ofauvarque/DocV4/KosmosV4System/mainDocumentation.md

<details open>
  <summary> Sommaire </summary>
  
  1. [Assemblage du caisson vidéo](doc/01_Video.md)
  2. [Assemblage du caisson batterie](doc/02_Batterie.md)
  3. [Assemblage du caisson moteur](doc/03_Moteur.md)
</details>

<!---
> [!NOTE]
> Ces ouvertures permettront de placer les connecteurs.

> [!TIP]
> Réaliser une ouverture supplémentaire pour que l'air puisse circuler et refroidir le système
>
> Si votre boitier est différent réfléchisser à la meilleur manière de l'organiser à l'intérieur
-->
