ofauvarque/DocV4/MagpiSystem/mainDocumentation.md

# **Contexte**

# **Assemblage du système**

Cette partie détaille le montage de la partie étanchétité puis l'installation de tous les composants au sein de cette dernière. L'objectif est d'obtenir le système suivant :

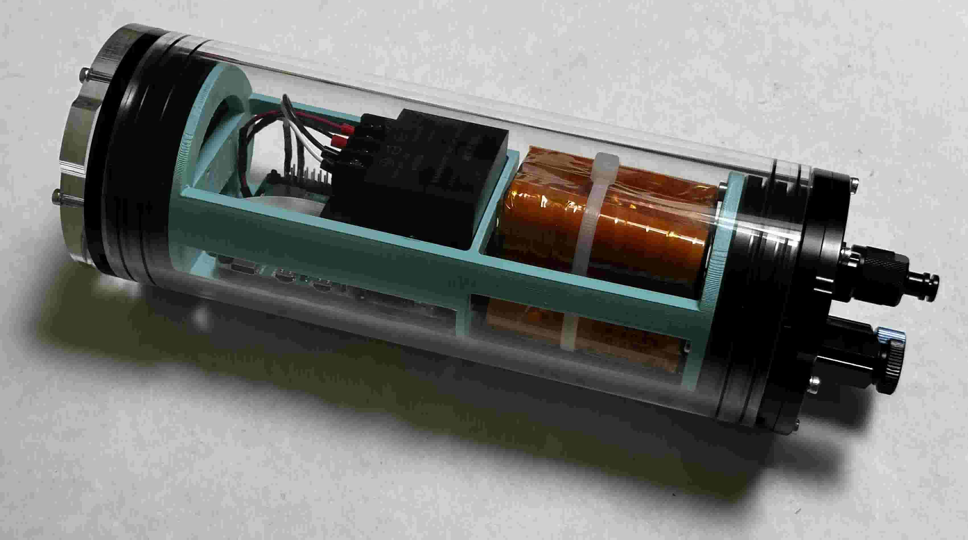
[picture p1: MagpiSystem/doc/pictures/05_Assemblage/finished.jpg]
Caisson
||
|:--:|
|*Caisson assemblé*|

## **Outils nécessaires**

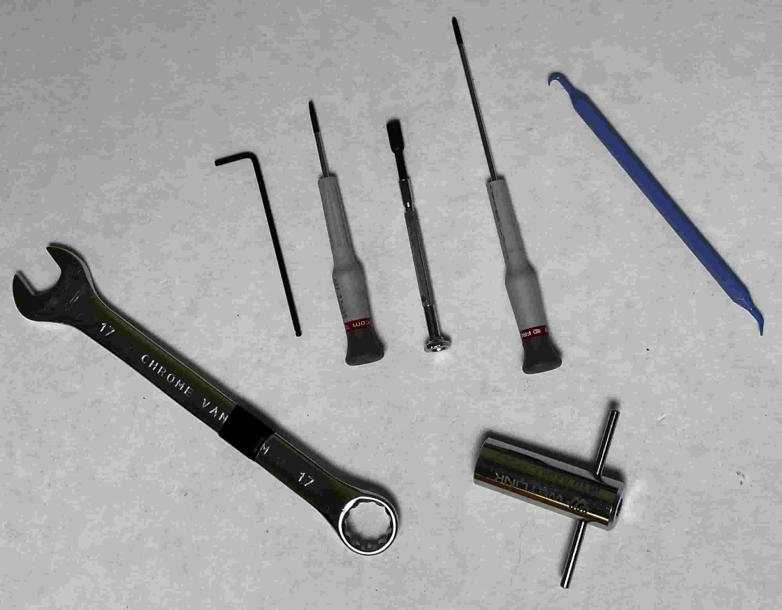
[picture p2: MagpiSystem/doc/pictures/05_Assemblage/tool_overview.jpg]
Outils


- **Clé de 17 et Clé WetLink M10**
- **Clé allen, tournevis plat/cruciforme**
- **O-ring pick**

## Assemblage du caisson étanche

Le constructeur des composants hermétique propose un tutoriel expliquant l'assemblage des bouchons du caisson avec graissage des joints : **[ici](https://youtu.be/G6PqEsKjxHM)**.

### Partie Hublot

Suivre le tutoriel précédent pour réaliser la partie "hublot"

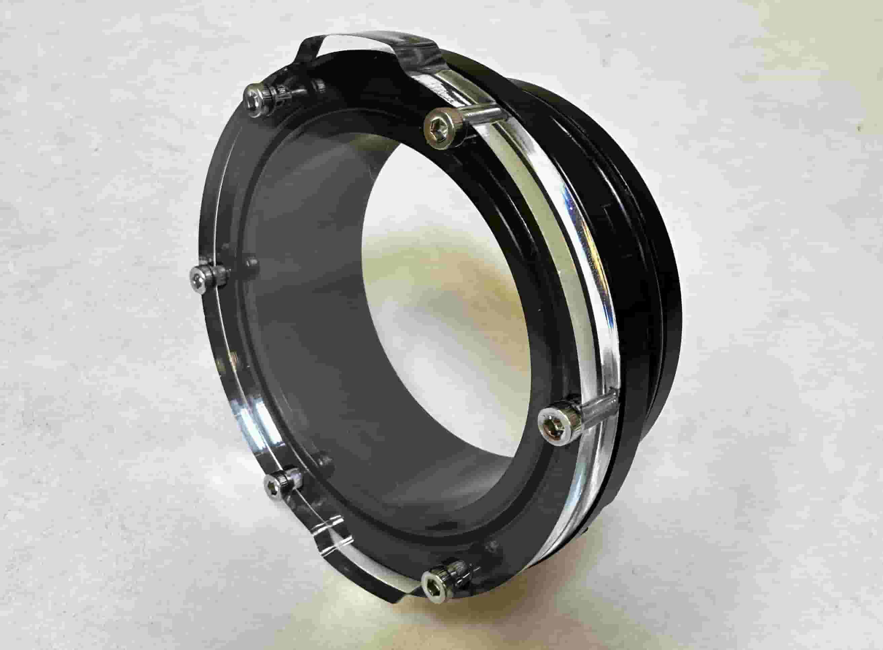
[picture p3: MagpiSystem/doc/pictures/05_Assemblage/hublot.jpg]
Hublot


### Partie connecteurs

On installe d'abord le switch, le port de charge 3 pin, la vis de purge et enfin le bouchon sur le côté en aluminium.

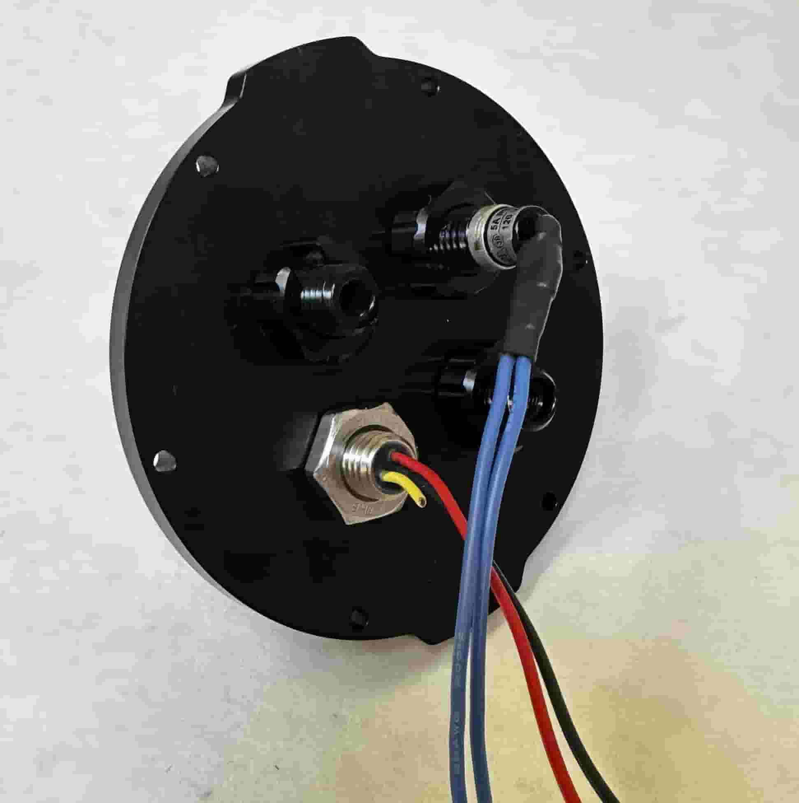
[picture p4: MagpiSystem/doc/pictures/05_Assemblage/end_cap_cables.jpg]
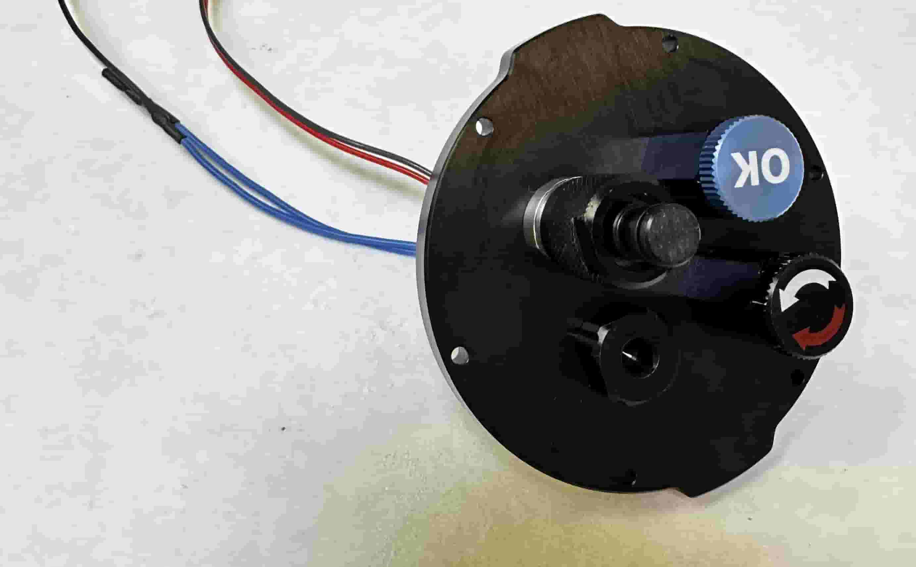
[picture p5: MagpiSystem/doc/pictures/05_Assemblage/end_cap.jpg]
 

Suivre le tutoriel pour assembler le bouchon 4 trous avec les connecteurs avec le flange. 

### Fabrication des brides de sécurité

Dévisser la vis de purge puis assembler les deux flanges et le tube en vérifiant que les détrompeurs sont bien à leur place. Insérer les deux brides de sécurité dans la gorge des deux flanges. Couper ces brides de sorte à ne laisser qu'1 cm dépasser. Mettre sur ce cm la bague et la serrer fermement.  

## Assemblage de l'électronique interne

### Composants nécessaires

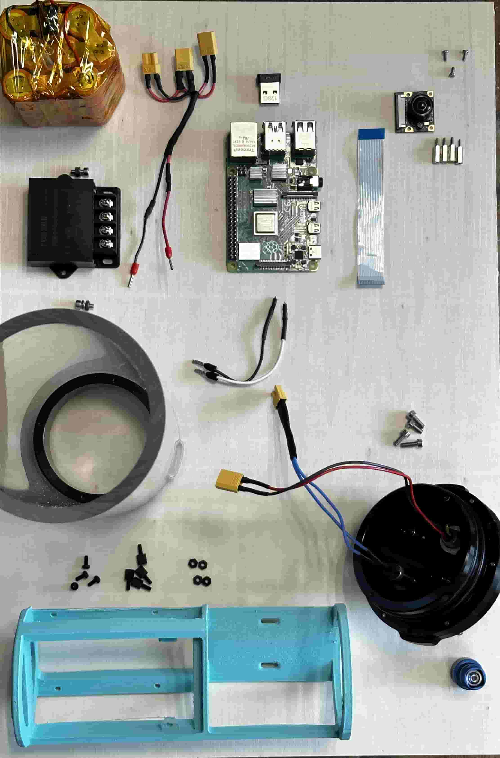
[picture p6: MagpiSystem/doc/pictures/05_Assemblage/avant_assemblage.jpg]
Composants système


- **Batterie**
- **Connecteur pieuvre**
- **Raspberry Pi**
- **Convertisseur 12V-5V**
- **Camera et sa nappe**
- **Câbles d'alimentation du Raspberry**
- **Support 3D**

### Assemblage

Fixer la flange connecteurs sur le support 3D.

Fixer ensuite le convertisseur :

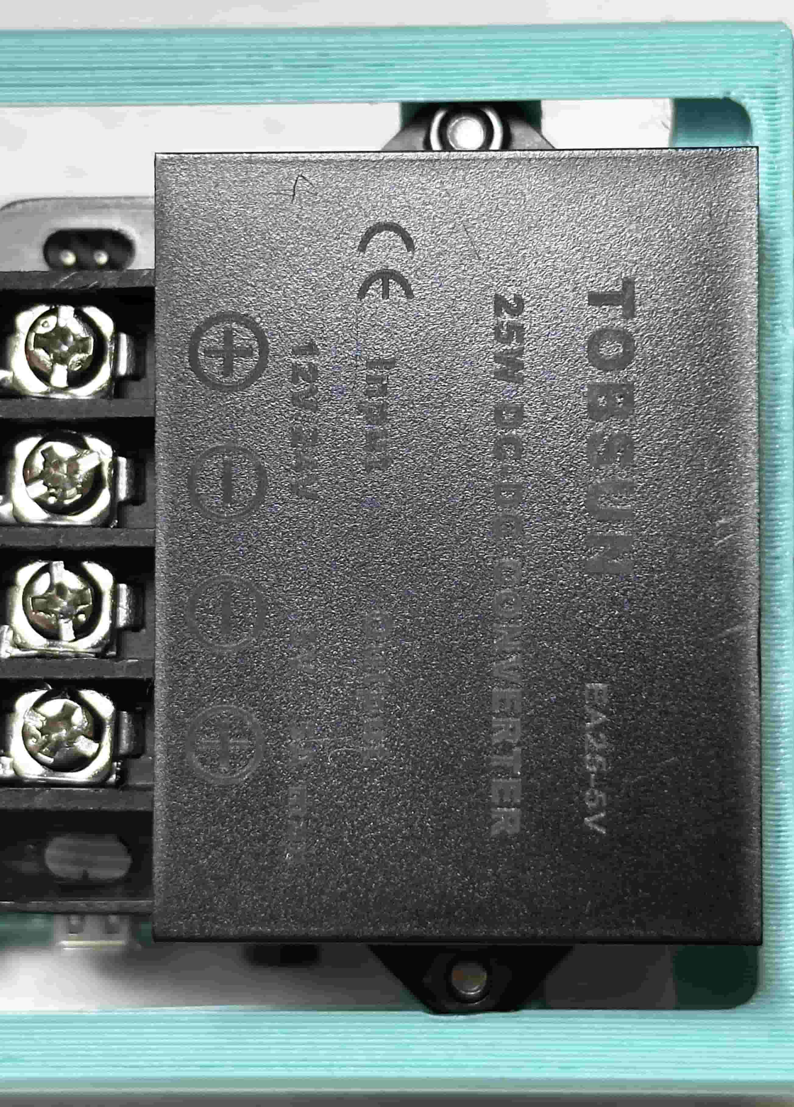
[picture p7: MagpiSystem/doc/pictures/05_Assemblage/convertisseur.jpg]
Convertisseur


Fixer la Raspberry Pi sur le support 3D. Y connecter la nappe caméra :

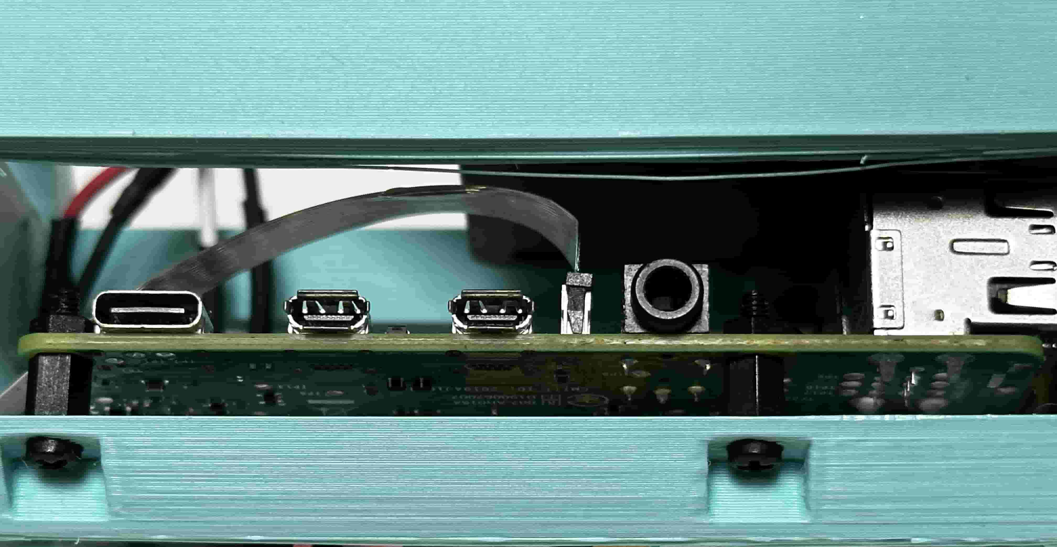
[picture p8: MagpiSystem/doc/pictures/05_Assemblage/raspberry.jpg]
Raspberry


La batterie est ensuite installé et fixée avec un serre flex, qui passe dans les encoches du support. Les câbles de la batterie passent sous la carte raspberry. Les câbles de charge et du switch sont aussi coincés par le serre flex et passent eux aussi sous la carte.

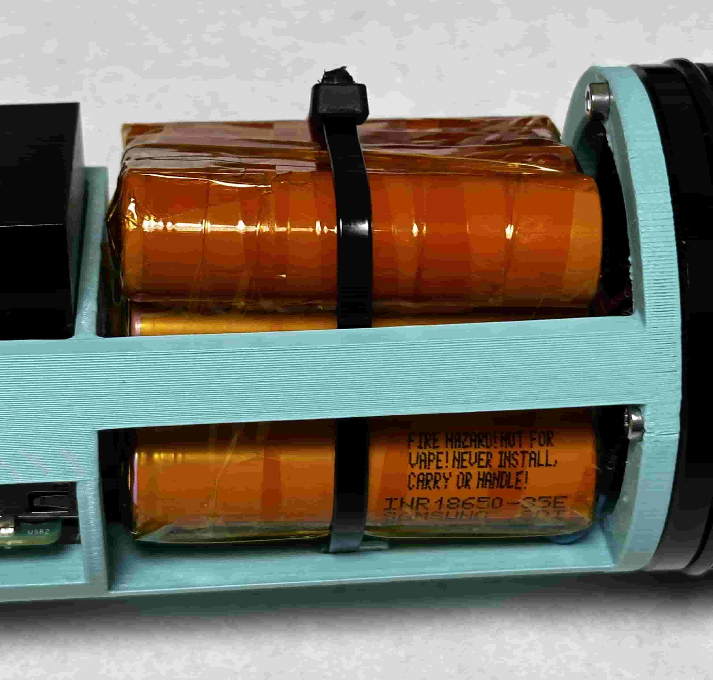
[picture p9: MagpiSystem/doc/pictures/05_Assemblage/batterie.jpg]
Batterie


### Cablage

La pieuvre est connectée aux différents éléments, en respectant bien le schéma de câblage.

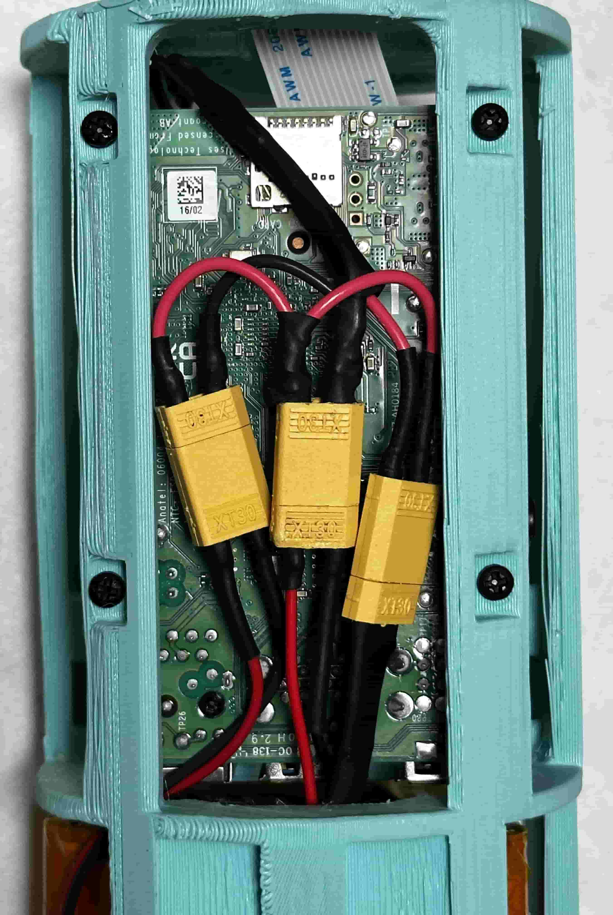
[picture p10: MagpiSystem/doc/pictures/05_Assemblage/câblage.jpg]
Câblage
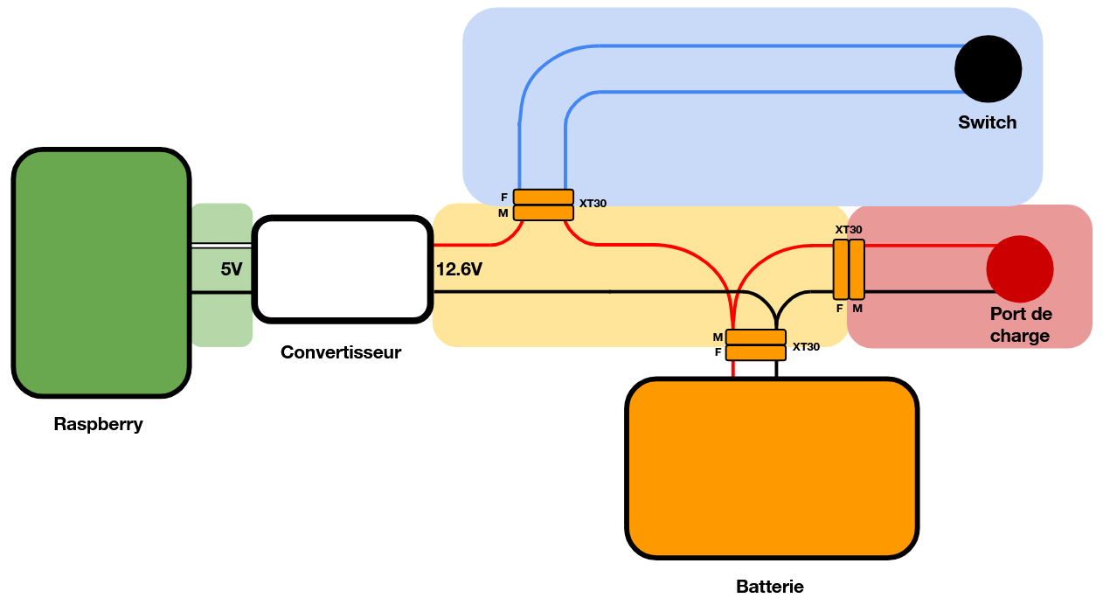
[picture p11: MagpiSystem/doc/pictures/04_Câblage/schema_cablage_couleurs.png]
Câblage
  

Les câbles sertis de la pieuvre sont connectés au convertisseur, les câbles d'alimentation de la rapsberry sont branchés sur les pin 1 et 3 de la carte.

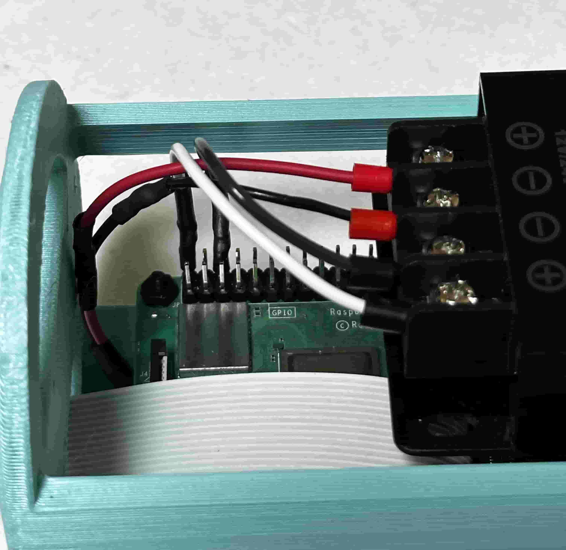
[picture p12: MagpiSystem/doc/pictures/05_Assemblage/alim_convertisseur.jpg]
Alim convertisseur


### Caméra
Fixer les entretoises sur le support 3D puis y visser la carte caméra. Brancher enfin la nappe.

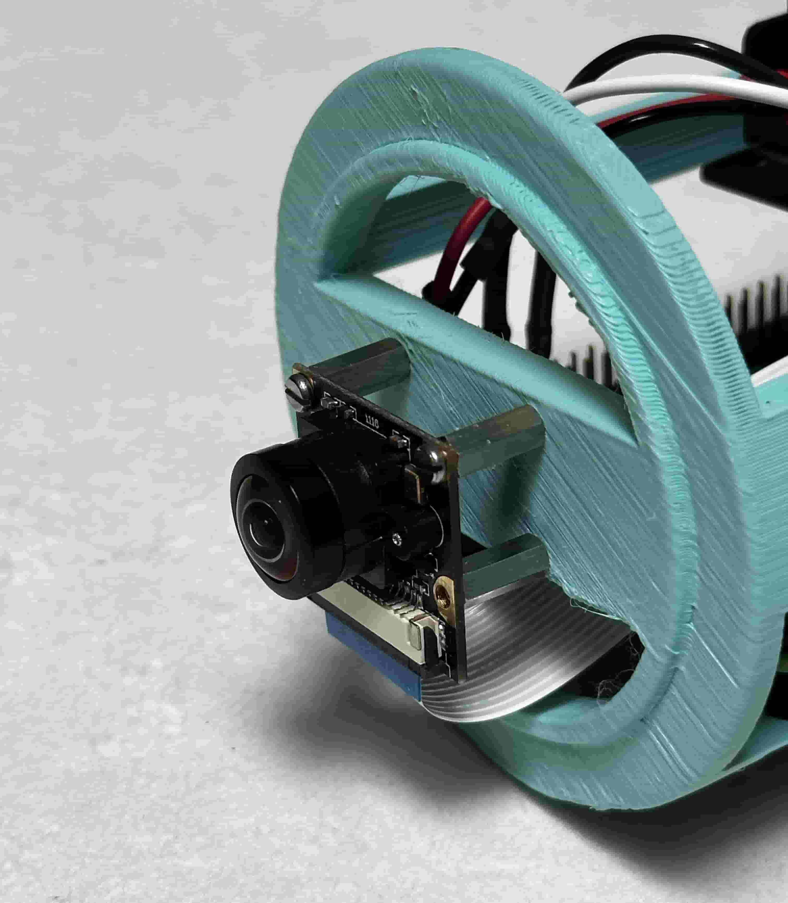
[picture p13: MagpiSystem/doc/pictures/05_Assemblage/camera.jpg]


## Installation du logiciel MagPi

Suivre les instructions de la [page web](https://github.com/KonkArLab/kosmos_software/blob/main/README.md)

Insérer enfin l'électronique dans le caisson étanche puis placer la flange hublot. Placer les brides et revisser la vis de purge.
Le système est prêt à être utilisé.

Alim convertisseur

# Mode d'emploi
