ofauvarque/DocV4/KosmosV4System/doc/01_Video.md

# Intégration mécanique & électronique interne

## Impression de la structure 3D

Imprimer la structure mécanique à l'aide d'une imprimante 3D filaire.

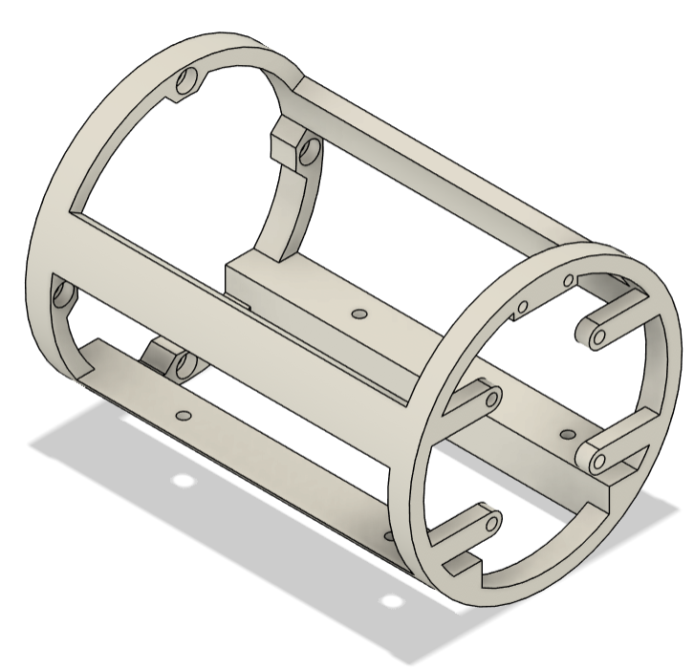
[picture p14: KosmosV4System/doc/pictures/V4_Video/Structure.PNG]


## Fixation du capteur d'ambiance lumineuse RGB

- Souder le connecteur JST 4 pin sur les bornes GND 3.3V SDA SCL de la carte électronique du capteur. (La borne INT est inutilisée.) ATTENTION, les soudures se font du côté du capteur lumineux.

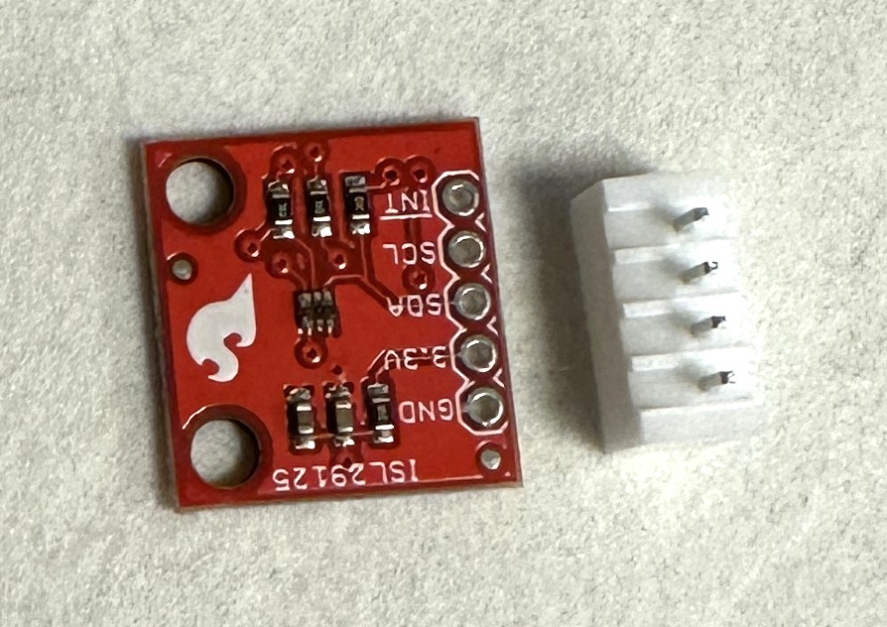
[picture p15: KosmosV4System/doc/pictures/V4_Video/IMG_1317.JPG]
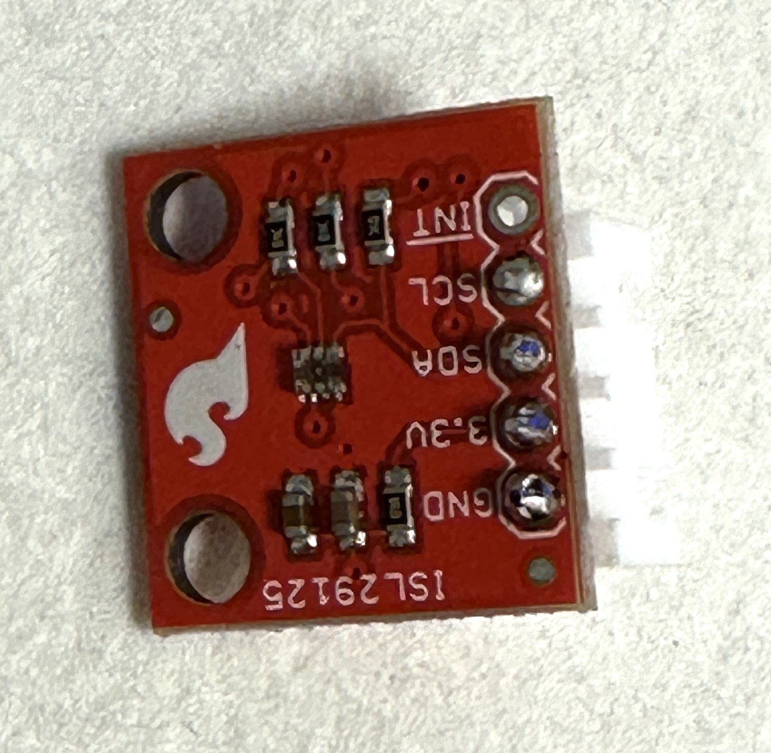
[picture p16: KosmosV4System/doc/pictures/V4_Video/IMG_1321.JPG]
 

- Sur la structure mécanique, préformer les deux trous destinés à accueillir le capteur à l'aide d'un boulon de diamètre 2.5 mm.
- Fixer le capteur sur la structure mécanique à l'aide de boulons de diamètres 2.5 mm et de longueur 6 mm. (Des boulons plus longs peuvent être utilisés mais ils ne doivent pas dépasser de la structure.)

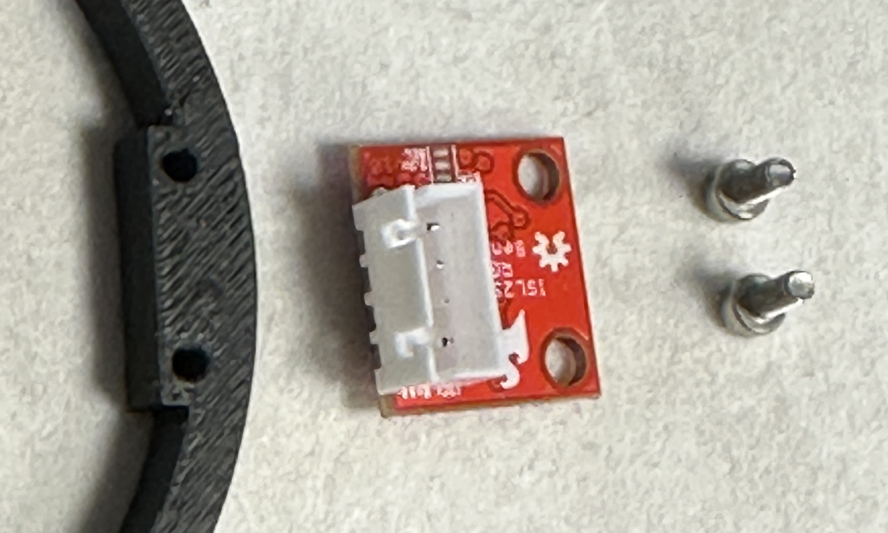
[picture p17: KosmosV4System/doc/pictures/V4_Video/IMG_1322.JPG]
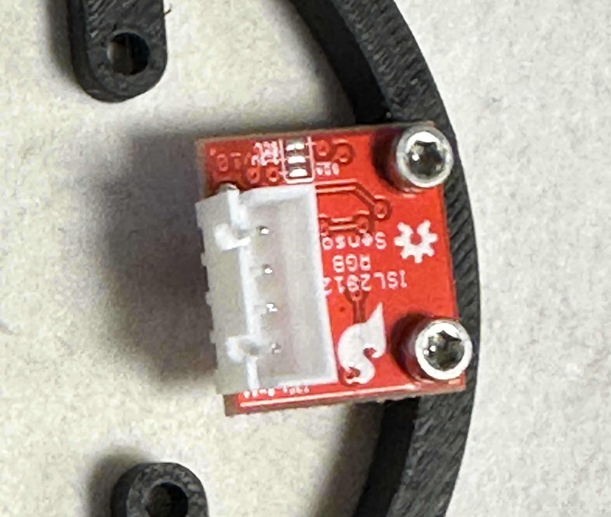
[picture p18: KosmosV4System/doc/pictures/V4_Video/IMG_1323.JPG]
 

## Fixation de la caméra
Pour un rendu de couleurs proche de celui de l'oeil humain, le capteur Picam HQ est équipé d'un filtre infra-rouge se matérialisant par une petite vitre bleue-verte devant le capteur. Ce filtre en plus de couper les infrarouges, atténue également une partie de la lumière rouge. Or celle-ci est déjà fortement atténuée par l'eau de mer. Afin d'éviter une telle perte inutile, le filtre IR du capteur Picam de KOSMOS doit être enlevé. Pour ce faire, un excellent tutoriel existe sur le site officiel de raspberry :  

https://www.raspberrypi.com/documentation/accessories/camera.html#ir-filter

A l'issue de cette opération, on obtient un capteur Picam HQ sans filtre IR (qui n'aura plus d'utilité par la suite).

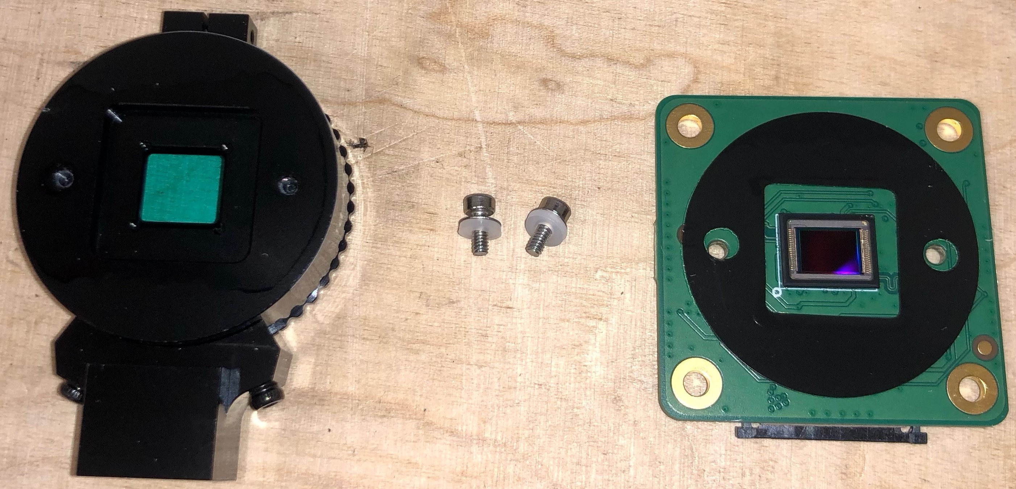
[picture p19: KosmosV4System/doc/pictures/V4_Video/11.jpeg]
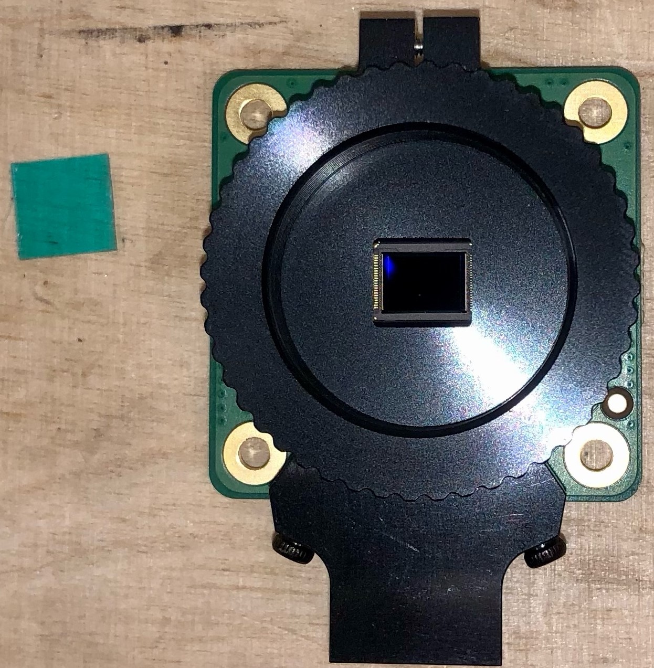
[picture p20: KosmosV4System/doc/pictures/V4_Video/9.jpeg]
 

- Oter également le support de la vis caméra.

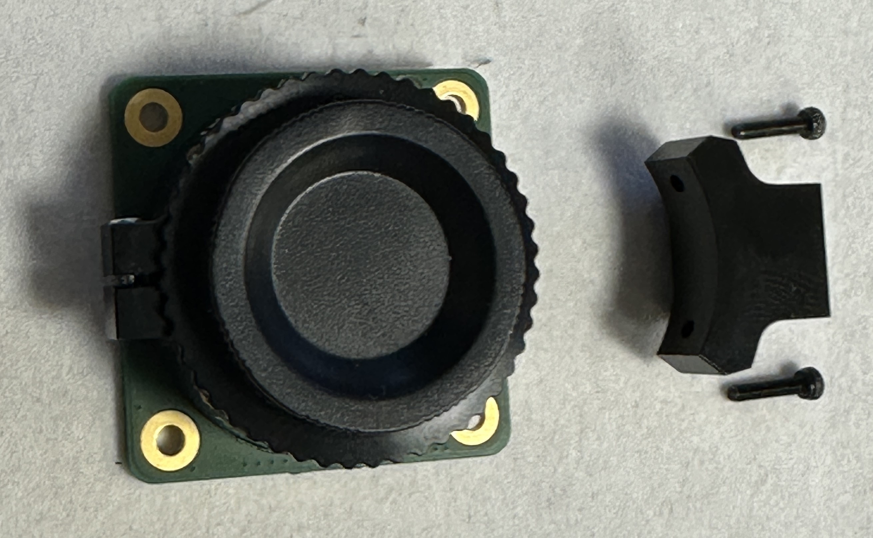
[picture p21: KosmosV4System/doc/pictures/V4_Video/IMG_1326.JPG]
 

- Fixer la capteur caméra sur la structure à l'aide de 4 boulons (diamètre 2.5 mm  et longueur 10 mm) et de 4 écrous. Attention à respecter l'orientation de la carte. 

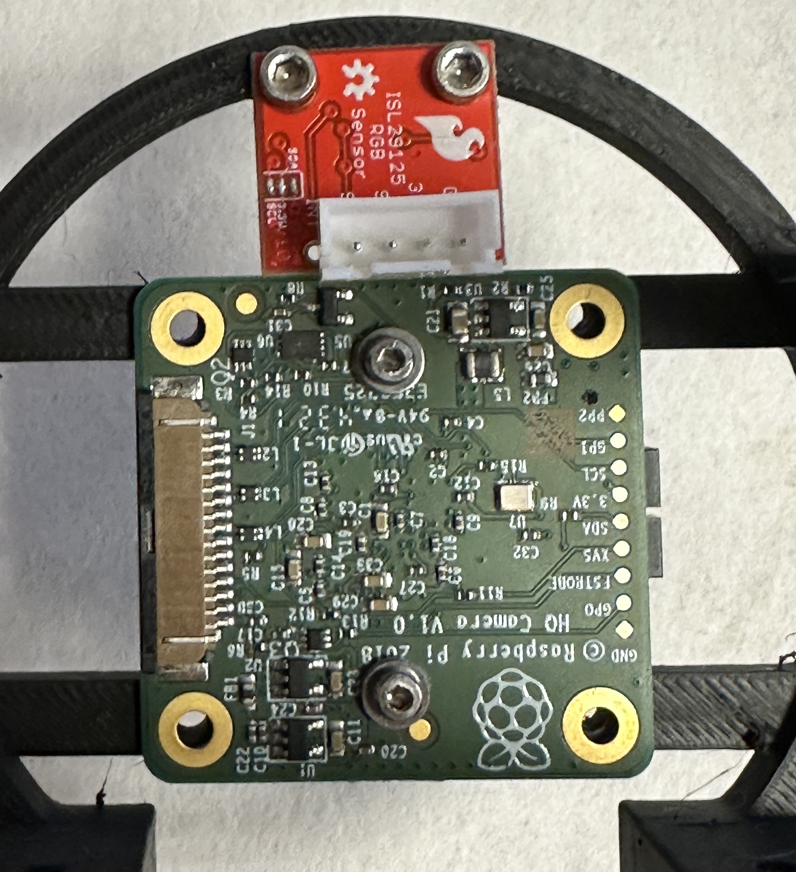
[picture p22: KosmosV4System/doc/pictures/V4_Video/IMG_1327.JPG]
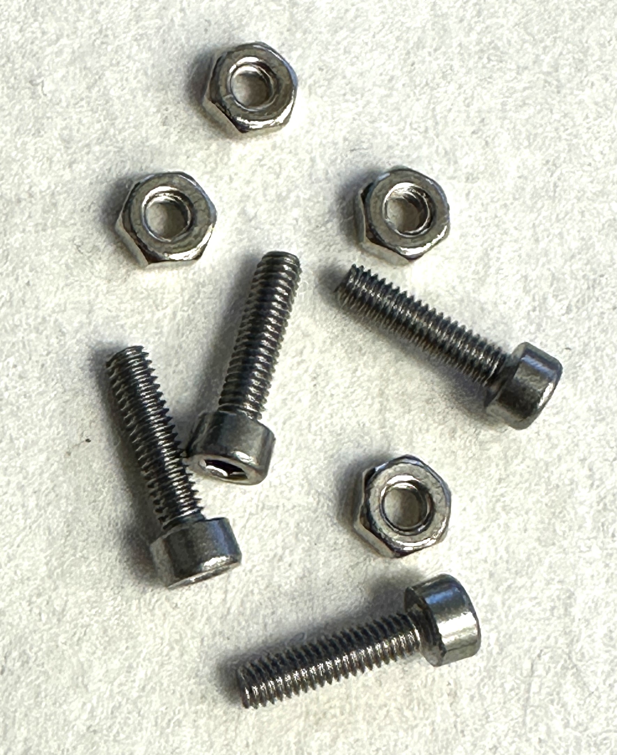
[picture p23: KosmosV4System/doc/pictures/V4_Video/IMG_1328.JPG]
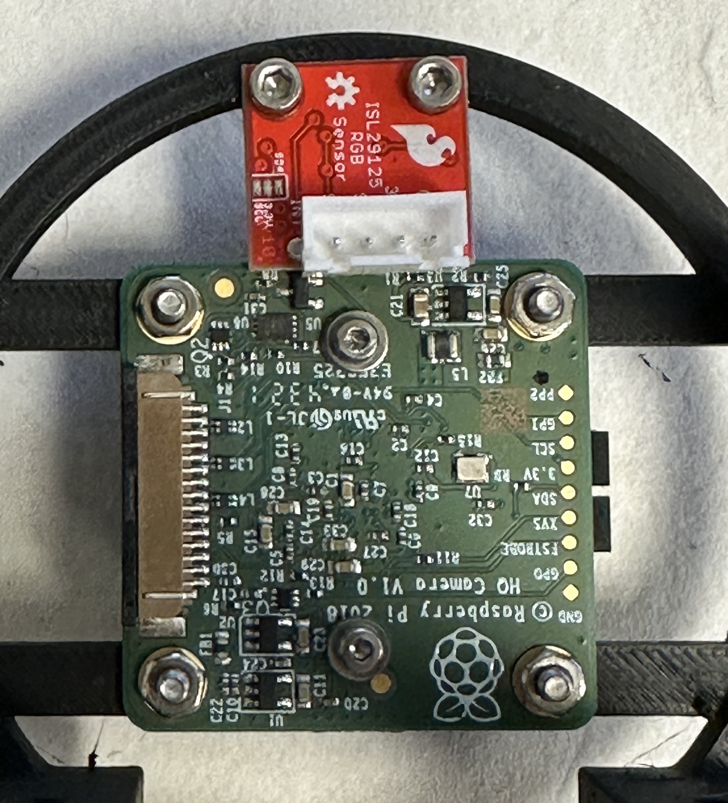
[picture p24: KosmosV4System/doc/pictures/V4_Video/IMG_1329.JPG]
   

## Fixation de la Raspberry Pi 

- Fixer les radiateurs sur la carte RPi.  Connecter ensuite le RTC à la RPi via le port BAT. Fixer la pile du RTC au dessus du port Ethernet avec le double face fourni avec le RTC. 

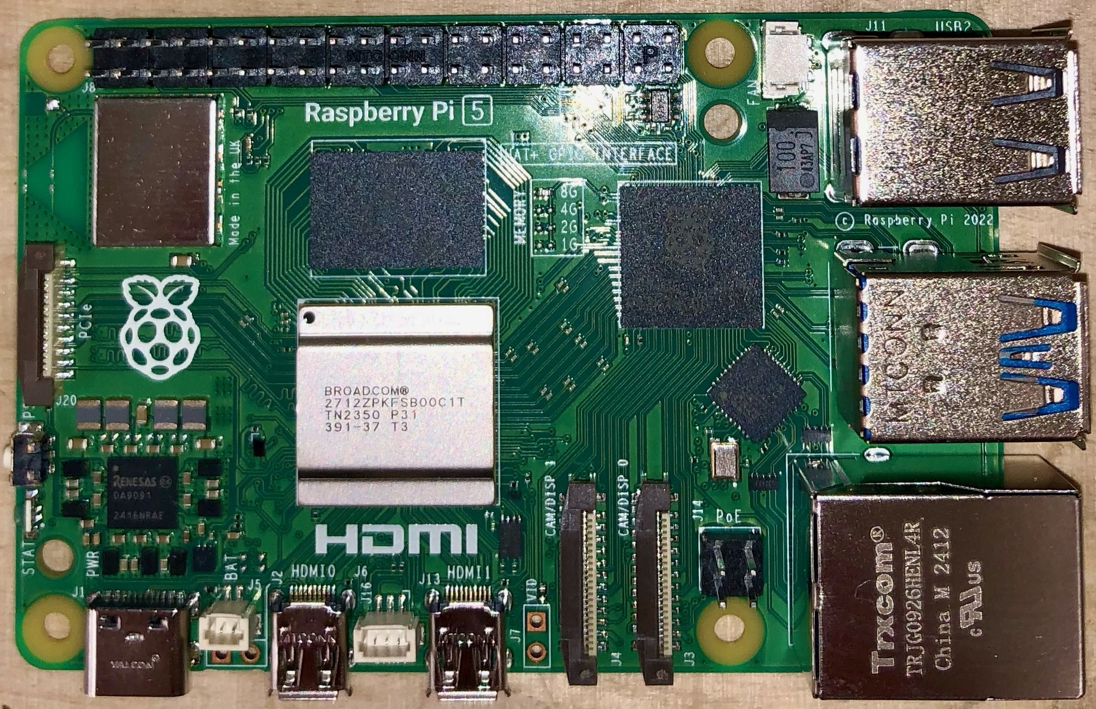
[picture p25: KosmosV4System/doc/pictures/V4_Video/19_2.jpeg]
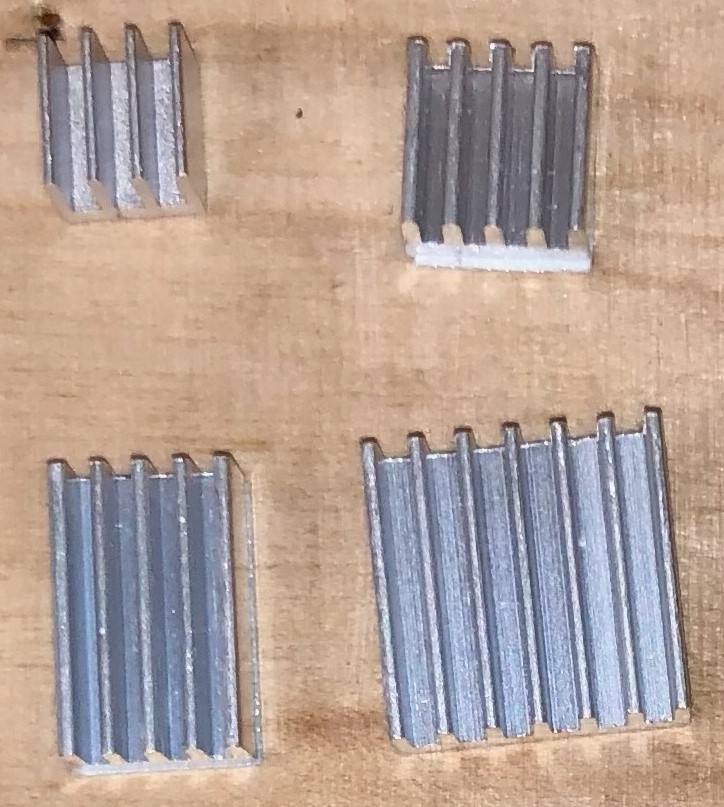
[picture p26: KosmosV4System/doc/pictures/V4_Video/19.jpeg]
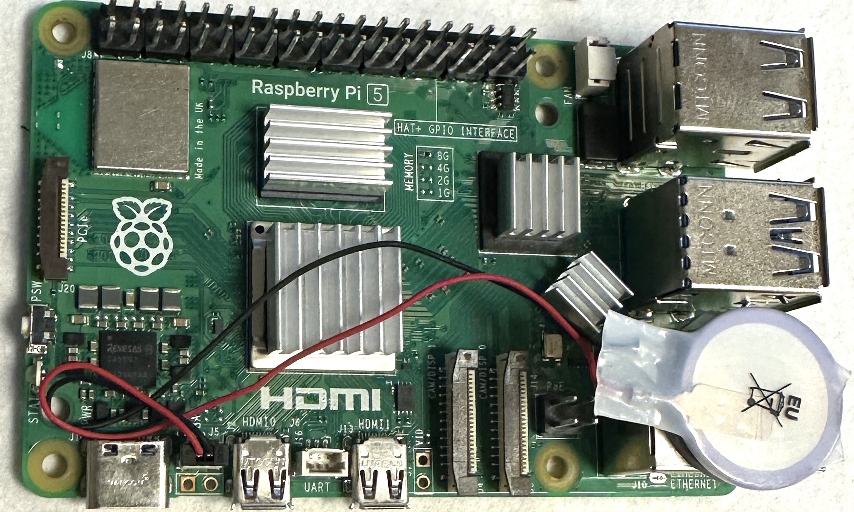
[picture p27: KosmosV4System/doc/pictures/V4_Video/IMG_13300.JPG]
  

- Assembler 4 boulons (diamètre 2.5 mm et longueur 10 mm) et 4 écrous sur chacun des trous de la RPi de la structure mécanique. Les écrous permettront de surélever légèrement la carte.

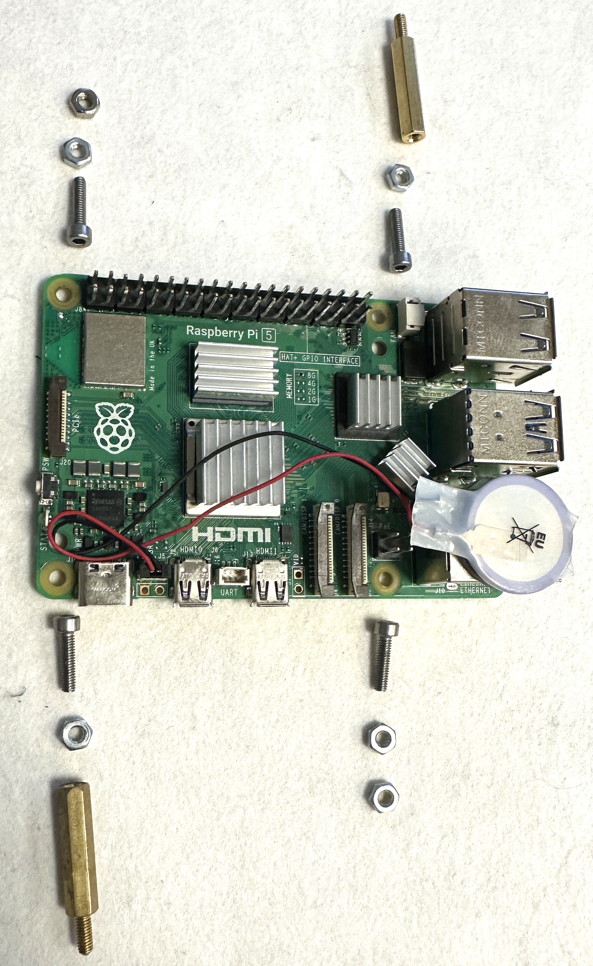
[picture p28: KosmosV4System/doc/pictures/V4_Video/IMG_1330.JPG]
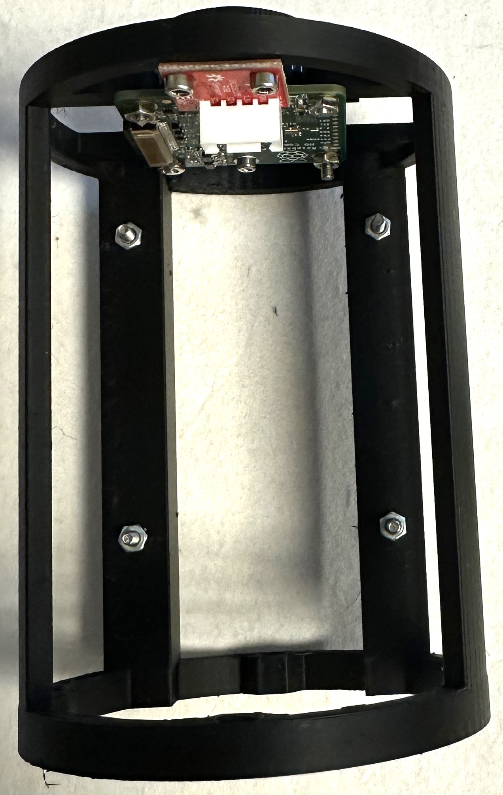
[picture p29: KosmosV4System/doc/pictures/V4_Video/IMG_1331.JPG]
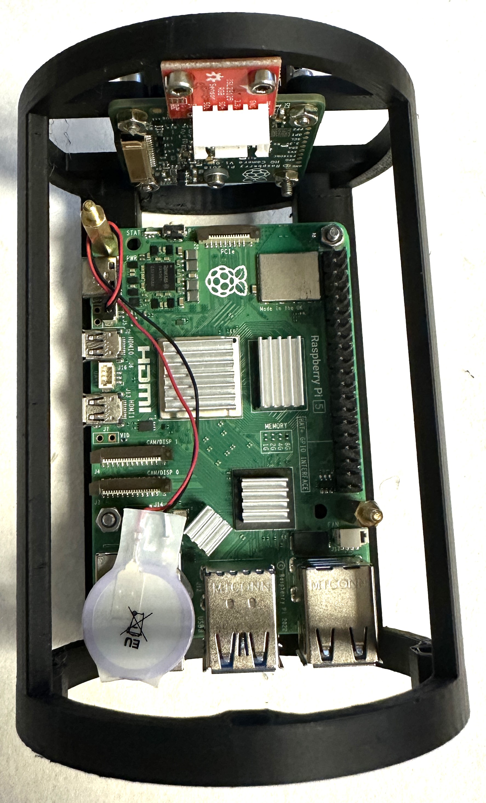
[picture p30: KosmosV4System/doc/pictures/V4_Video/IMG_1332.JPG]
  

- Positionner la carte RPi et la fixer avec deux écrous dans les coins avant droit et arrière gauche et avec deux entretoises  (diamètre 2.5 mm, hauteur 20 mm) dans les coins avant gauche et arrière droit. Connecter ensuite la nappe entre le capteur vidéo et la carte RPi.

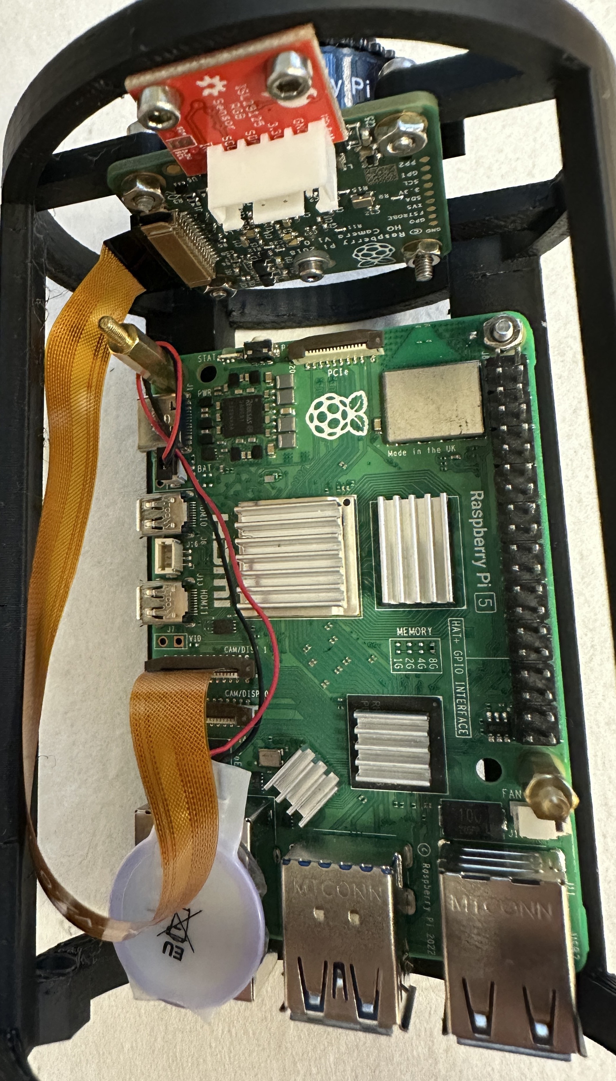
[picture p31: KosmosV4System/doc/pictures/V4_Video/IMG_1333.JPG]
 

- Insérer la clé USB dans un des deux ports USB 3.0

## Réalisation de la carte électronique

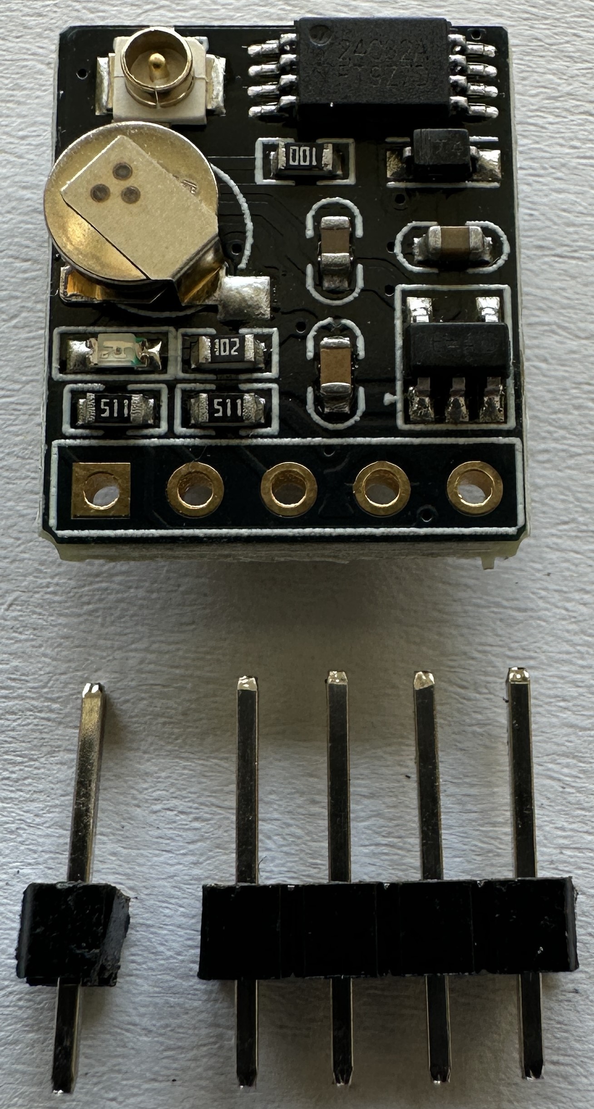
[picture p32: KosmosV4System/doc/pictures/V4_Video/IMG_0625.JPG]
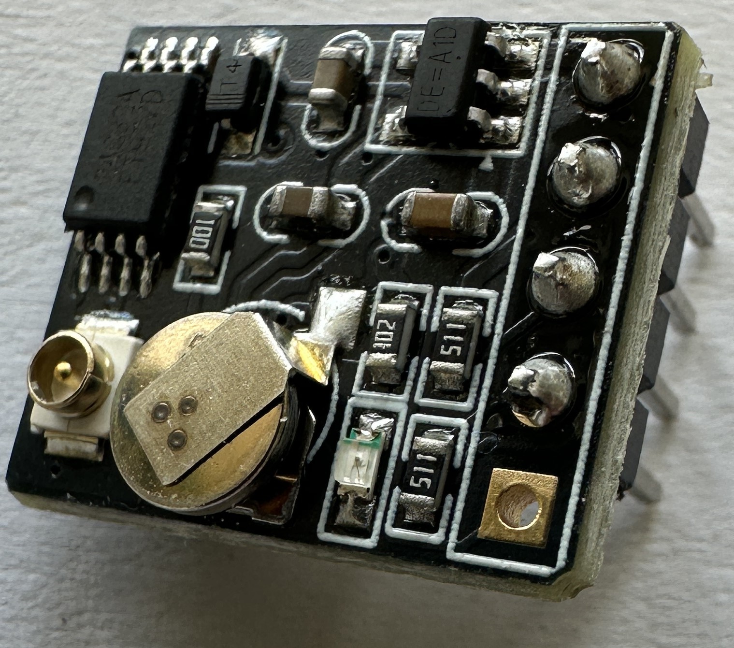
[picture p33: KosmosV4System/doc/pictures/V4_Video/IMG_0626.JPG]
 

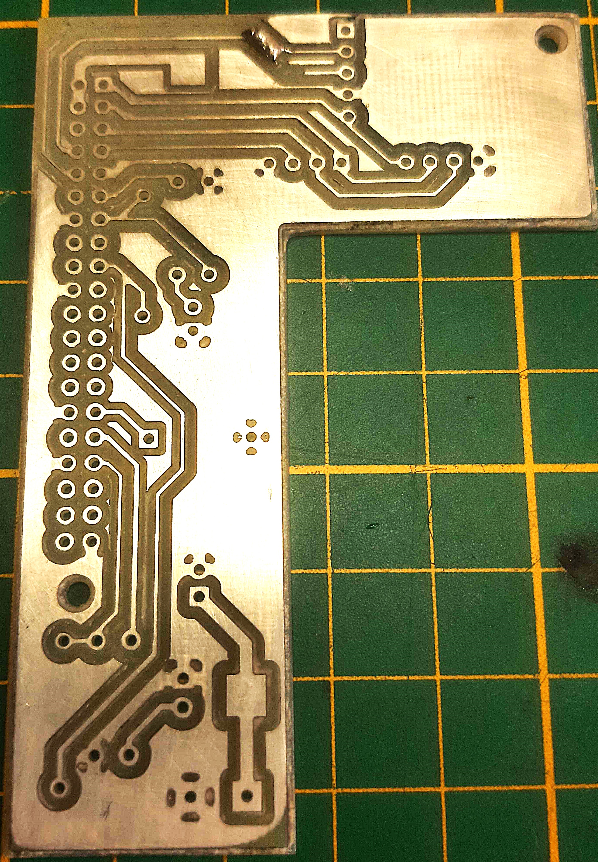
[picture p34: KosmosV4System/doc/pictures/V4_Video/20250225_141010.jpg]
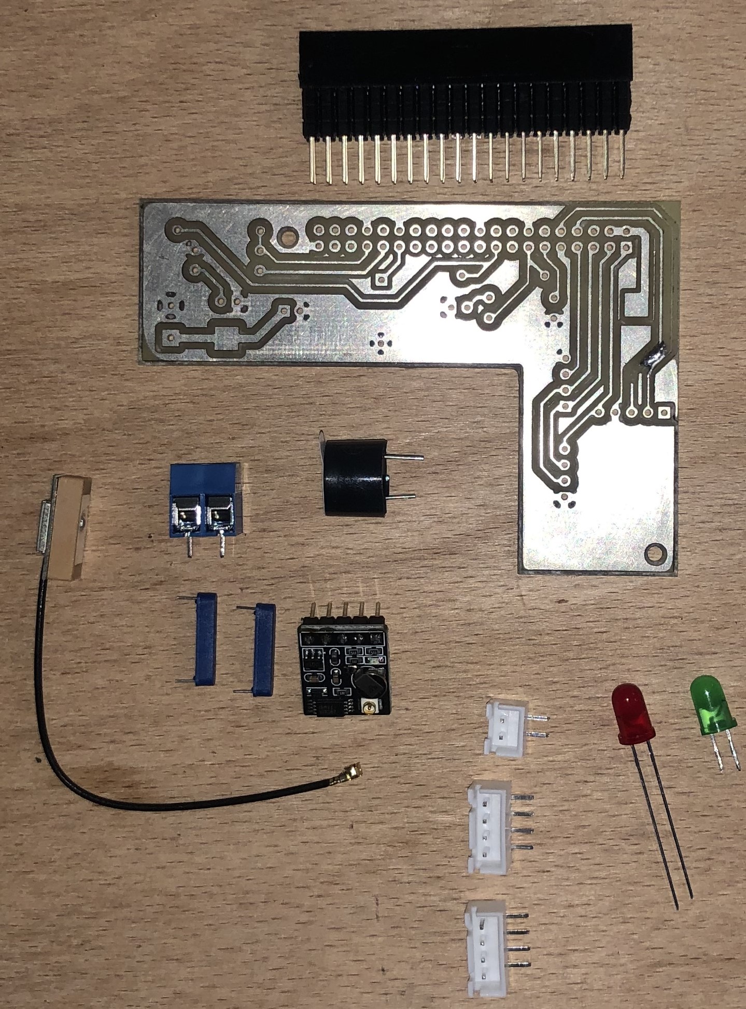
[picture p35: KosmosV4System/doc/pictures/V4_Video/IMG_1571.jpg]
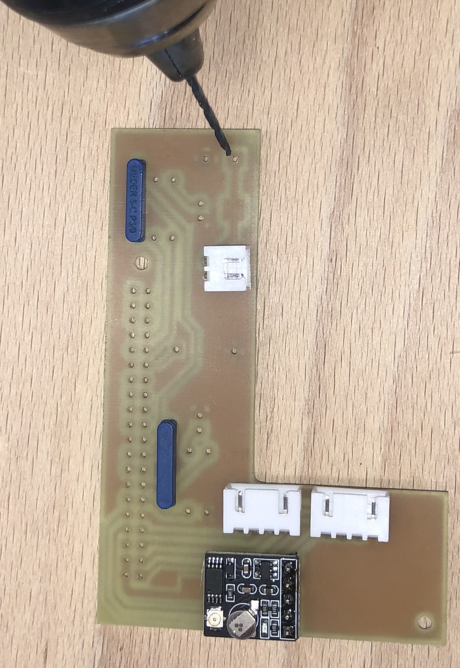
[picture p36: KosmosV4System/doc/pictures/V4_Video/IMG_1572.jpg]
  

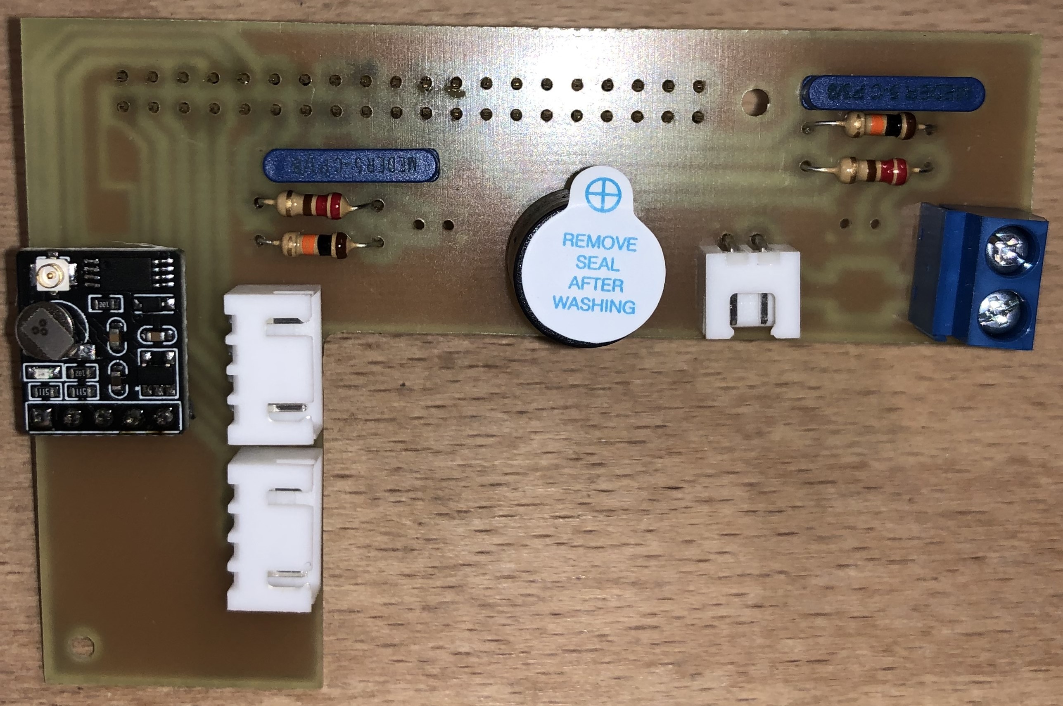
[picture p37: KosmosV4System/doc/pictures/V4_Video/IMG_1610.JPG]
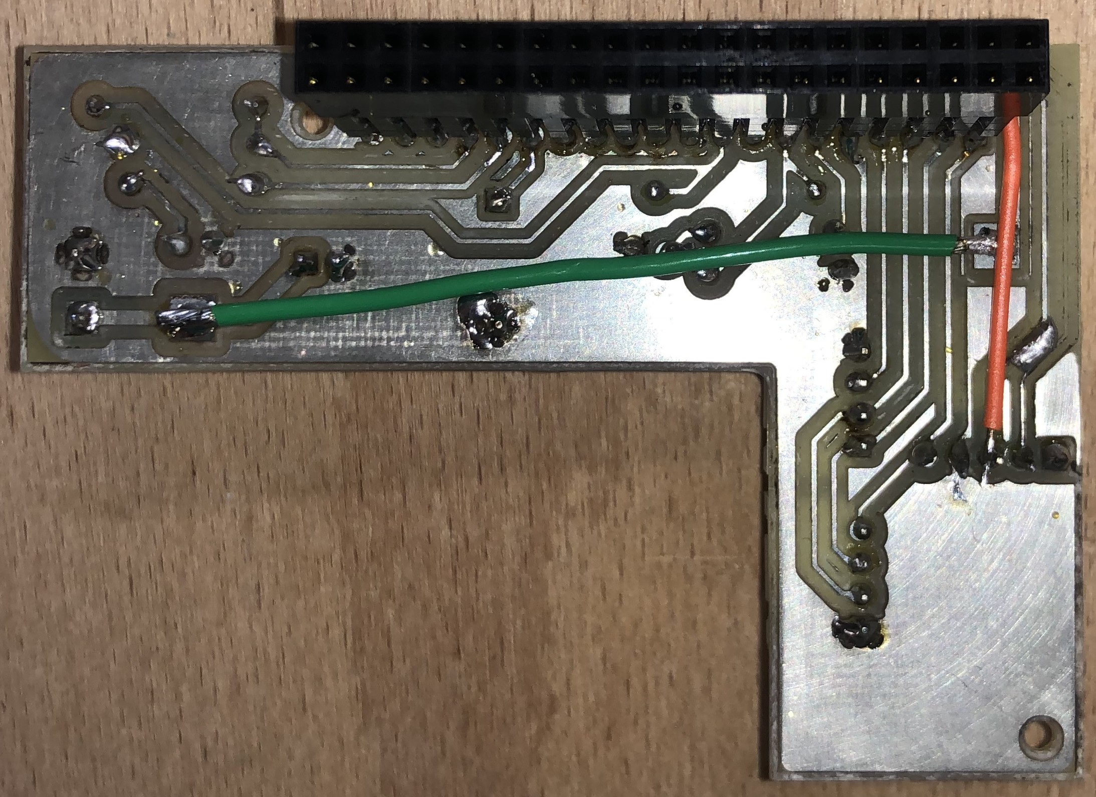
[picture p38: KosmosV4System/doc/pictures/V4_Video/IMG_1611.JPG]
 

# Réalisation du caisson étanche

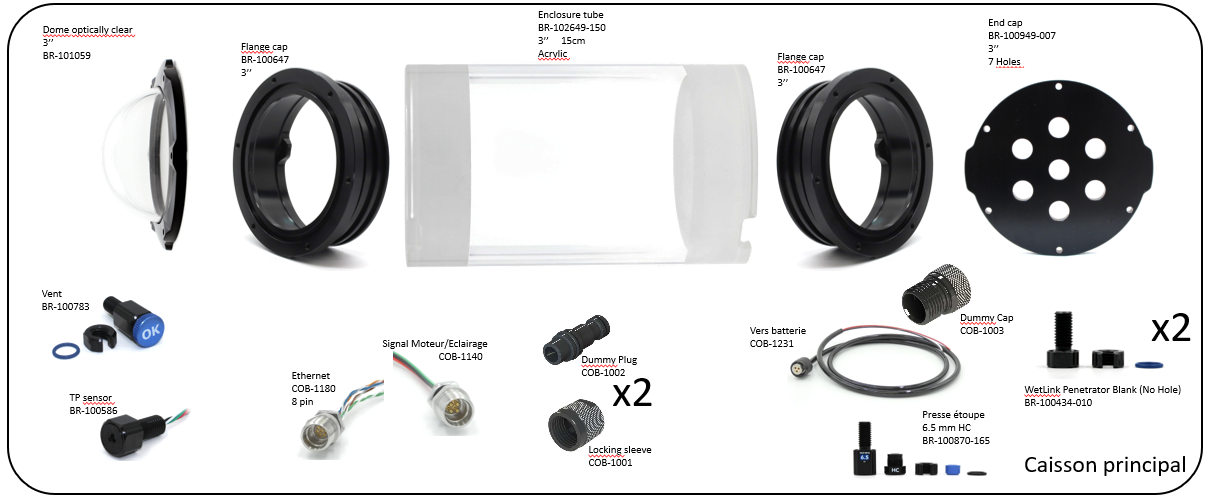
[picture p39: KosmosV4System/doc/pictures/V4_Video/VueGenerale.PNG]


## Assemblage du hublot sphérique

## Assemble du bouchon arrière

### Cable d'alimentation

- Avec une pince coupante, raccourcir le cable COB-1231 pour qu'il mesure 40 cm. Garder les fils noir, jaune et rouge. 
- Avec un cutter, enlever 10 cm de gaine noire. Attention à ne pas abimer les fils à l'intérieur. (Si c'était le cas glisser de la gaine thermoretractable au niveau de la coupure.)
- Couper le fil rouge à ras de la gaine pour ne conserver que le noir et le jaune. (On rappelle la convention : 5V jaune, masse noir, 12V rouge.)
- Dénuder les fils jaune et noir sur 7 mm.
- Y sertir des cosses dont on a vérifié qu'elles avaient le diamètre optimal.

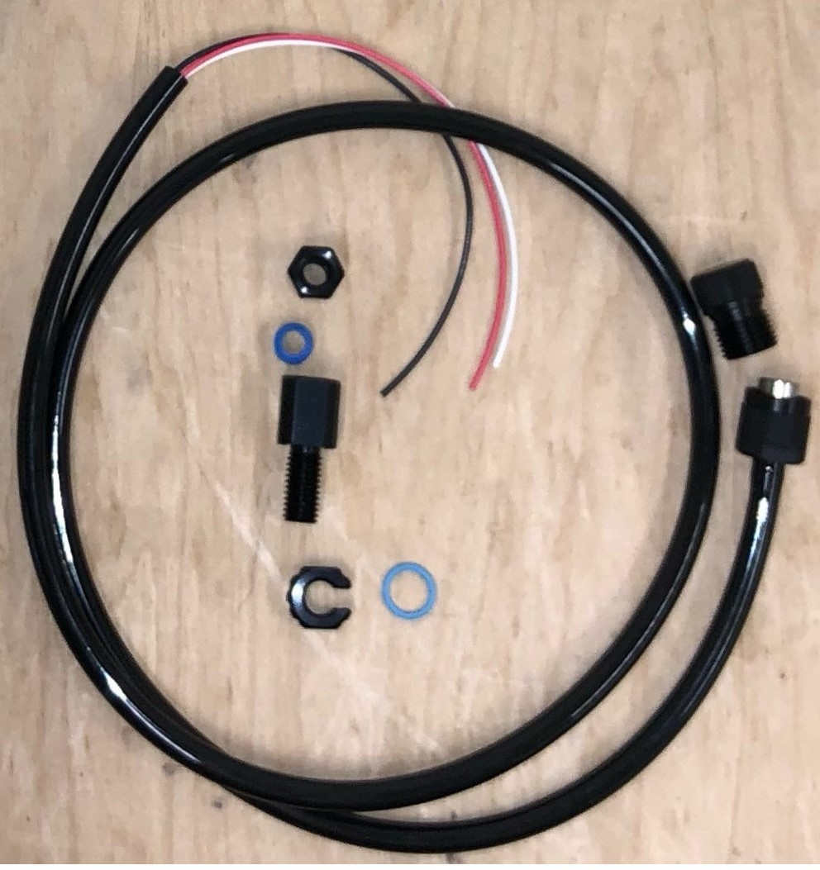
[picture p40: KosmosV4System/doc/pictures/V4_Video/FlexibleAlimentation.jpeg]
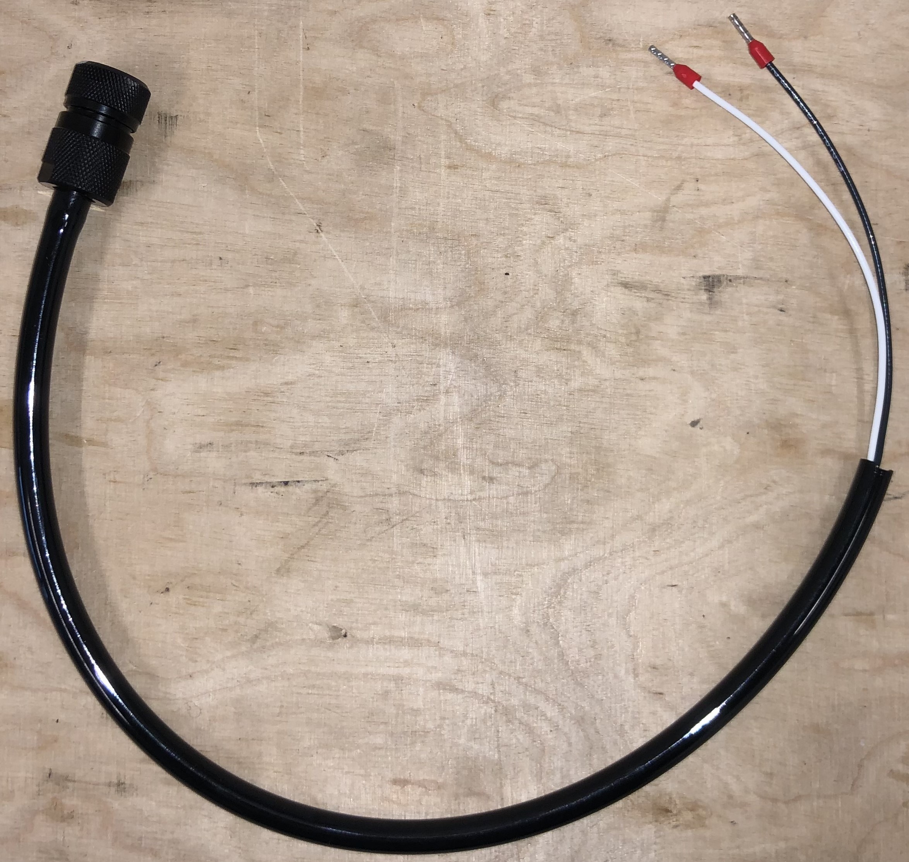
[picture p41: KosmosV4System/doc/pictures/V4_Video/IMG_1495.jpg]
 

- Suivre ensuite le tutoriel dont le lien est ci-dessous pour installer le presse étoupe

https://bluerobotics.com/learn/wetlink-penetrator-installation-guide/

https://www.youtube.com/watch?v=vigY82tsfOI&t=2s&ab_channel=BlueRobotics

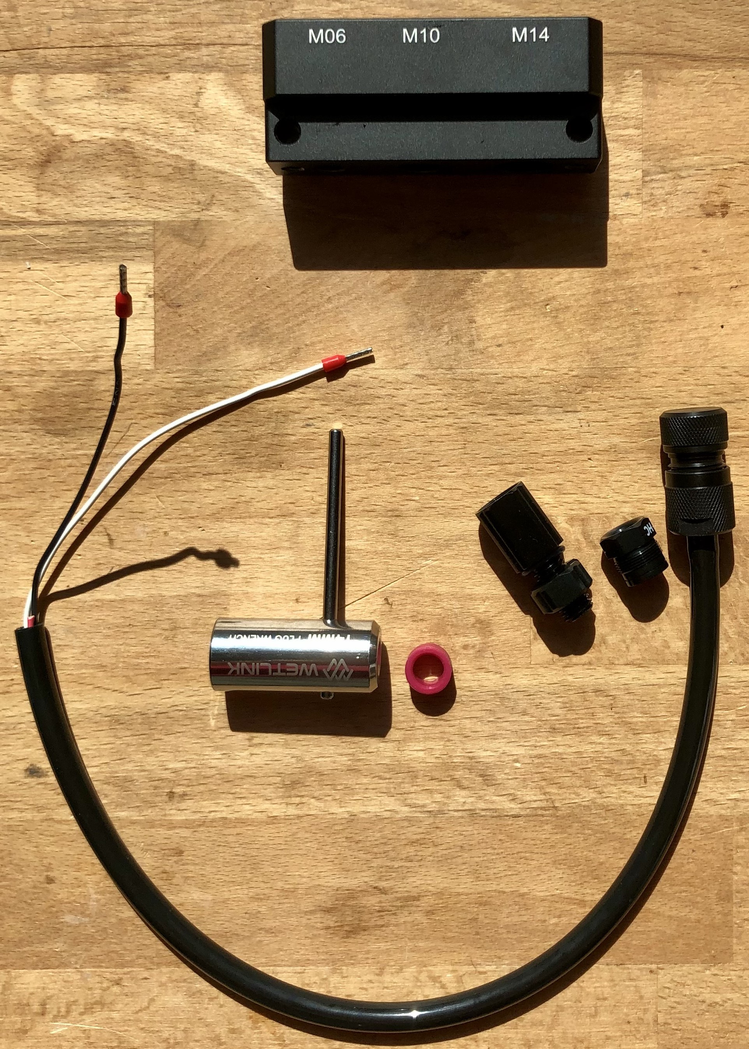
[picture p42: KosmosV4System/doc/pictures/V4_Video/IMG_1769.jpg]
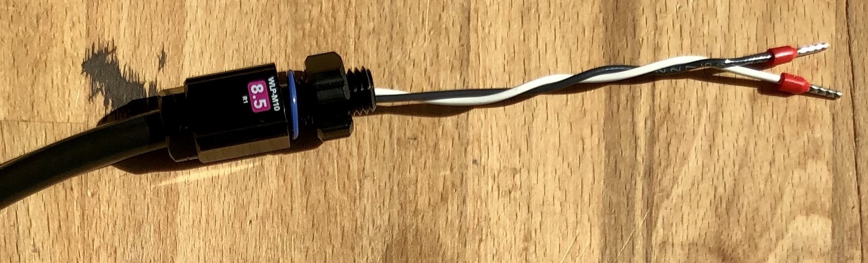
[picture p43: KosmosV4System/doc/pictures/V4_Video/IMG_1770.jpg]
 

### Assemblage de la tape connectique

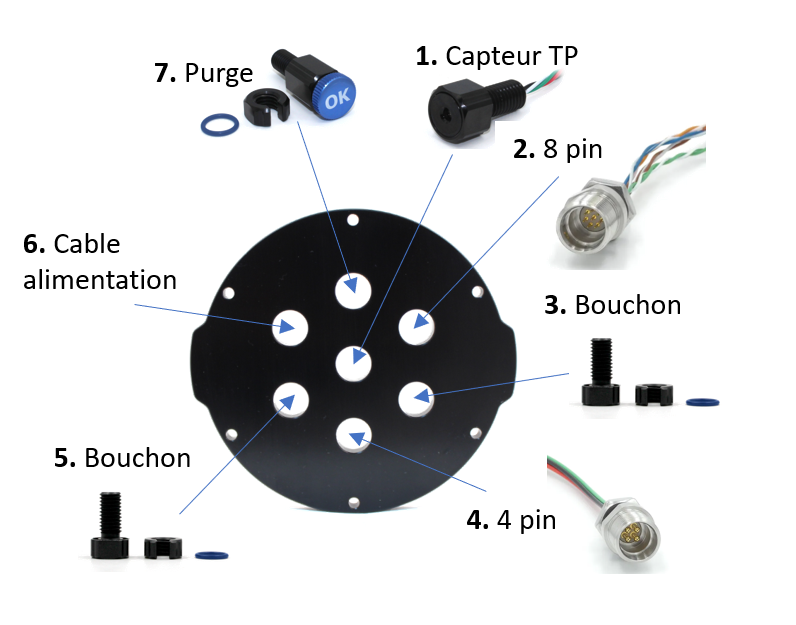
[picture p44: KosmosV4System/doc/pictures/V4_Video/TapeArriere.PNG]


- Graisser les joints de chaque éléments sur la bouchon 7 trous
- Serrer les éléments M10 sur le bouchon en suivant l'ordre indiqué sur la figure.
    
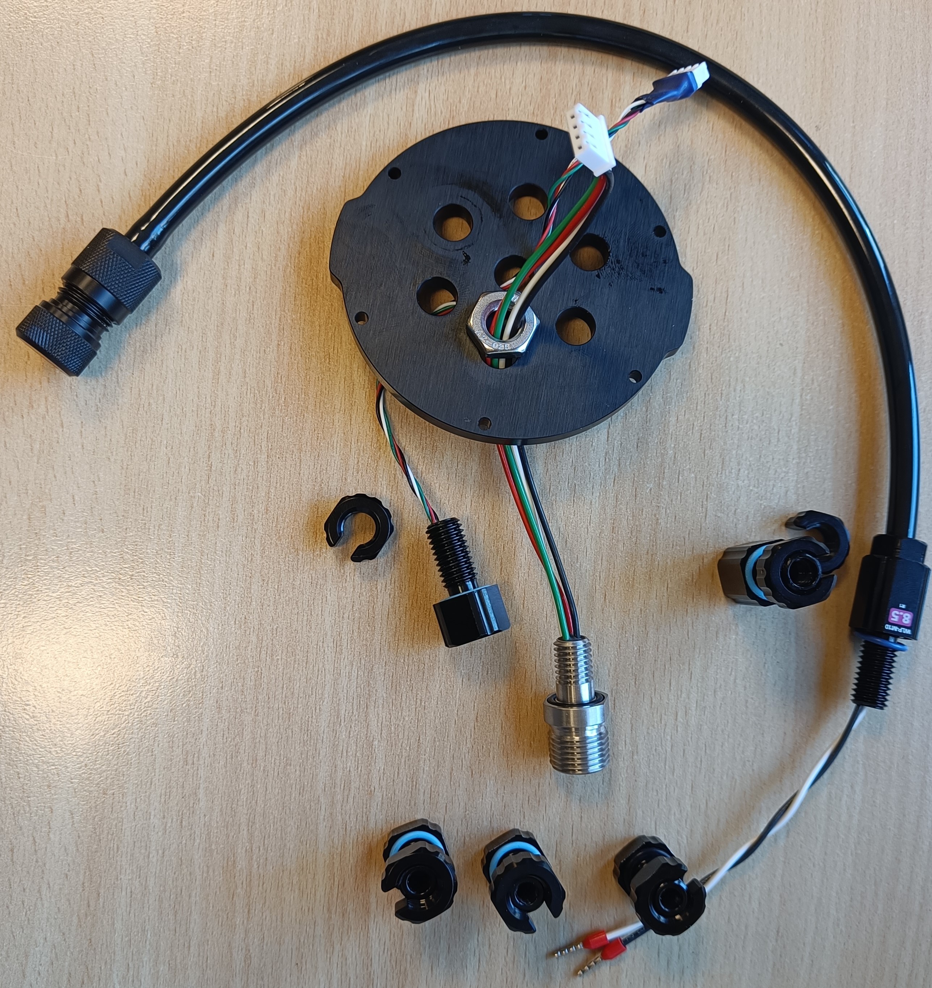
[picture p45: KosmosV4System/doc/pictures/V4_Video/IMG44.jpg]
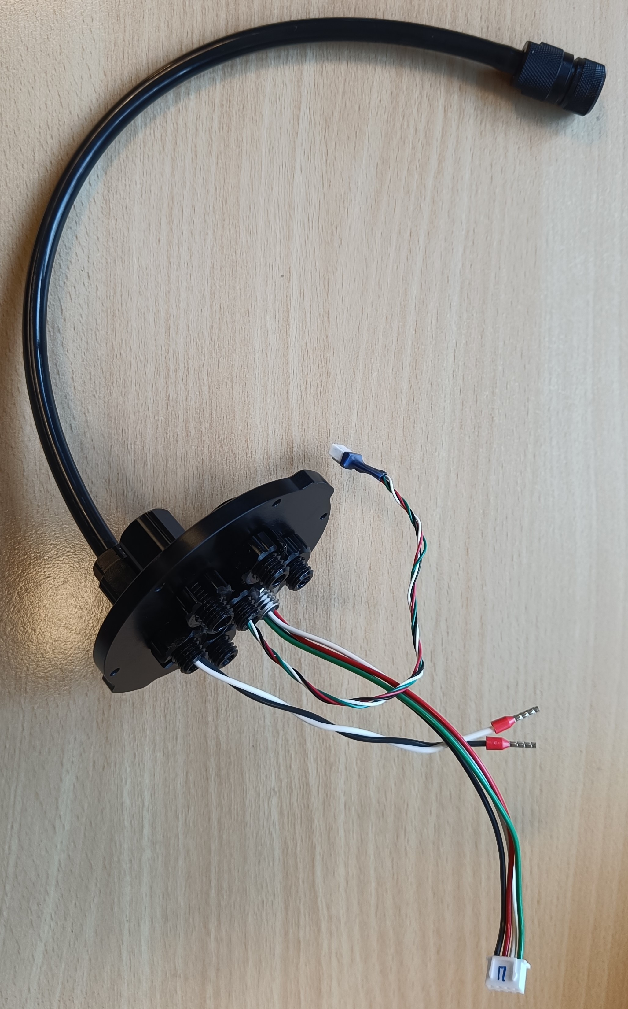
[picture p46: KosmosV4System/doc/pictures/V4_Video/IMG19.jpg]
 

### Connectiques 

- Sur le connecteur 4 pin Power Bulkhead COB-1140, raccourcir les cables pour qu'ils mesurent 10 cm.
- Dénuder les fils sur 5 mm puis y sertir des cosses JST. Vérifier qu'elles tiennent fermement.

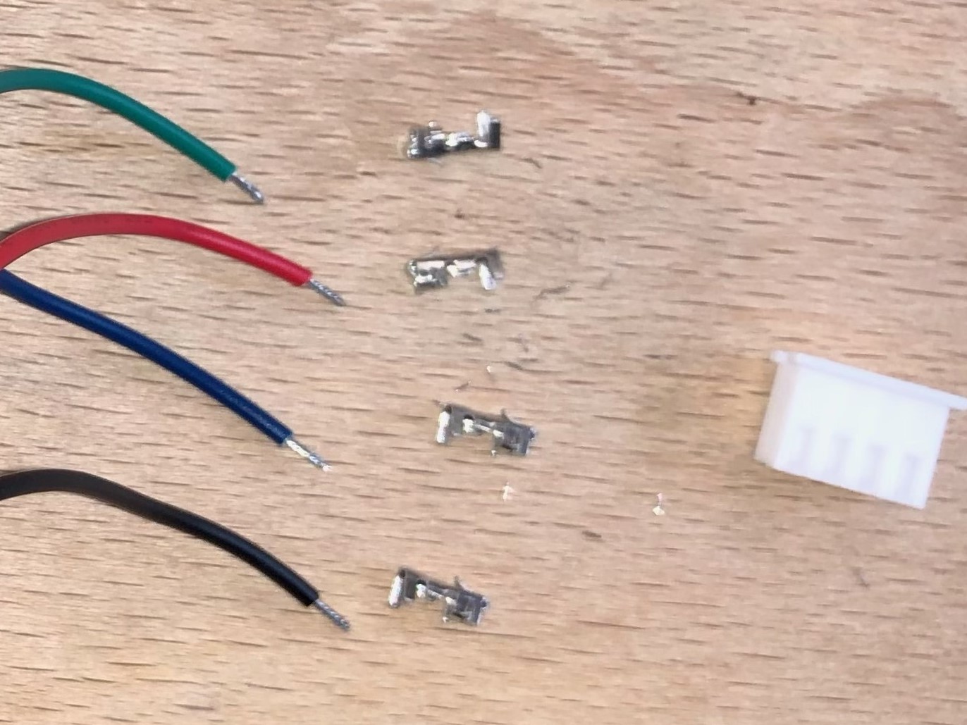
[picture p47: KosmosV4System/doc/pictures/V4_Video/1.jpeg]
 
 
- De la même façon, couper les cables du capteur Température Pression pour qu'ils mesurent 10 cm.
- Dénuder les fils sur 3 mm puis y sertir les cosses.
- Re-écraser les mords à la pince plate pour que les cosses tiennent fermement. (Les fils du capteur TP sont un peu fins pour les cosses.) 
- Insérer les cosses dans les connecteurs JST en suivant le plan de cablage.

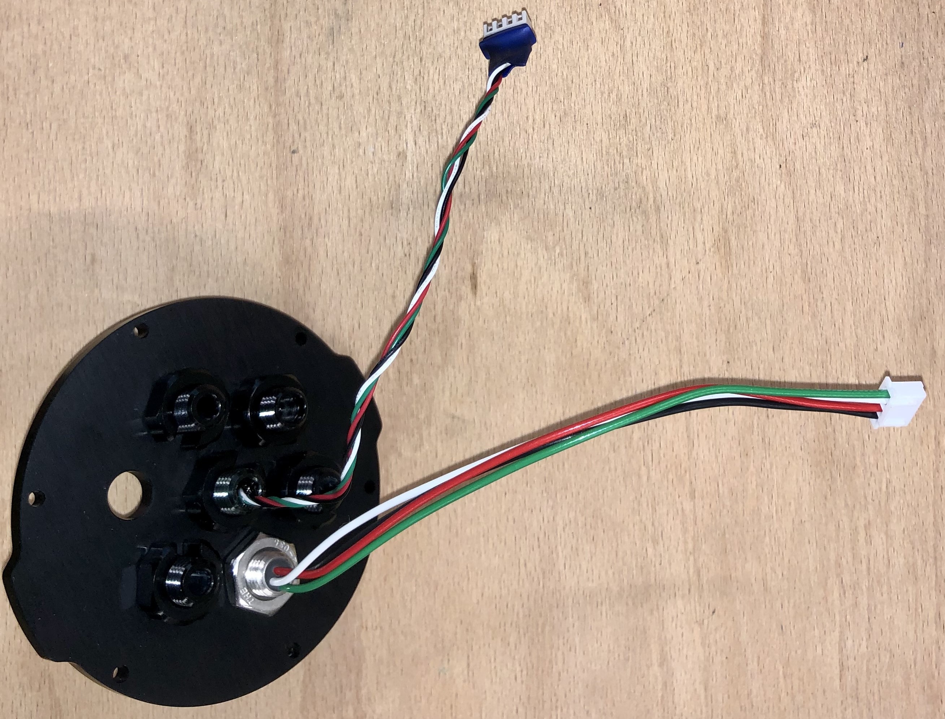
[picture p48: KosmosV4System/doc/pictures/V4_Video/IMG_E1626.JPG]
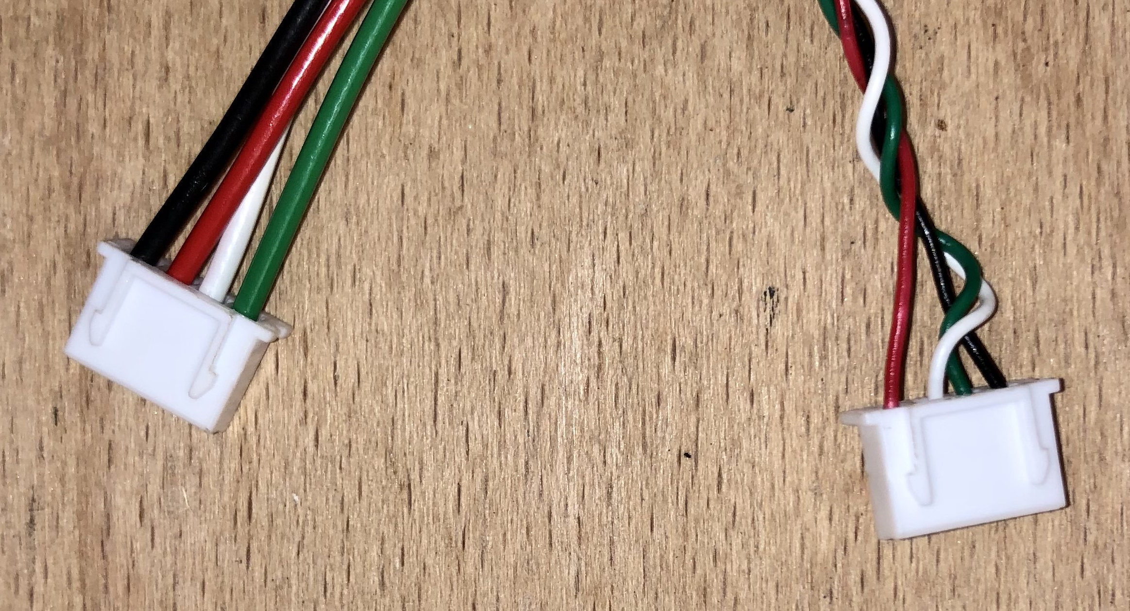
[picture p49: KosmosV4System/doc/pictures/V4_Video/IMG_E1624.JPG]
 

- Sur le connecteur 8 pin Power Bulkhead COB-1180, raccourcir les cables pour qu'ils mesurent 7cm et sertir un connecteur ethernet en respectant le code couleur suivant.

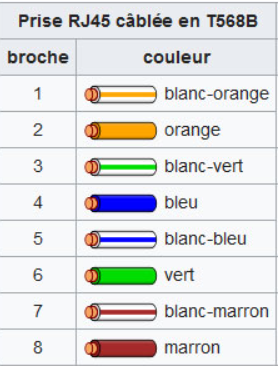
[picture p50: KosmosV4System/doc/pictures/V4_Video/Ethernet.PNG]
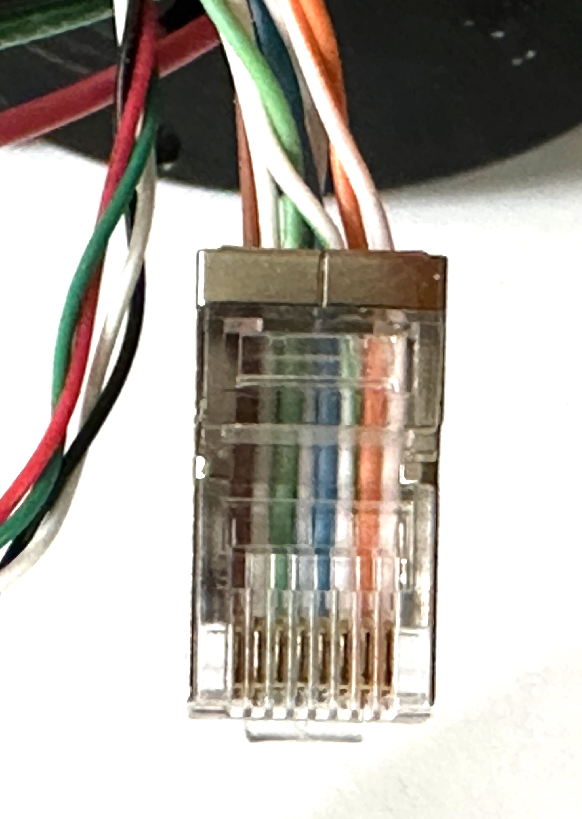
[picture p51: KosmosV4System/doc/pictures/V4_Video/IMG_1356.JPG]
  

## Réalisation du cable de récupération des données

- Sur le connecteur COB-1281, ôter le joint grâce à l'outil O-ring Pick. (Ce cable ne servant qu'à terre, le joint est inutile. L'enlever permettra d'insérer plus facilement le connecteur sur le caisson)
- Sertir ensuite un connecteur ethernet en respectant l'ordre de la figure qui suit.

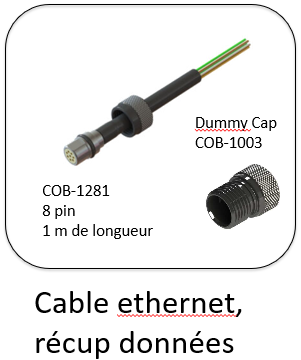
[picture p52: KosmosV4System/doc/pictures/V4_Video/RecupDonneesCable.PNG]
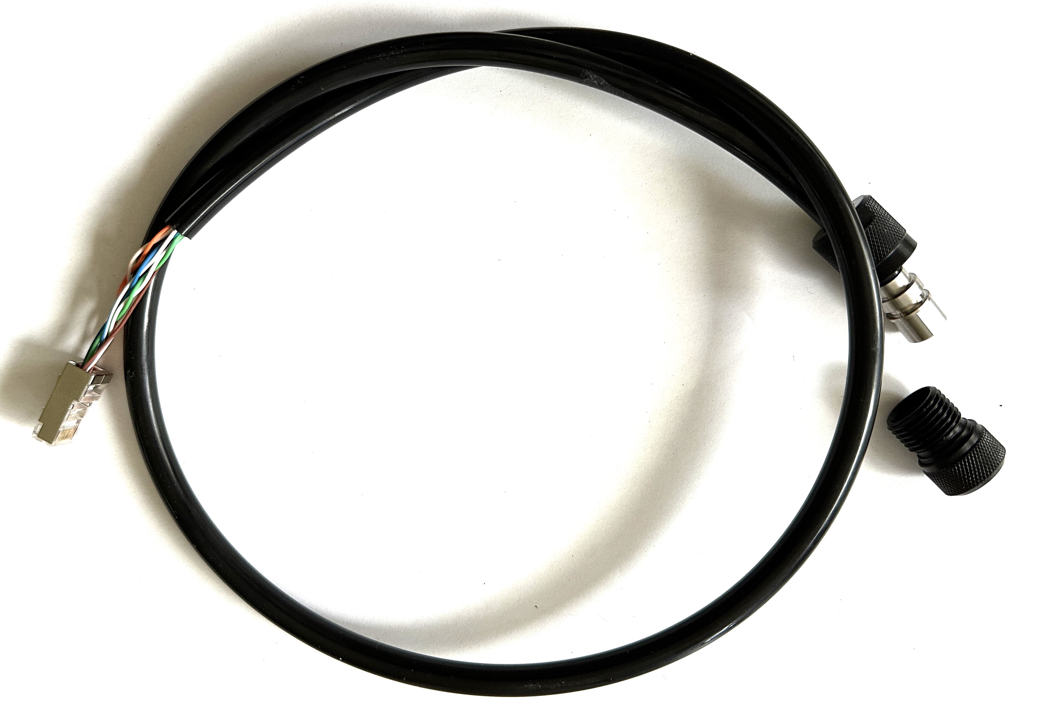
[picture p53: KosmosV4System/doc/pictures/V4_Video/IMG_1357.JPG]
  

# Assemblage final

### Fixation de l'antenne GPS

- A l'aide d'un pistolet à colle fixer l'antenne comme indiqué sur la photo suivante.
- La brancher ensuite sur le capteur GPS présent sur la carte électronique.

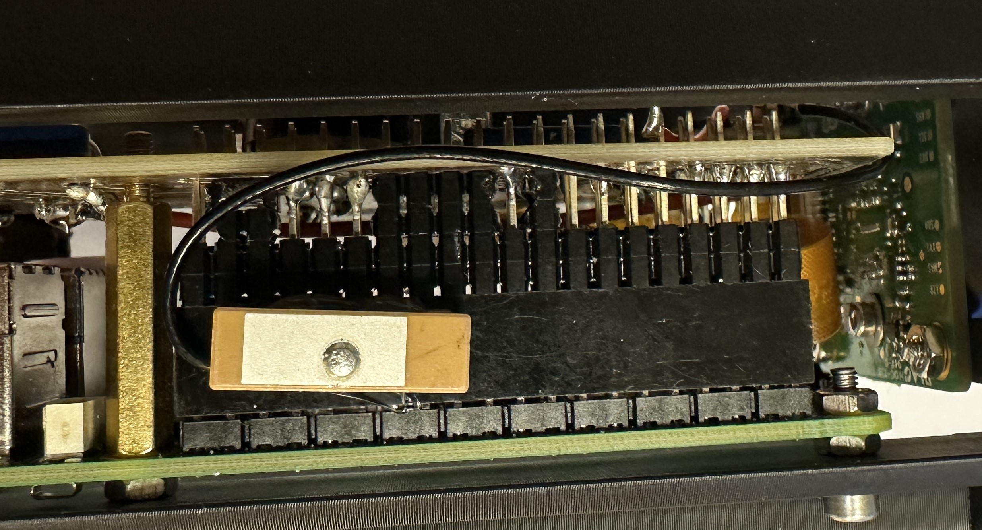
[picture p54: KosmosV4System/doc/pictures/V4_Video/IMG_1339.JPG]


### Connexion du capteur de luminosité

- Couper 6 cm de fils rouge, noir, blanc et vert et sertir des connecteurs JST de chaque côté.
  
- Les insérer dans des connecteurs 4 pin en respectant l'ordre de couleurs de la photo suivante.

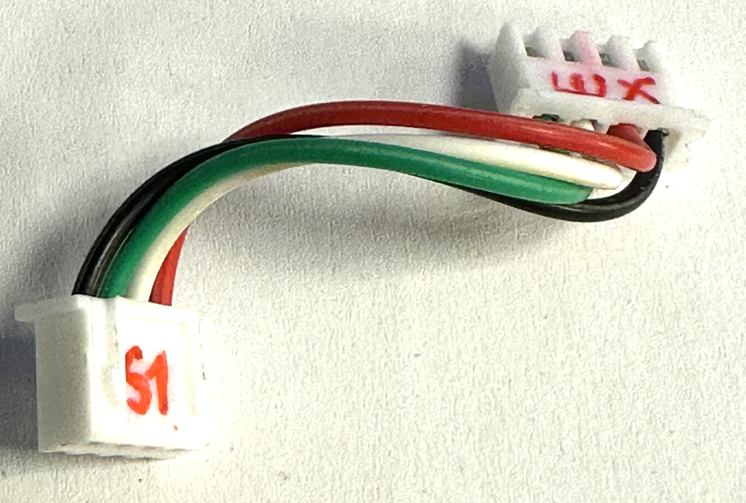
[picture p55: KosmosV4System/doc/pictures/V4_Video/IMG_1341.JPG]


- Brancher ce connecteur entre la carte électronique et le capteur de luminosité.

### Fixation de la tape arrière

- Fixer la tape arrière sur la structure mécanique à l'aide de 4 boulons (diamètre 3 mm, longueur 10 mm). On placera le détrompeur de la tape du côté des ports USB 2.0 

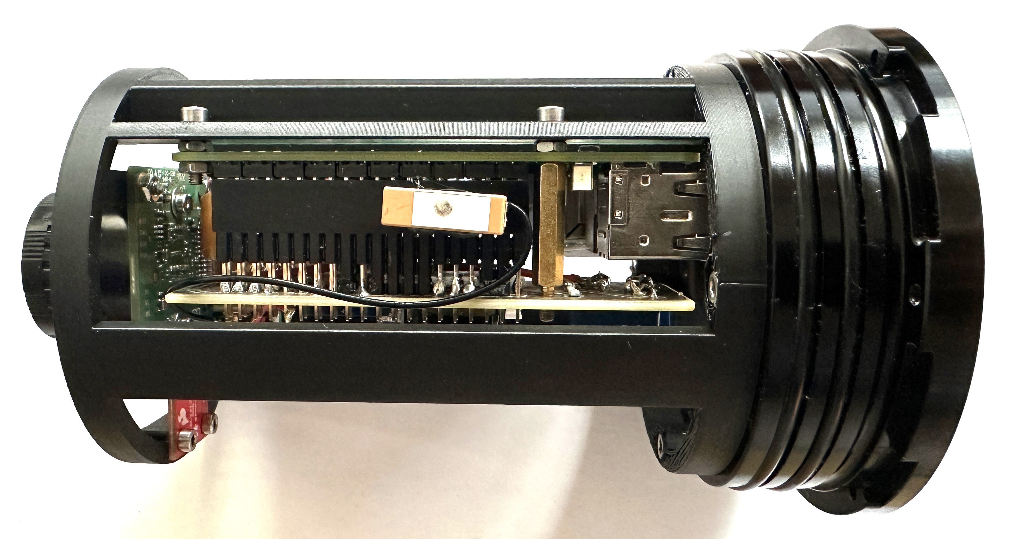
[picture p56: KosmosV4System/doc/pictures/V4_Video/IMG_1353.JPG]


### Alimentation de la carte en 5V

### Connexion du capteur TP, de la commande moteur et du port ethernet

### Fixation du bouchon sur la tape arrière
