ofauvarque/DocV4/CommonElements/doc/02_flanges.md

# **Outils**

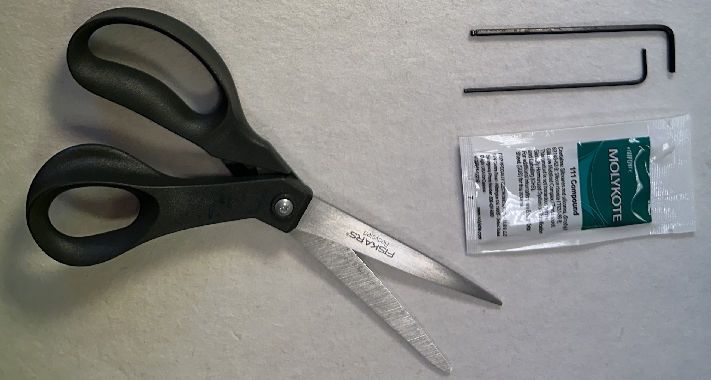
[picture p67: CommonElements/doc/pictures/00_Outils/Outils.JPG]


- **Paire de ciseaux**
- **Clés Allen** 1.25 et 2.5 mm
- **Graisse Molykotte** fournie avec les flanges BlueRobotics

# **Réalisation de la flange**

On détaille l'assemblage d'une flange 

## **Elements nécessaires**

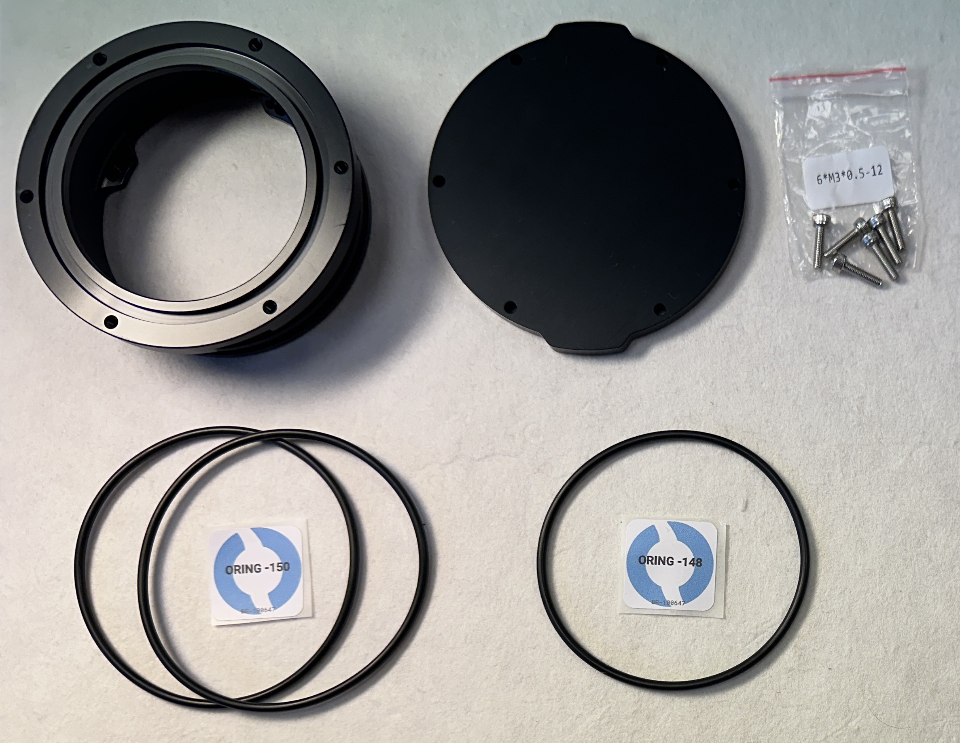
[picture p68: CommonElements/doc/pictures/02_Flanges/Flange.JPG]


- **Flange**
- **2 Joints toriques** ORING 150
- **1 Joint torique** ORING 148
- **Tape**
- **6 vis** fournie avec la tape chez BlueRobotics
  
## **Assemblage de la flange**

- Se laver les mains et travailler sur une surface lisse et bien nettoyée. 
- Ouvrir le paquet de graisse Mokykotte avec les ciseaux et déposer une goutte de graisse sur le joint ORING 148.
- Etaler cette goutte tout le long du joint.

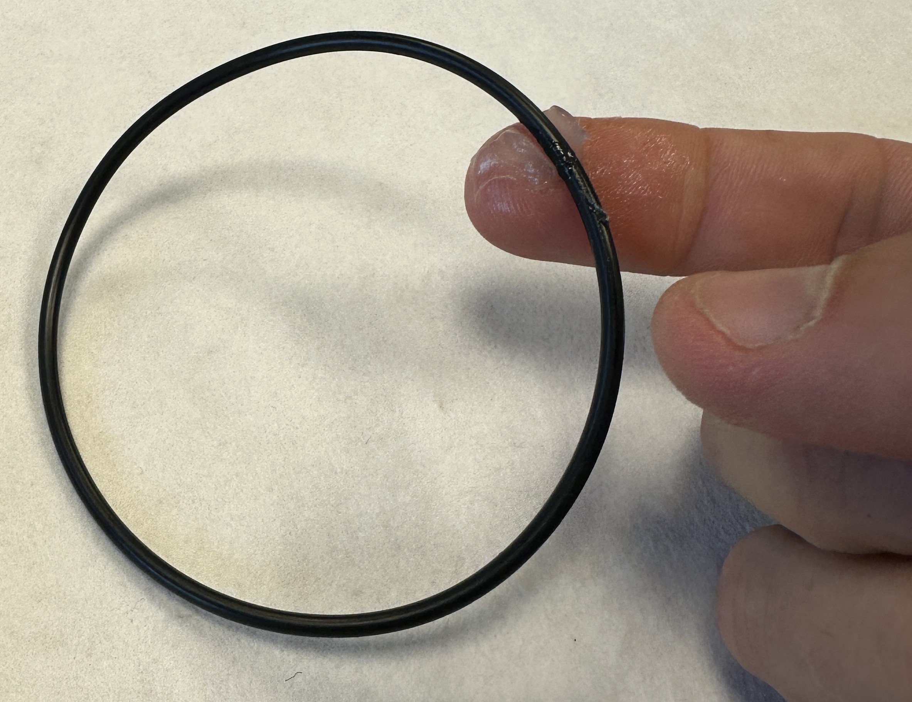
[picture p69: CommonElements/doc/pictures/02_Flanges/IMG_0798.JPG]


- Poser le joint graissé dans la gorge supérieure du flange puis y déposer le bouchon.
- Insérer les 6 vis puis les serrer progressivement et en étoile avec la clé Allen 2.5 mm.

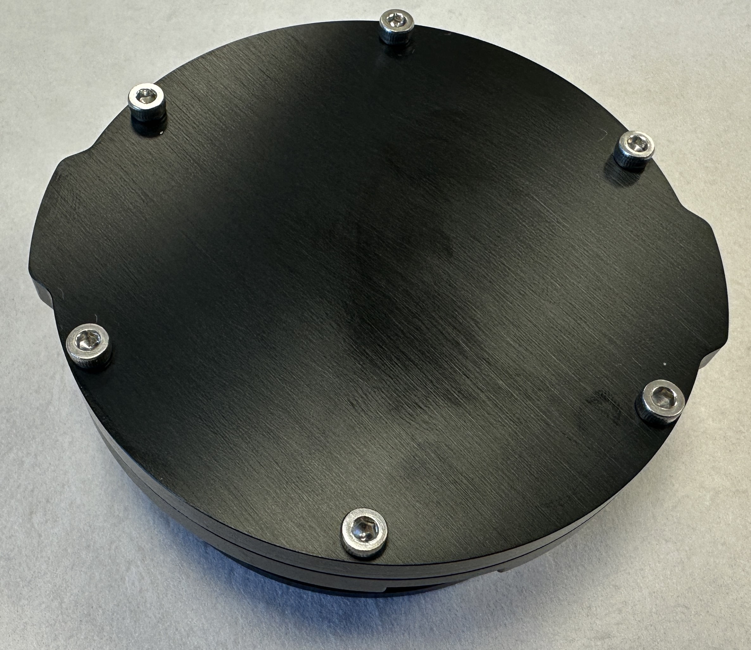
[picture p70: CommonElements/doc/pictures/02_Flanges/IMG_0797.JPG]


- Graisser les deux joints ORING 150 et les insérer dans les deux gorges restantes de la tape.
- L'assemblage de la flange est terminée. On peut maintenant l'insérer dans le tube en s'assurant de faire rentrer le détrompeur dans l'encoche.
- Insérer enfin la bride dans la gorge.

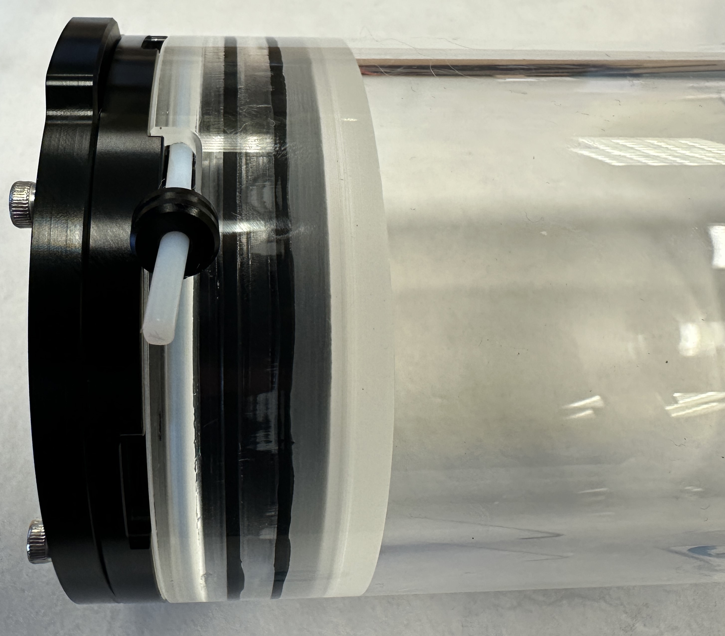
[picture p71: CommonElements/doc/pictures/02_Flanges/IMG_0802.JPG]


## **Réalisation de la bride**

- Insérer la rondelle sur la bride et y serrer fermement la vis avec la clé Allen 1.5mm. Cette rondelle doit tenir très fermement sur la bride.

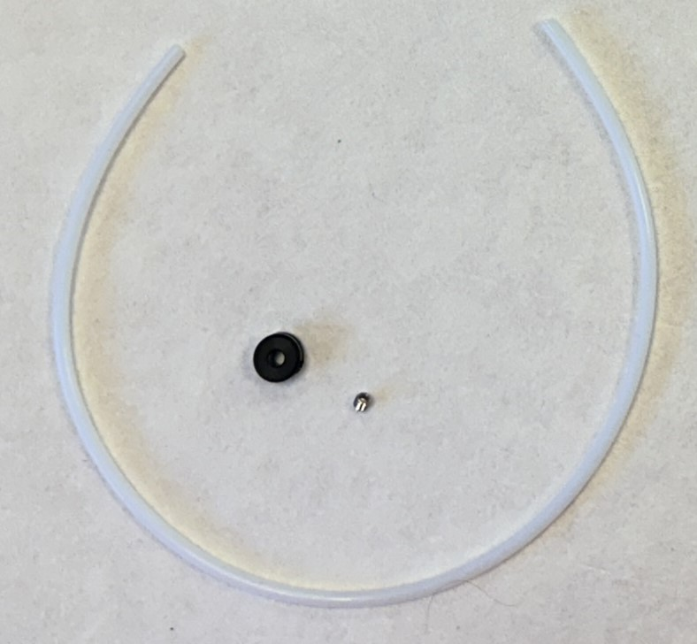
[picture p72: CommonElements/doc/pictures/02_Flanges/IMG_0796.JPG]
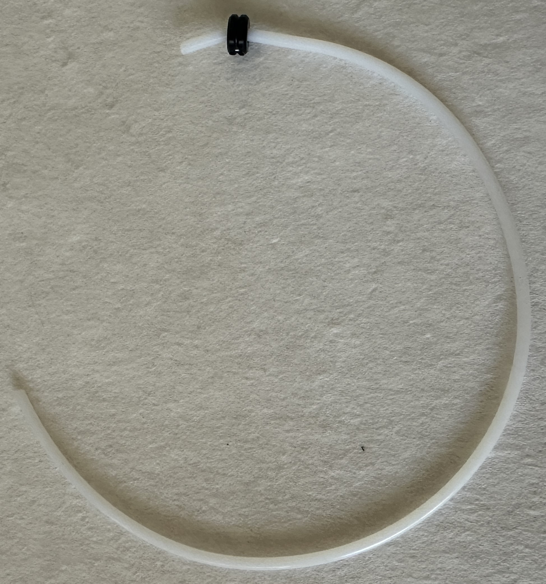
[picture p73: CommonElements/doc/pictures/02_Flanges/IMG_0809.JPG]
 

- On peut insérer la bride dans la gorge prévue de la flange pour vérifier qu'elle en fait bien le tour et qu'elle ne dépasse pas trop. Raccourcir éventuellement la bride à l'aide de viseaux.

## **Autres configurations**

On présente ici d'autres exemples de flanges. Avec un hublot plan :

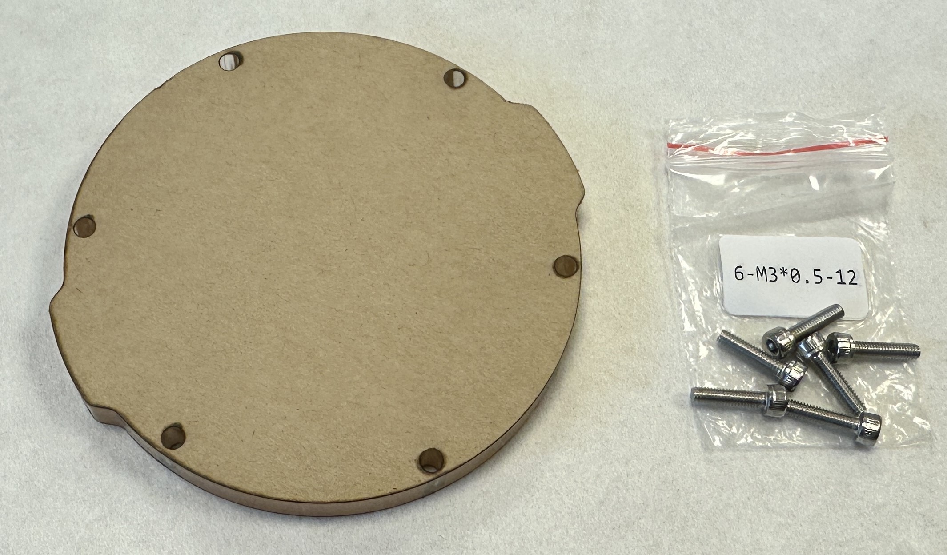
[picture p74: CommonElements/doc/pictures/02_Flanges/IMG_0803.JPG]
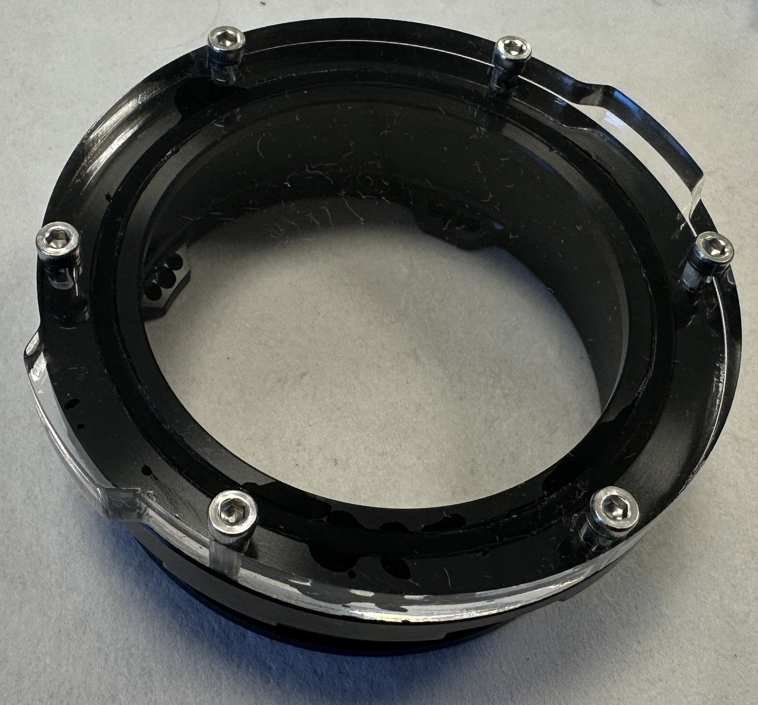
[picture p75: CommonElements/doc/pictures/02_Flanges/IMG_0805.JPG]
 

Un hublot sphérique :

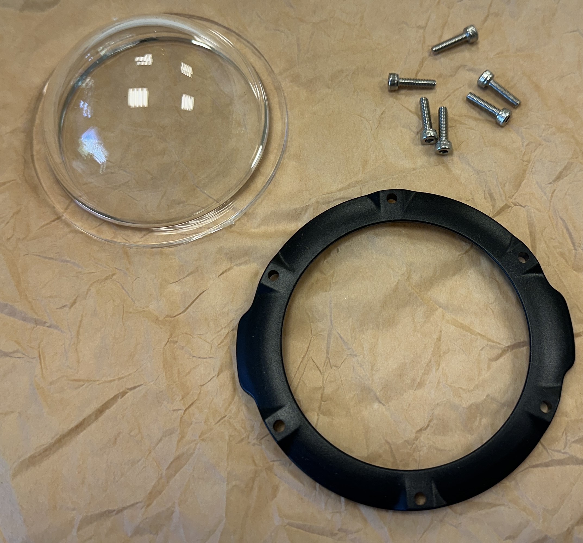
[picture p76: CommonElements/doc/pictures/02_Flanges/IMG_0806.JPG]
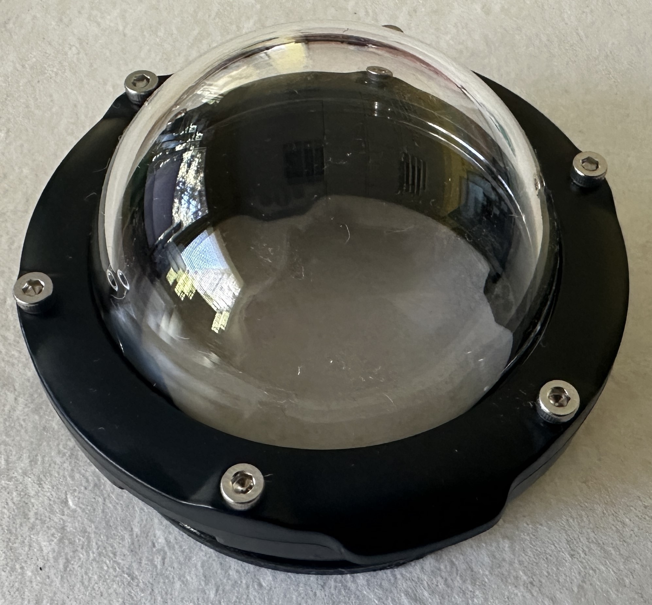
[picture p77: CommonElements/doc/pictures/02_Flanges/IMG_0808.JPG]
 

Un bouchon avec connecteurs :

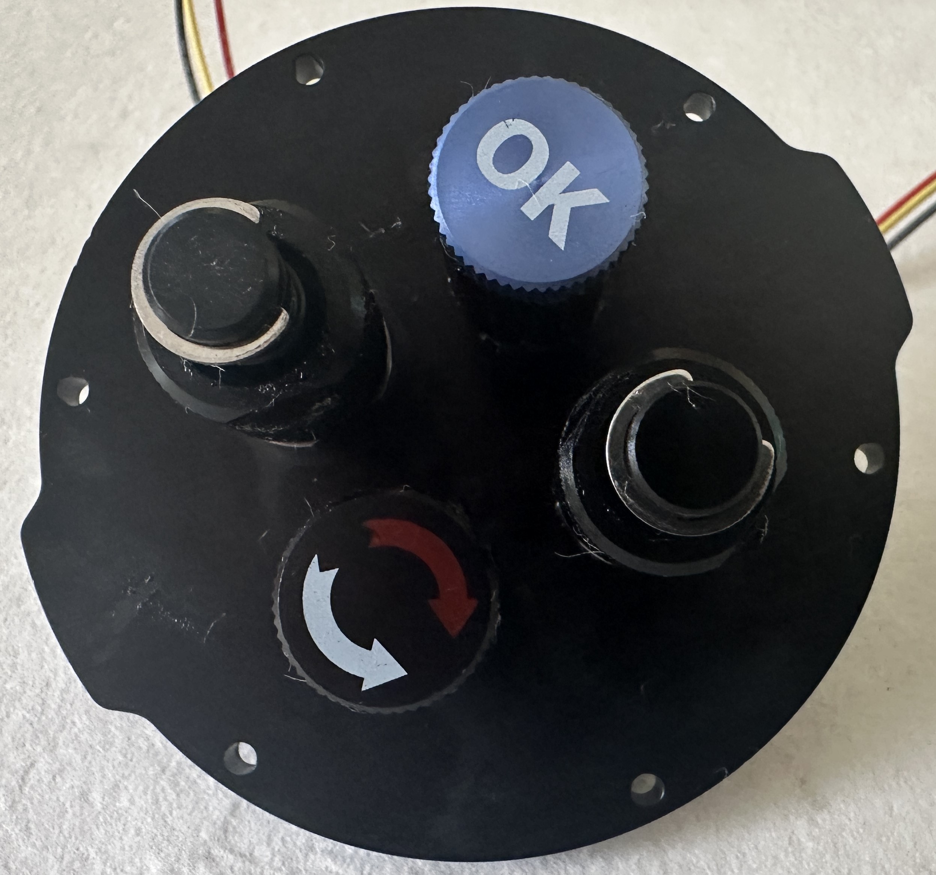
[picture p78: CommonElements/doc/pictures/02_Flanges/IMG_0818.JPG]
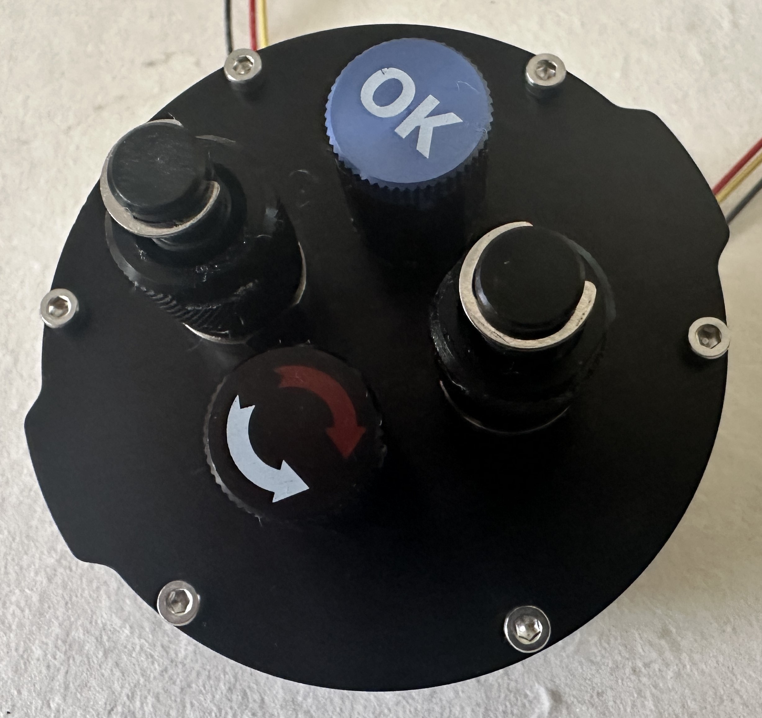
[picture p79: CommonElements/doc/pictures/02_Flanges/IMG_0823.JPG]
