ofauvarque/DocV4/KosmosV4System/doc/pictures/V4_Batterie/CablageCaissonBatterie.pptx

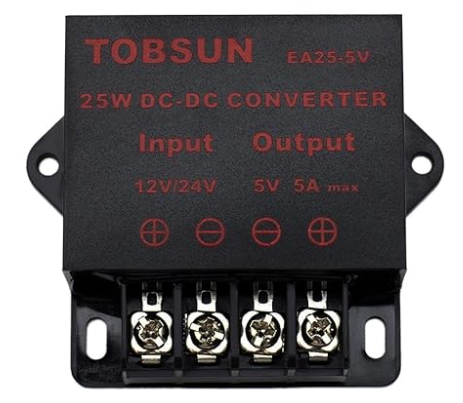
[picture p98: figure]
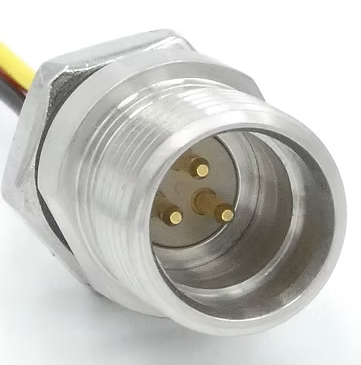
[picture p99: figure]

5V
Masse
12V

Batterie

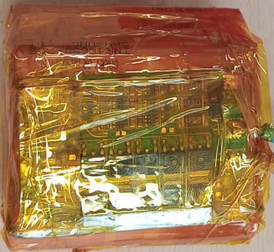
[picture p100: figure]

5V
Masse
12V

Masse

12V

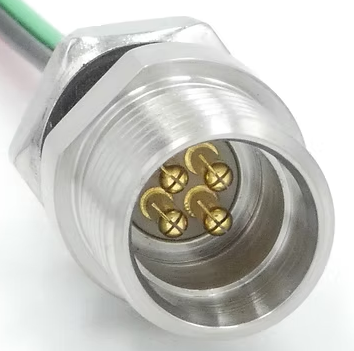
[picture p101: figure]

5V
5V
12V
12V

Wago ou domino

KOSMOS mono

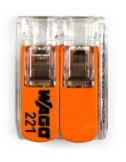
[picture p102: figure]

Shunt de fonctionnement

Shunt de charge

## Slide 2

5V
Masse
Nappe vidéo

Batterie

5V
Masse
12V

Masse

12V

5V
5V
12V
12V

Wago ou domino

Shunt de fonctionnement

KOSMOS stereo

Shunt de charge
