ofauvarque/DocV4/CommonElements/doc/pictures/04_Software/EtatsKOSMOS.pptx

Mode
STAVIRO

Switch ON

STARTING

STANDBY

WORKING

atteint

STOPPING

SHUTDOWN

Switch OFF

Switch ON

Mode
MICADO

STARTING

STANDBY

atteint

Switch OFF

WORKING

atteint

VEILLE

STOPPING

SHUTDOWN

Switch OFF

Processus qui nécessite l’intervention d’un opérateur

Unique issue à la sortie de l’état

Deux possibilités
à la sortie de l’état

Processus
automatique
