ofauvarque/DocV4/CommonElements/doc/pictures/00_Outils/Kimtech.JPG

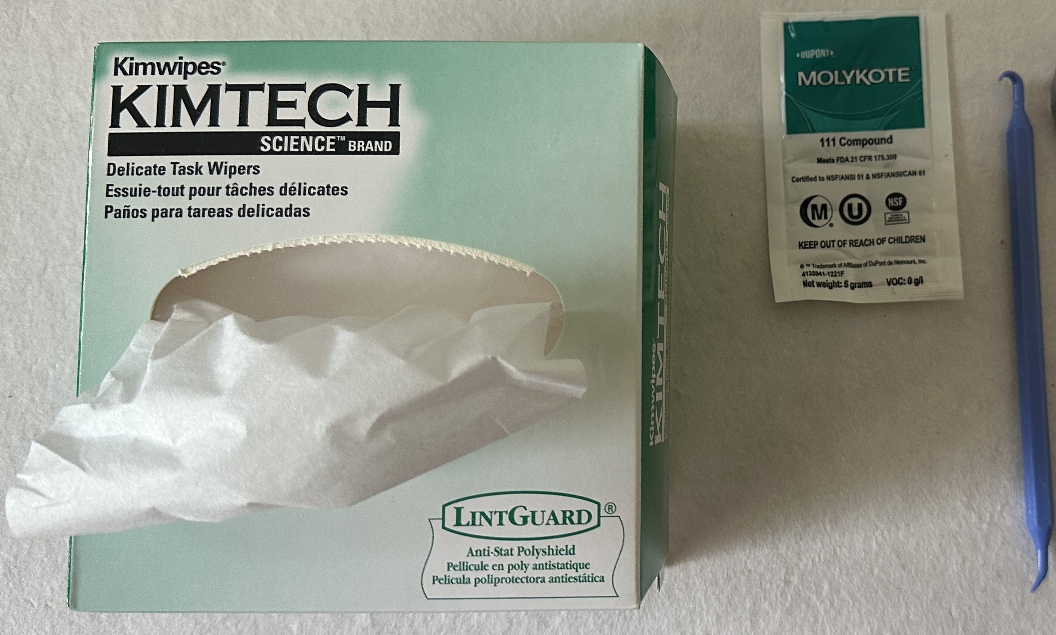
CommonElements/doc/pictures/00_Outils/Kimtech.JPG
