ofauvarque/DocV4/CommonElements/doc/pictures/01_Batterie/battery_covered.jpg

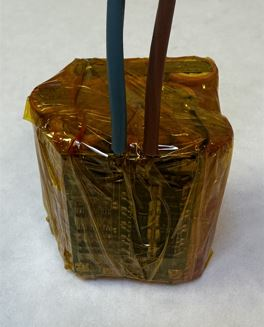
CommonElements/doc/pictures/01_Batterie/battery_covered.jpg
