ofauvarque/DocV4/CommonElements/doc/pictures/01_Batterie/bms_on_battery.jpg

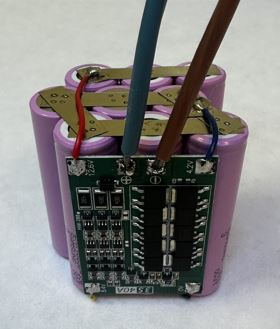
CommonElements/doc/pictures/01_Batterie/bms_on_battery.jpg
