ofauvarque/DocV4/CommonElements/doc/pictures/01_Batterie/bms_power_cables.jpg

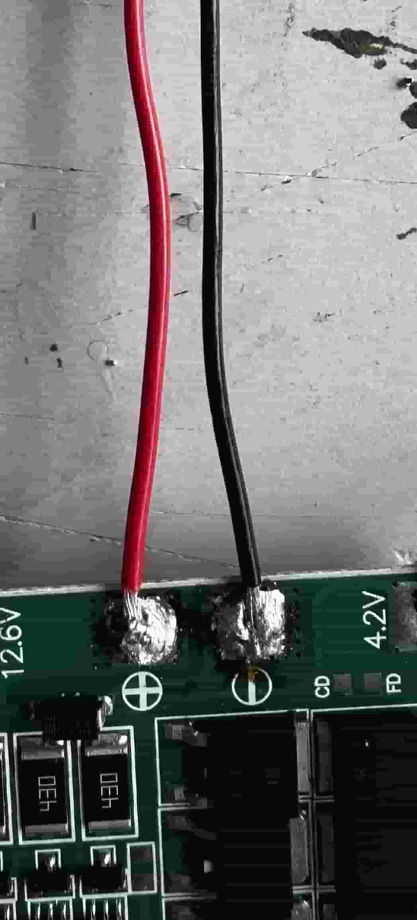
CommonElements/doc/pictures/01_Batterie/bms_power_cables.jpg
