ofauvarque/DocV4/CommonElements/doc/pictures/01_Batterie/ConnecteurCharge.PNG

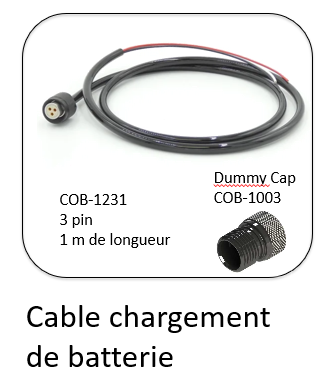
CommonElements/doc/pictures/01_Batterie/ConnecteurCharge.PNG
