ofauvarque/DocV4/CommonElements/doc/pictures/01_Batterie/four_cables_and_four_squares_of_nickel.jpg

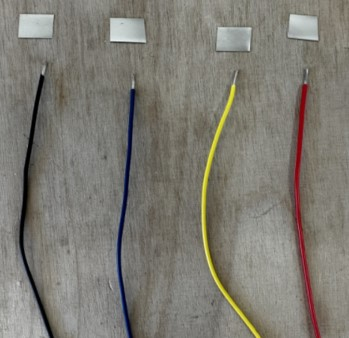
CommonElements/doc/pictures/01_Batterie/four_cables_and_four_squares_of_nickel.jpg
