ofauvarque/DocV4/CommonElements/doc/pictures/01_Batterie/IMG_0689.JPG

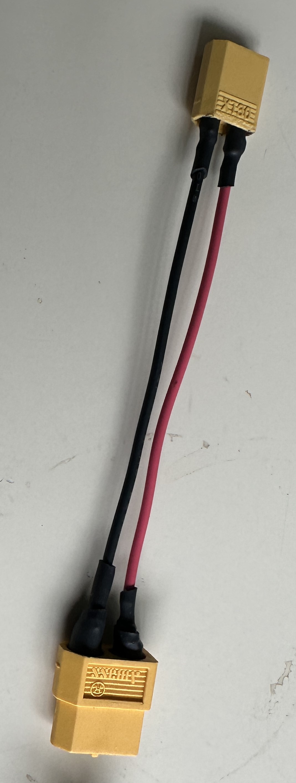
CommonElements/doc/pictures/01_Batterie/IMG_0689.JPG
