ofauvarque/DocV4/CommonElements/doc/pictures/01_Batterie/PhotoAlexandre/image002.jpg

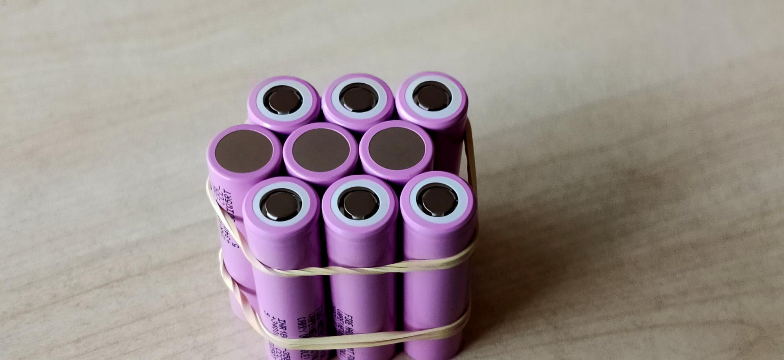
CommonElements/doc/pictures/01_Batterie/PhotoAlexandre/image002.jpg
