ofauvarque/DocV4/CommonElements/doc/pictures/01_Batterie/PhotoAlexandre/image003.png

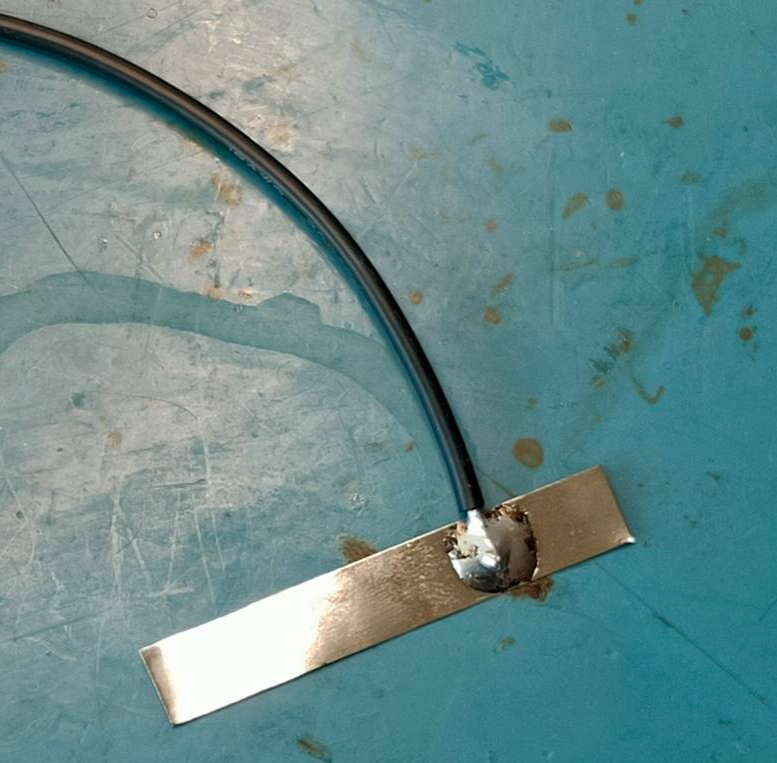
CommonElements/doc/pictures/01_Batterie/PhotoAlexandre/image003.png
