ofauvarque/DocV4/CommonElements/doc/pictures/01_Batterie/PhotoAlexandre/image005.png

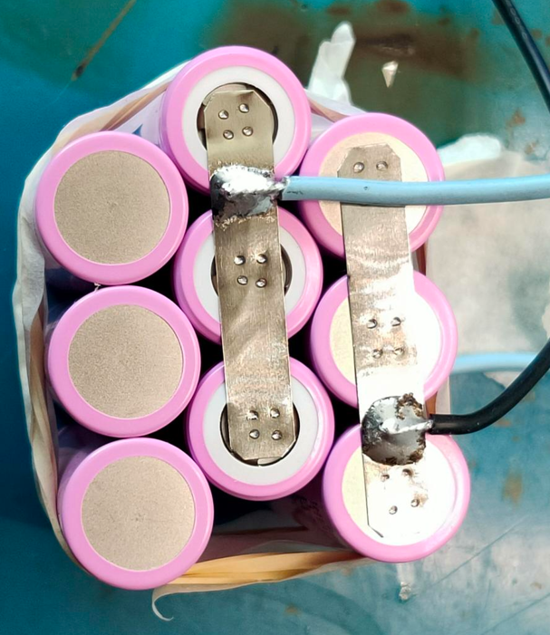
CommonElements/doc/pictures/01_Batterie/PhotoAlexandre/image005.png
