ofauvarque/DocV4/CommonElements/doc/pictures/01_Batterie/PhotoAlexandre/image006.png

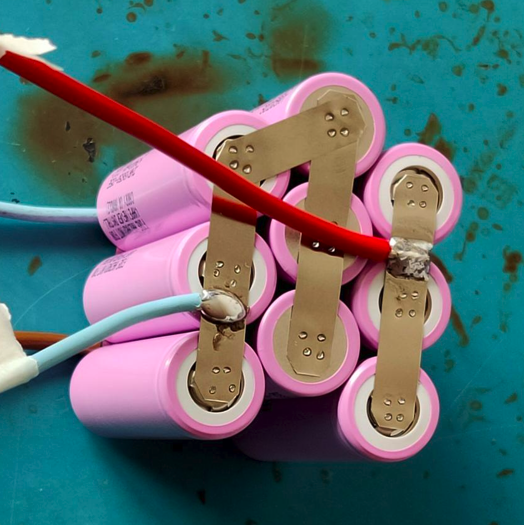
CommonElements/doc/pictures/01_Batterie/PhotoAlexandre/image006.png
