ofauvarque/DocV4/CommonElements/doc/pictures/01_Batterie/PhotoAlexandre/image009.png

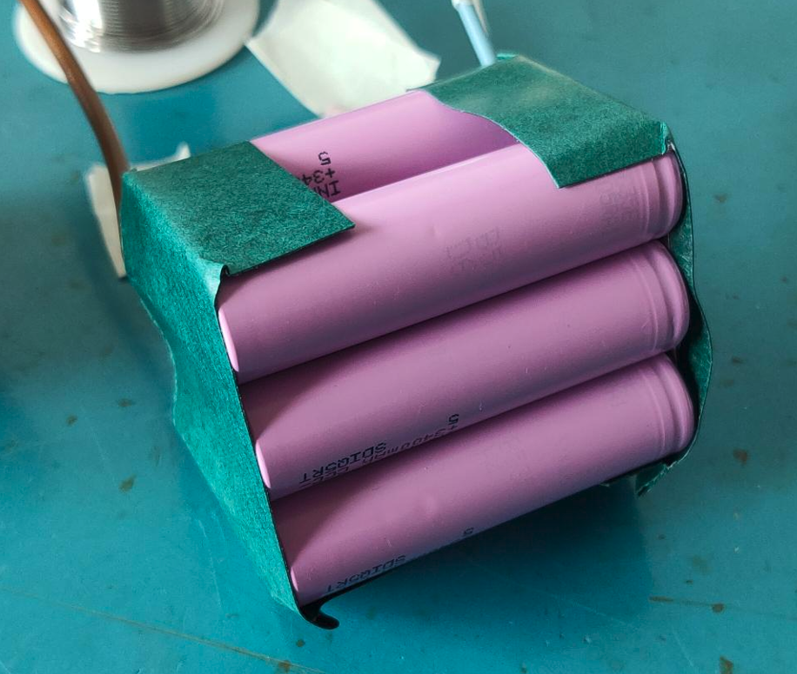
CommonElements/doc/pictures/01_Batterie/PhotoAlexandre/image009.png
