ofauvarque/DocV4/CommonElements/doc/pictures/01_Batterie/PhotoAlexandre/image011.png

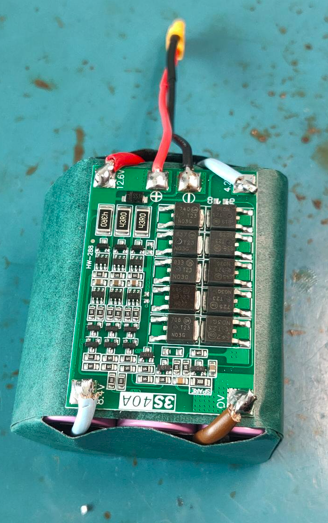
CommonElements/doc/pictures/01_Batterie/PhotoAlexandre/image011.png
