ofauvarque/DocV4/CommonElements/doc/pictures/01_Batterie/PhotoAlexandre/image013.png

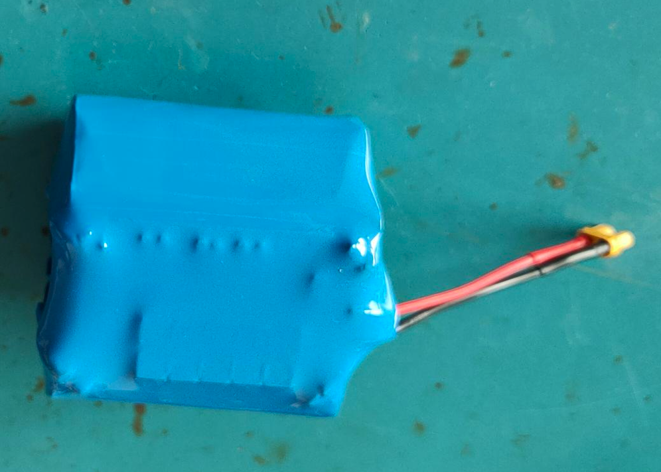
CommonElements/doc/pictures/01_Batterie/PhotoAlexandre/image013.png
