ofauvarque/DocV4/CommonElements/doc/pictures/01_Batterie/power_cable_and_bms.jpg

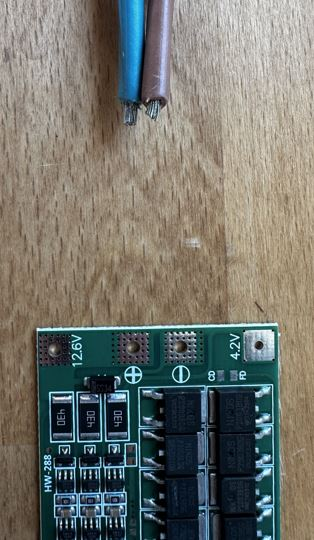
CommonElements/doc/pictures/01_Batterie/power_cable_and_bms.jpg
