ofauvarque/DocV4/CommonElements/doc/pictures/01_Batterie/schema_bms.png

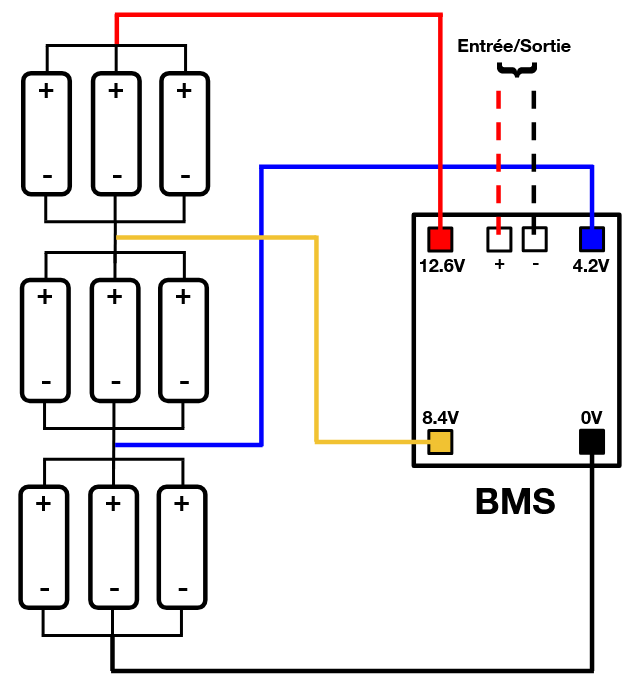
CommonElements/doc/pictures/01_Batterie/schema_bms.png
