ofauvarque/DocV4/CommonElements/doc/pictures/02_Flanges/IMG_0799.JPG

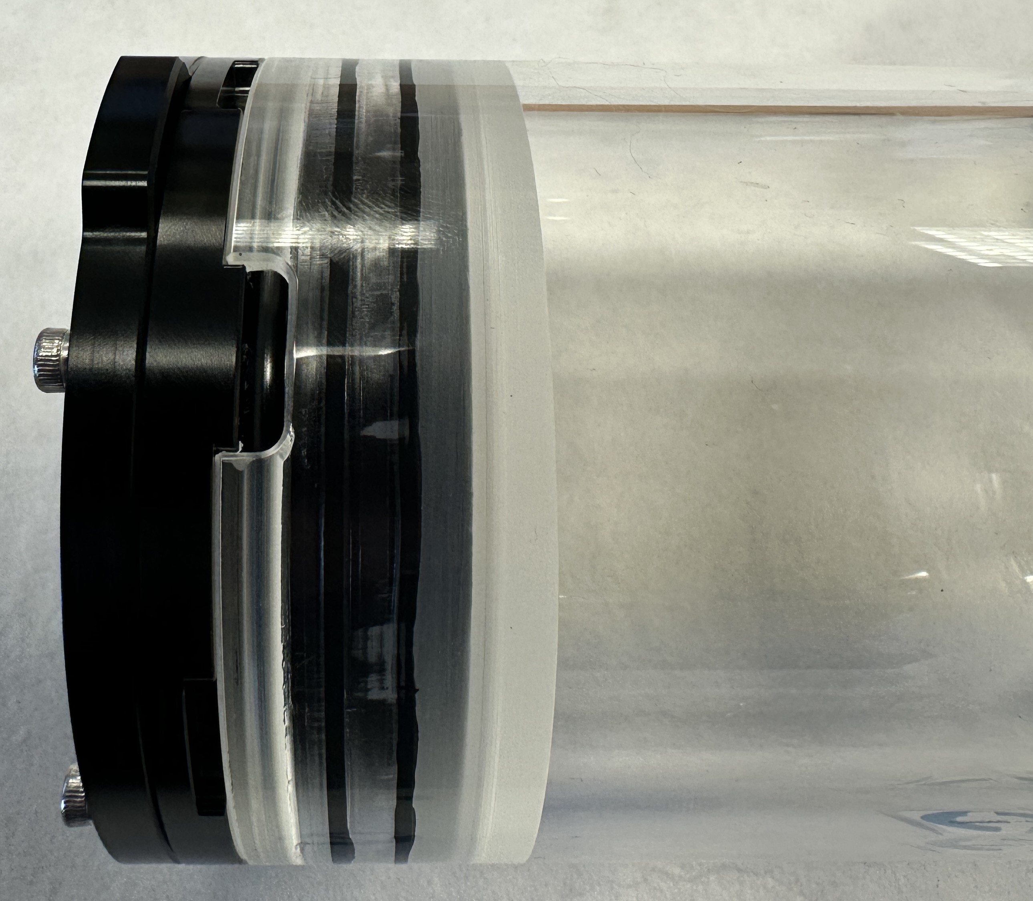
CommonElements/doc/pictures/02_Flanges/IMG_0799.JPG
