ofauvarque/DocV4/CommonElements/doc/pictures/02_Flanges/IMG_0807.JPG

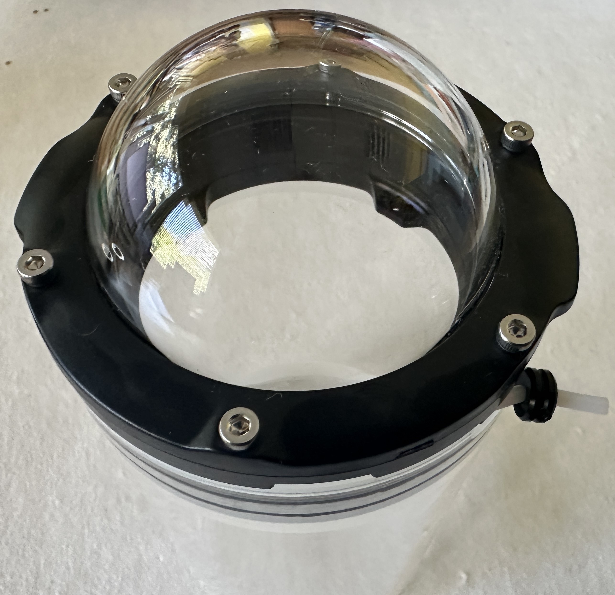
CommonElements/doc/pictures/02_Flanges/IMG_0807.JPG
