ofauvarque/DocV4/CommonElements/doc/pictures/03_EtancheiteDivers/Bouchon.jpg

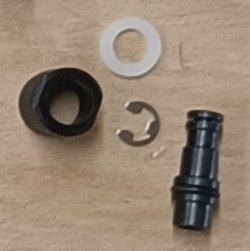
CommonElements/doc/pictures/03_EtancheiteDivers/Bouchon.jpg
