ofauvarque/DocV4/CommonElements/doc/pictures/03_EtancheiteDivers/IMG_0813.JPG

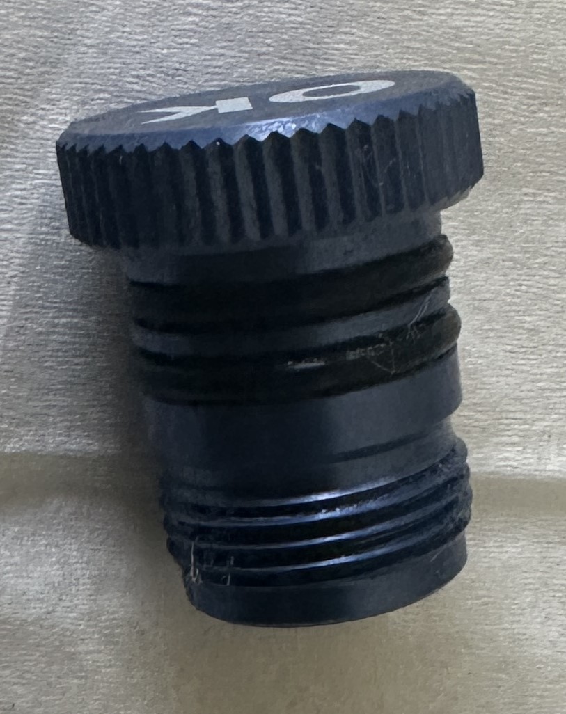
CommonElements/doc/pictures/03_EtancheiteDivers/IMG_0813.JPG
