ofauvarque/DocV4/CommonElements/doc/pictures/03_EtancheiteDivers/IMG_0815.JPG

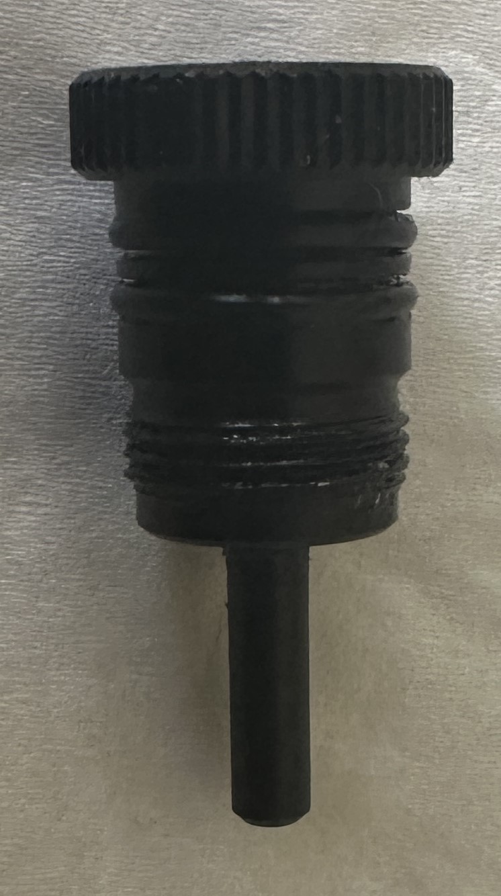
CommonElements/doc/pictures/03_EtancheiteDivers/IMG_0815.JPG
