ofauvarque/DocV4/CommonElements/doc/pictures/03_EtancheiteDivers/Qwitch.JPG

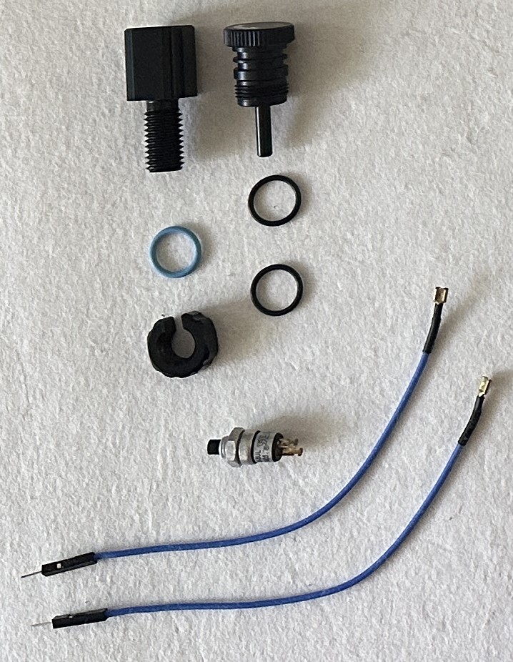
CommonElements/doc/pictures/03_EtancheiteDivers/Qwitch.JPG
