ofauvarque/DocV4/CommonElements/doc/pictures/03_EtancheiteDivers/Vent.JPG

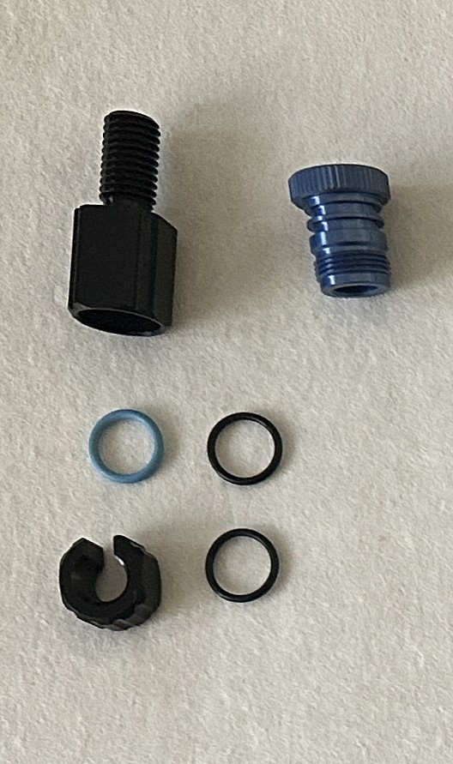
CommonElements/doc/pictures/03_EtancheiteDivers/Vent.JPG
