ofauvarque/DocV4/KosmosV4System/doc/pictures/IMG_1627.JPG

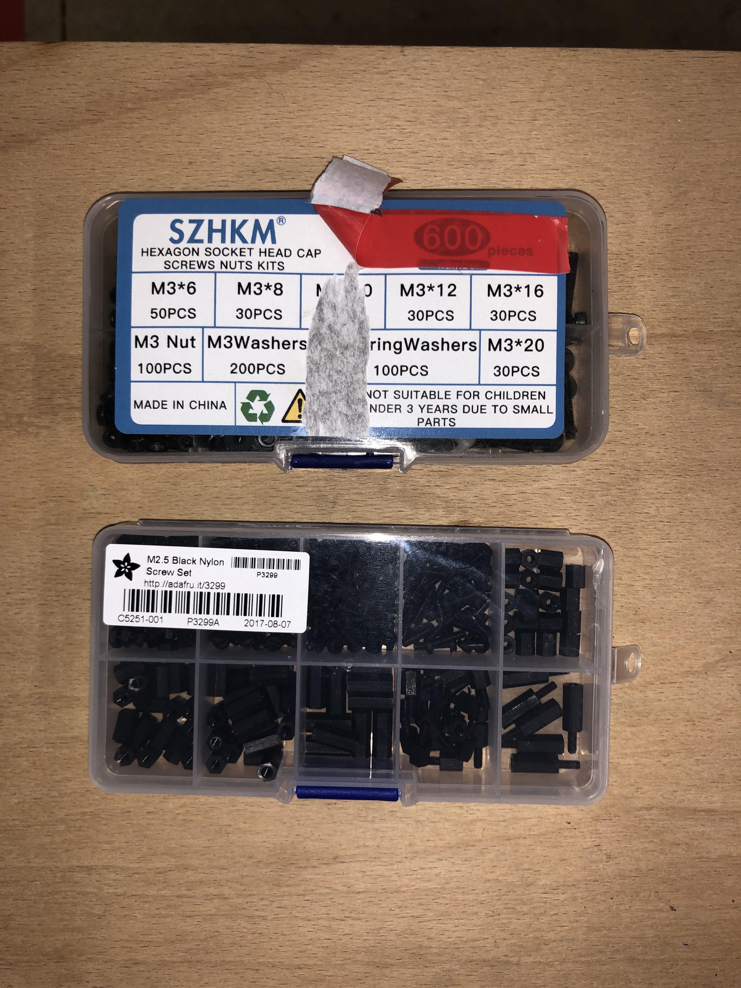
KosmosV4System/doc/pictures/IMG_1627.JPG
