ofauvarque/DocV4/KosmosV4System/doc/pictures/Outils/IMG_0821.JPG

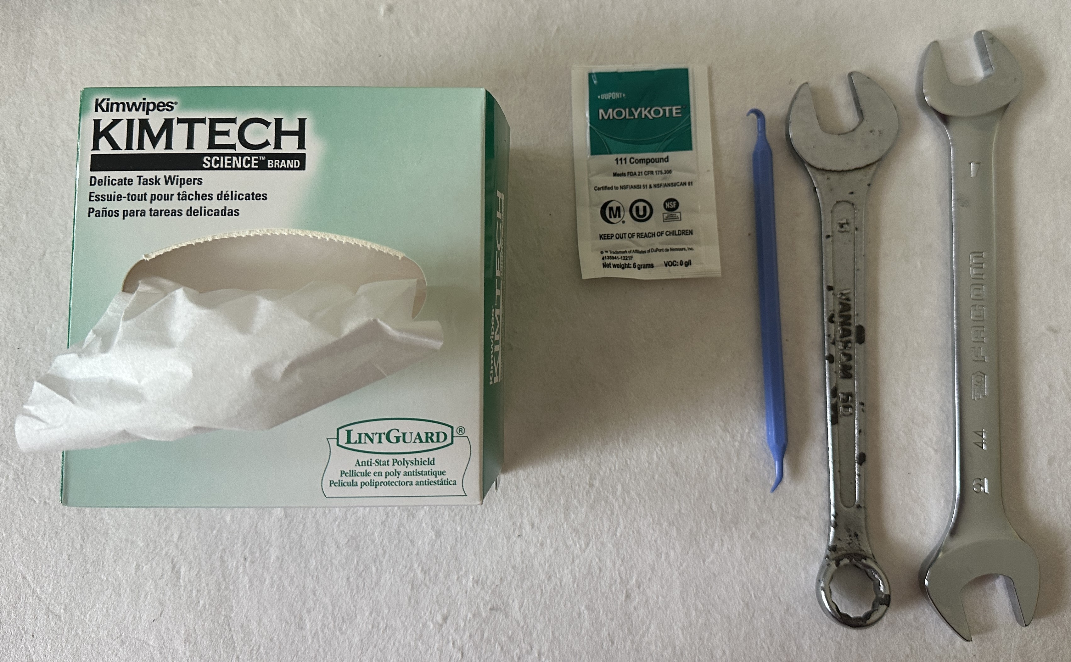
KosmosV4System/doc/pictures/Outils/IMG_0821.JPG
