ofauvarque/DocV4/KosmosV4System/doc/pictures/V3_PriseEau/20250408_181856.jpg

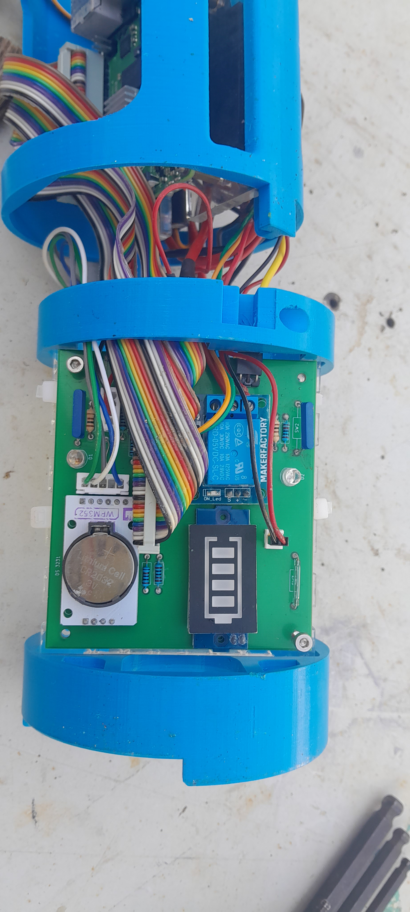
KosmosV4System/doc/pictures/V3_PriseEau/20250408_181856.jpg
