ofauvarque/DocV4/KosmosV4System/doc/pictures/V3_PriseEau/20250408_192024.jpg

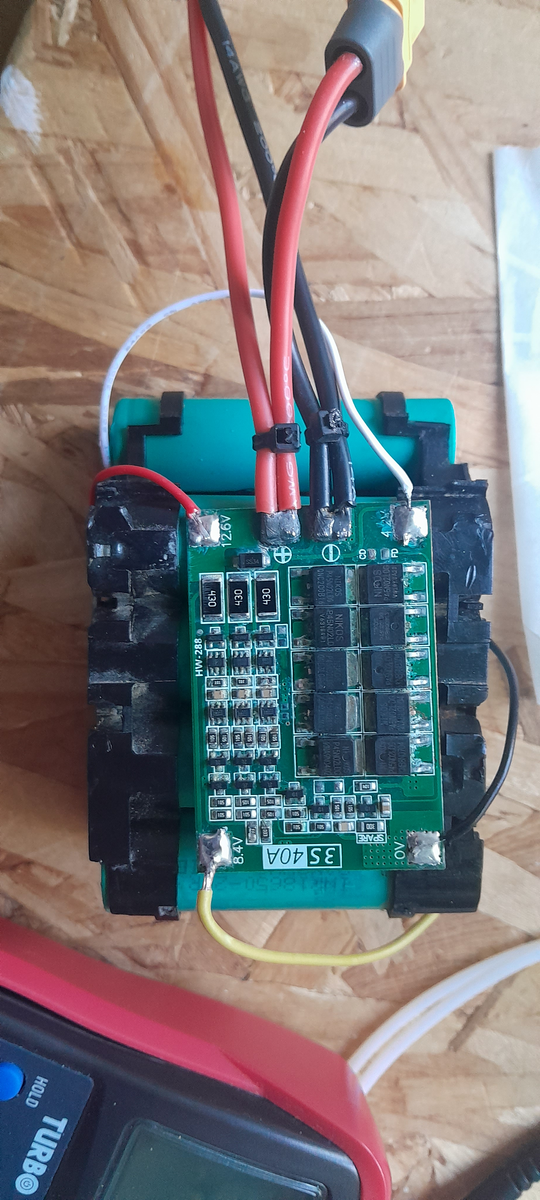
KosmosV4System/doc/pictures/V3_PriseEau/20250408_192024.jpg
