ofauvarque/DocV4/KosmosV4System/doc/pictures/V3_PriseEau/20250408_192032.jpg

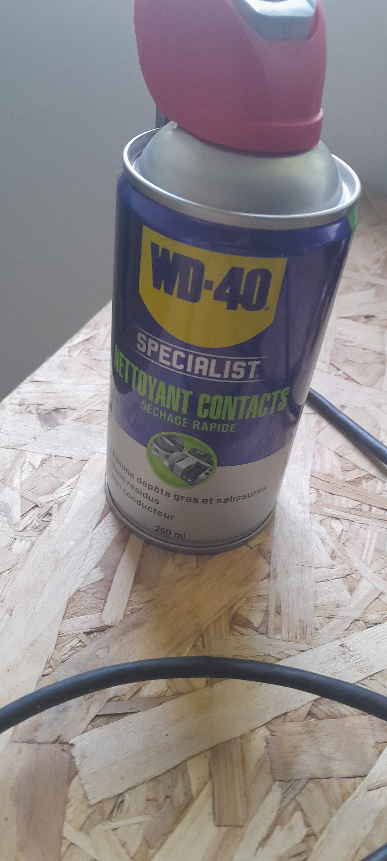
KosmosV4System/doc/pictures/V3_PriseEau/20250408_192032.jpg
