ofauvarque/DocV4/KosmosV4System/doc/pictures/V4_Batterie/3Pin.JPG

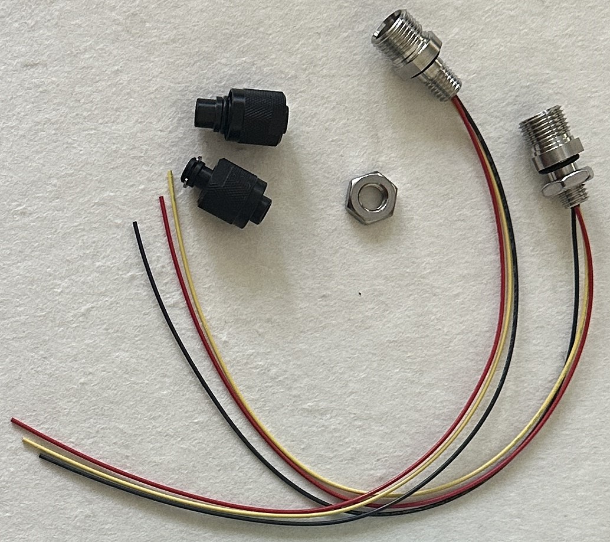
KosmosV4System/doc/pictures/V4_Batterie/3Pin.JPG
