ofauvarque/DocV4/KosmosV4System/doc/pictures/V4_Batterie/7.jpg

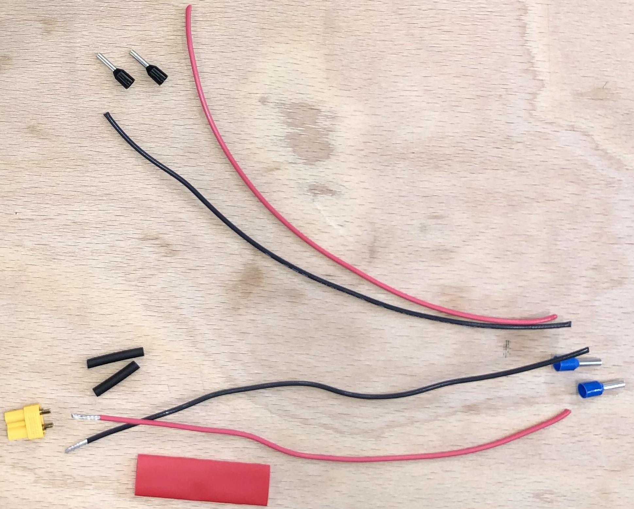
KosmosV4System/doc/pictures/V4_Batterie/7.jpg
