ofauvarque/DocV4/KosmosV4System/doc/pictures/V4_Batterie/8.jpeg

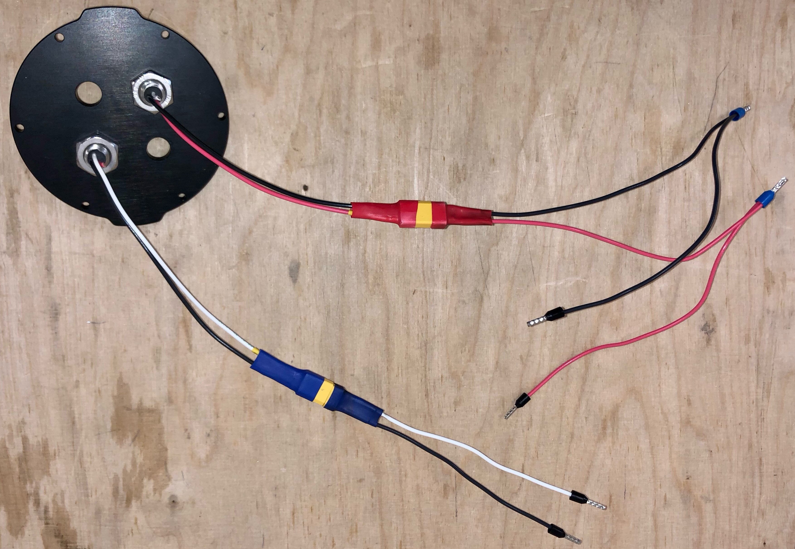
KosmosV4System/doc/pictures/V4_Batterie/8.jpeg
