ofauvarque/DocV4/KosmosV4System/doc/pictures/V4_Batterie/20.jpeg

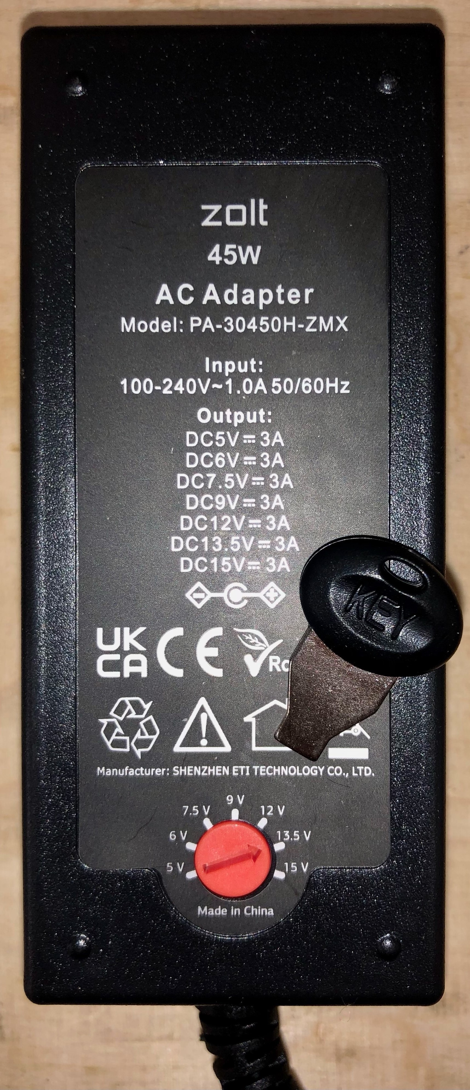
KosmosV4System/doc/pictures/V4_Batterie/20.jpeg
