ofauvarque/DocV4/KosmosV4System/doc/pictures/V4_Batterie/BMS.jpg

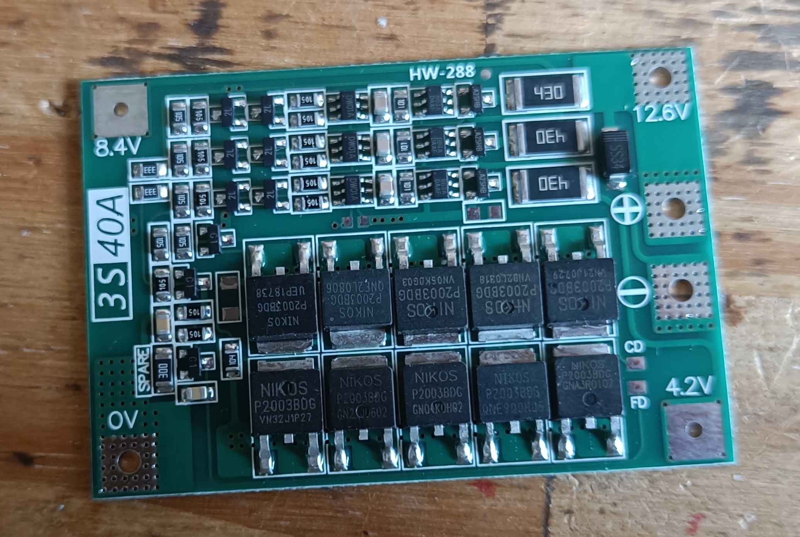
KosmosV4System/doc/pictures/V4_Batterie/BMS.jpg
