ofauvarque/DocV4/KosmosV4System/doc/pictures/V4_Batterie/CarteBatterie.jpeg

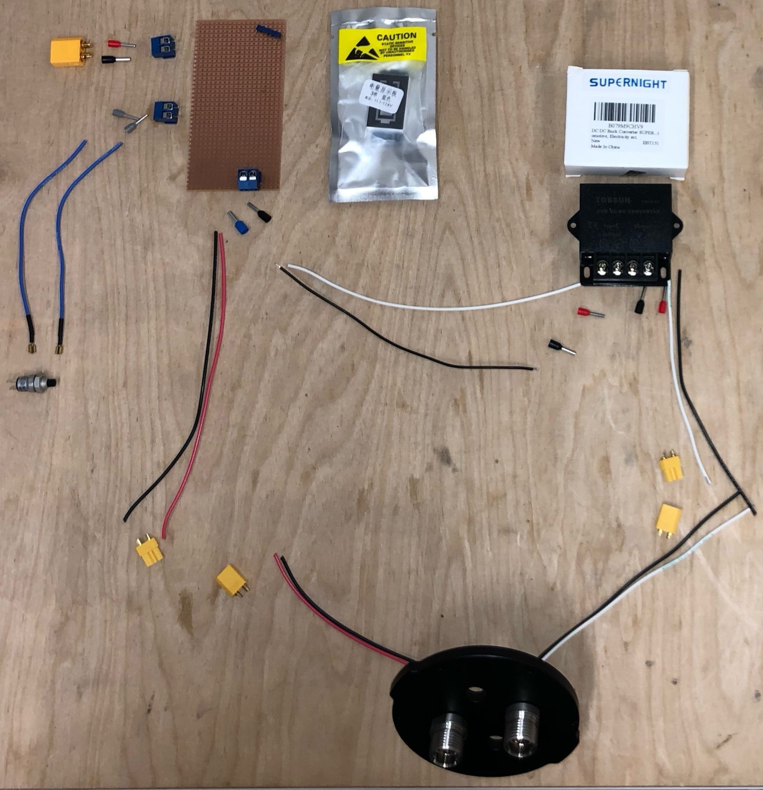
KosmosV4System/doc/pictures/V4_Batterie/CarteBatterie.jpeg
