ofauvarque/DocV4/KosmosV4System/doc/pictures/V4_Batterie/Chargeur.jpeg

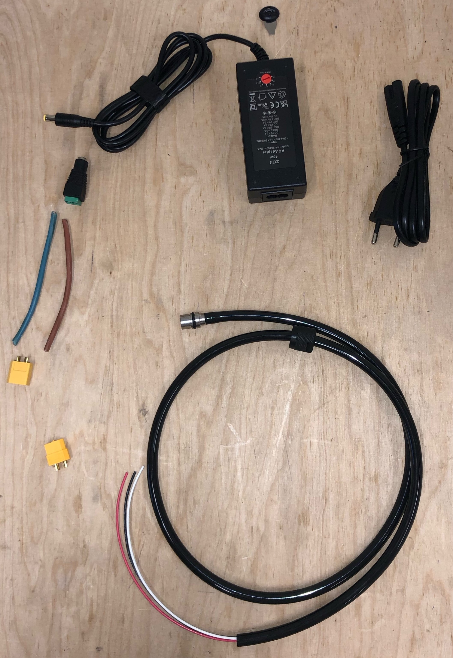
KosmosV4System/doc/pictures/V4_Batterie/Chargeur.jpeg
