ofauvarque/DocV4/KosmosV4System/doc/pictures/V4_Batterie/ElectroniqueBatterie.jpeg

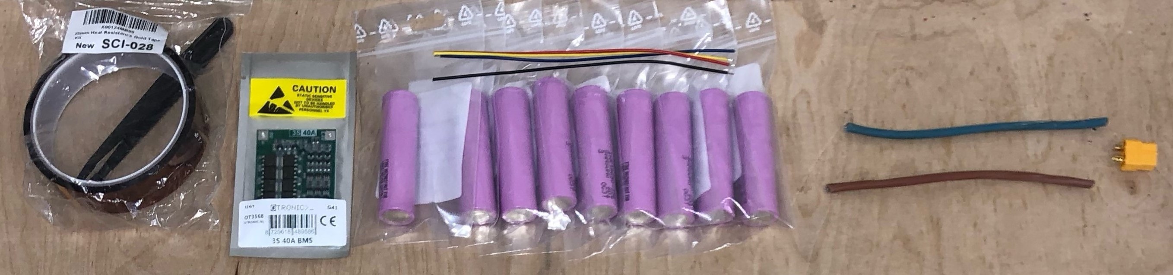
KosmosV4System/doc/pictures/V4_Batterie/ElectroniqueBatterie.jpeg
