ofauvarque/DocV4/KosmosV4System/doc/pictures/V4_Batterie/FilsBatterieCoupe.jpeg

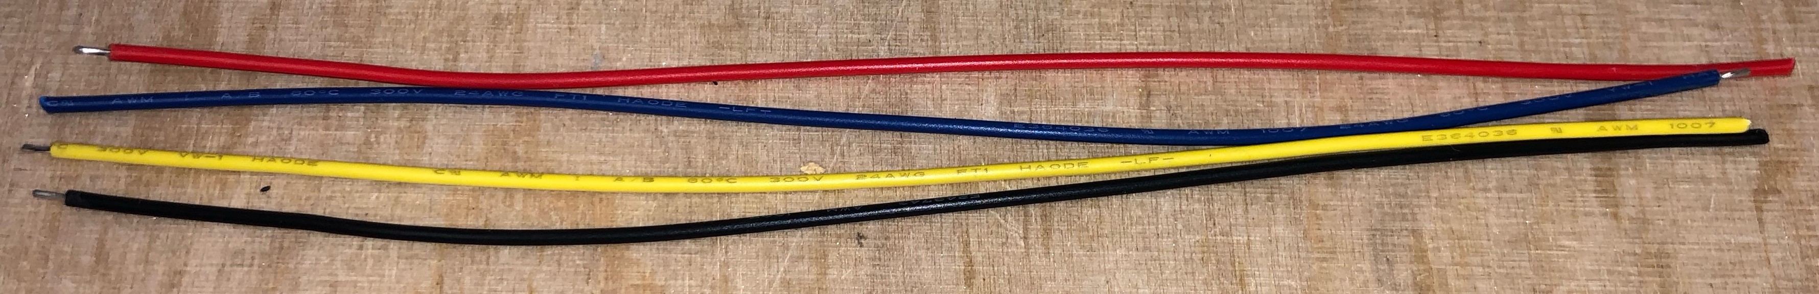
KosmosV4System/doc/pictures/V4_Batterie/FilsBatterieCoupe.jpeg
