ofauvarque/DocV4/KosmosV4System/doc/pictures/V4_Batterie/FilsBatterieOrigine.jpeg

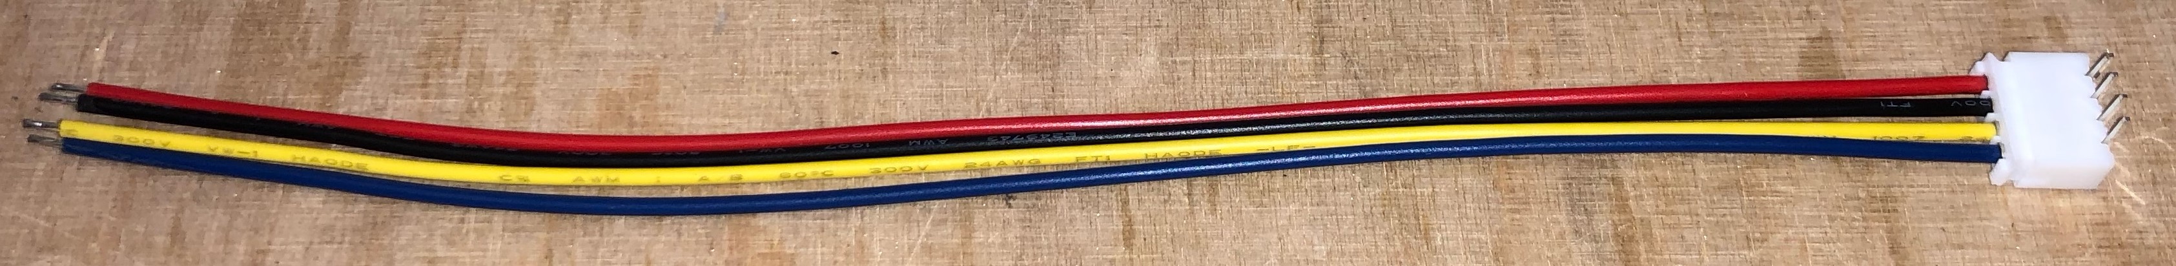
KosmosV4System/doc/pictures/V4_Batterie/FilsBatterieOrigine.jpeg
