ofauvarque/DocV4/KosmosV4System/doc/pictures/V4_Batterie/IMG_15.jpg

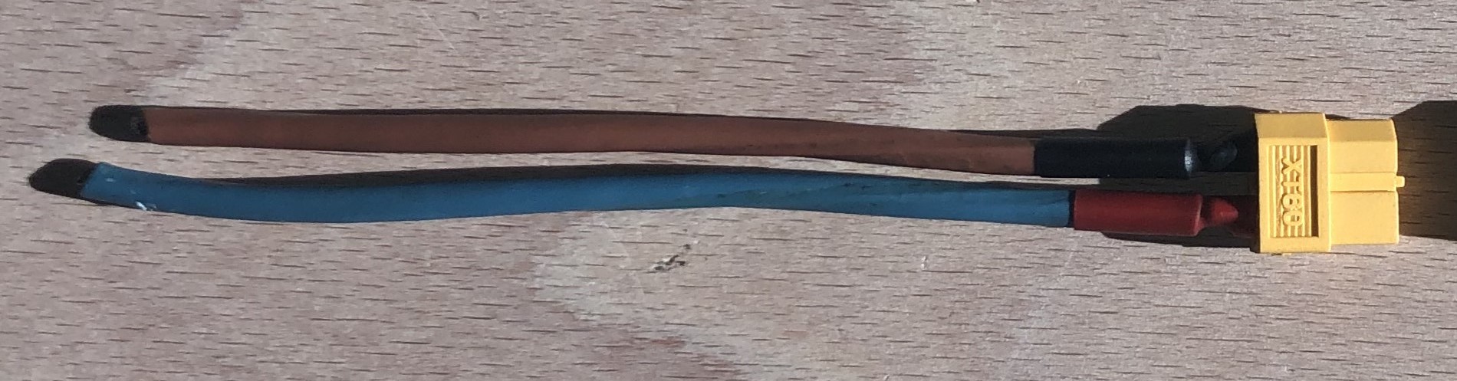
KosmosV4System/doc/pictures/V4_Batterie/IMG_15.jpg
