ofauvarque/DocV4/KosmosV4System/doc/pictures/V4_Batterie/IMG_156.jpg

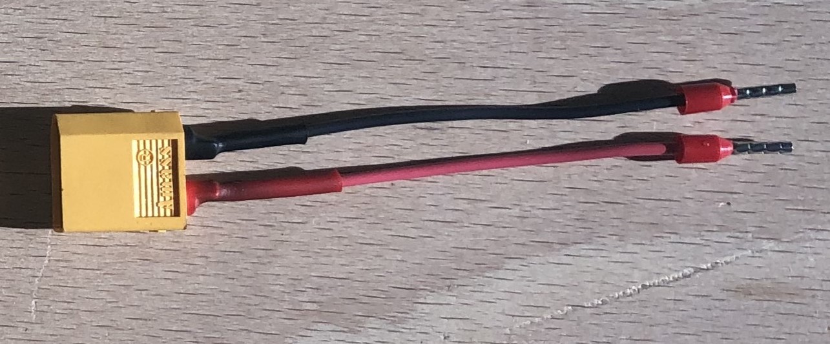
KosmosV4System/doc/pictures/V4_Batterie/IMG_156.jpg
