ofauvarque/DocV4/KosmosV4System/doc/pictures/V4_Batterie/IMG_0526.JPG

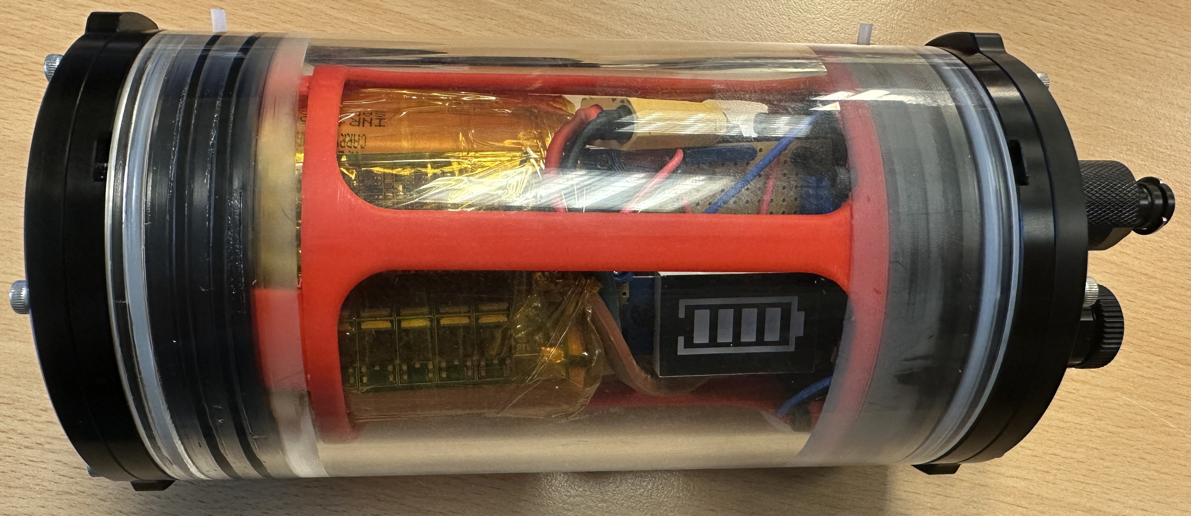
KosmosV4System/doc/pictures/V4_Batterie/IMG_0526.JPG
