ofauvarque/DocV4/KosmosV4System/doc/pictures/V4_Batterie/IMG_0817.JPG

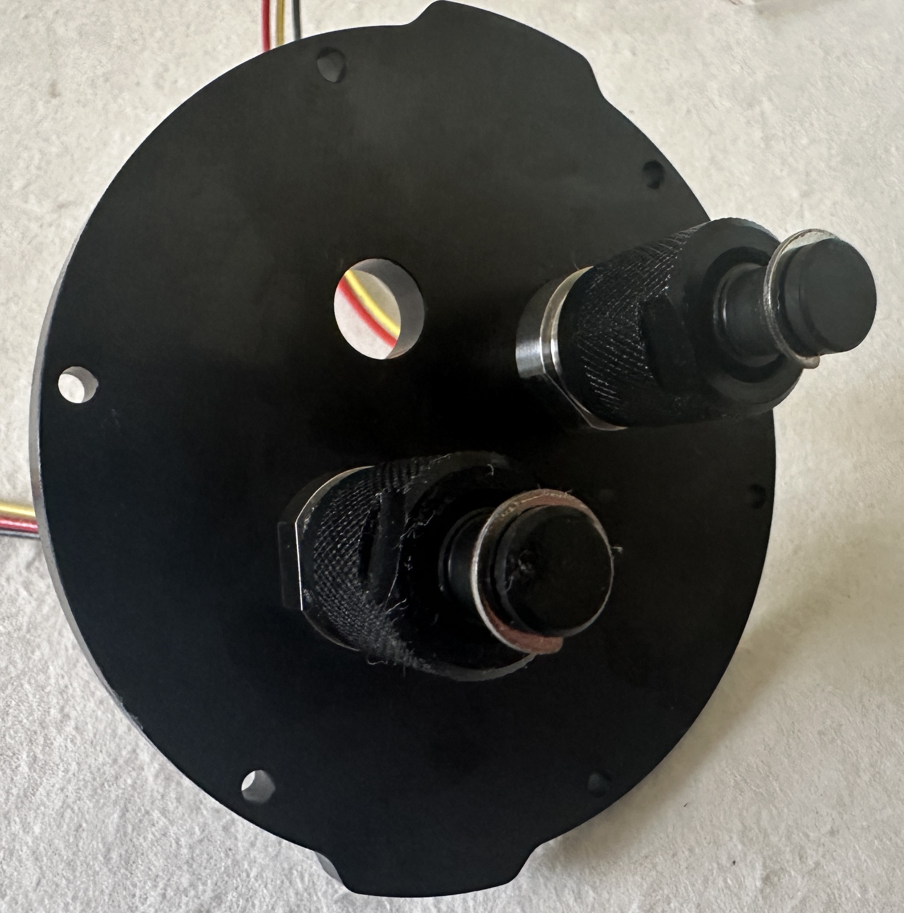
KosmosV4System/doc/pictures/V4_Batterie/IMG_0817.JPG
