ofauvarque/DocV4/KosmosV4System/doc/pictures/V4_Batterie/IMG_1574.jpg

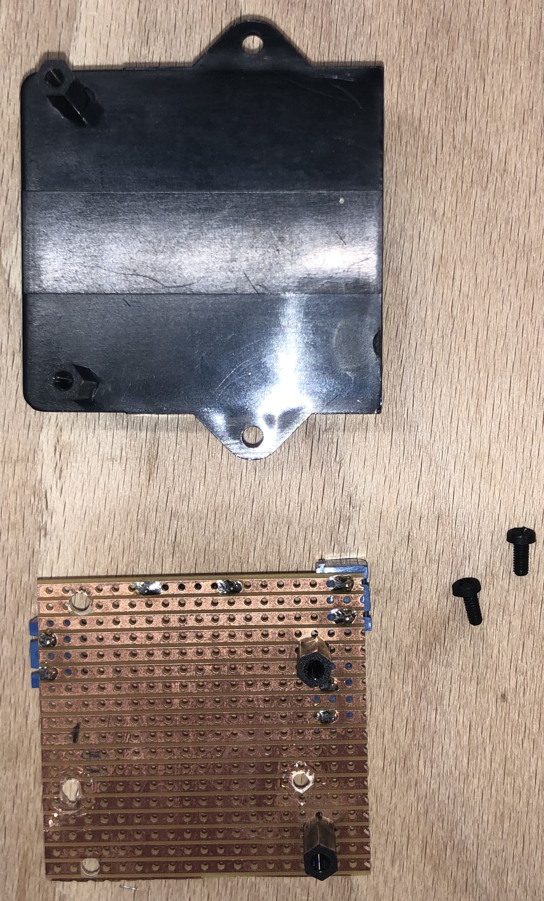
KosmosV4System/doc/pictures/V4_Batterie/IMG_1574.jpg
