ofauvarque/DocV4/KosmosV4System/doc/pictures/V4_Batterie/IMG_1716.jpg

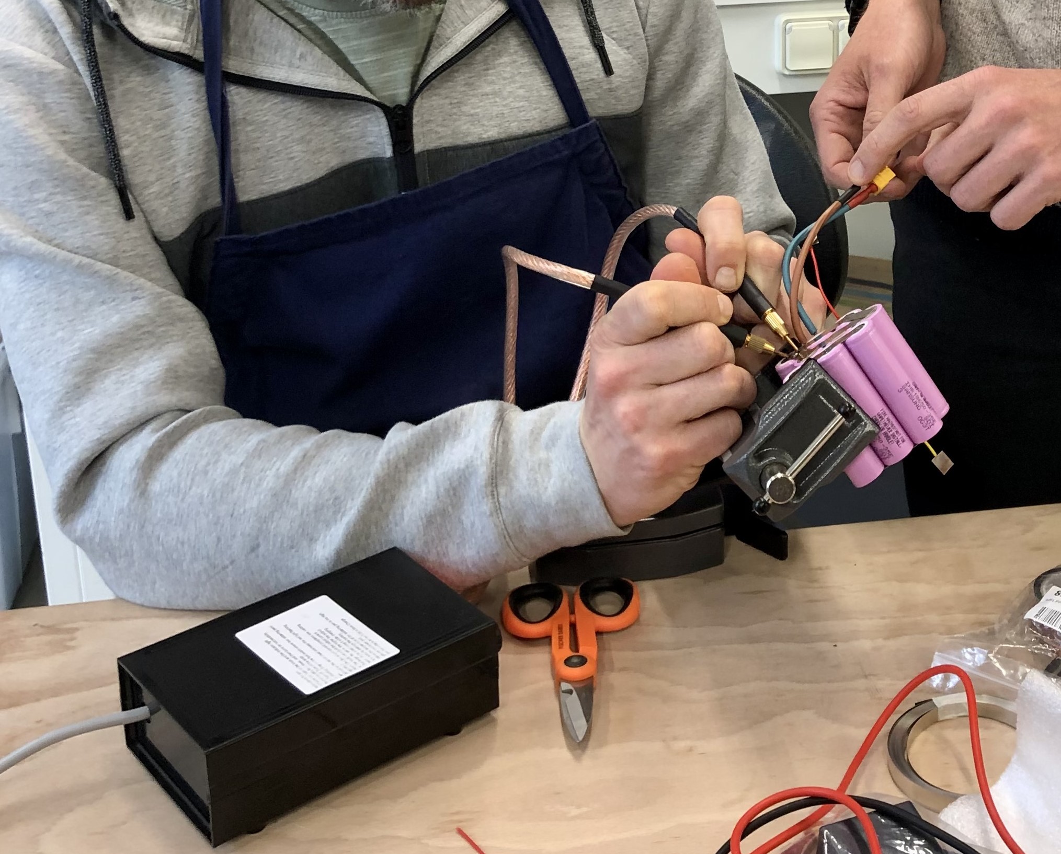
KosmosV4System/doc/pictures/V4_Batterie/IMG_1716.jpg
