ofauvarque/DocV4/KosmosV4System/doc/pictures/V4_Batterie/IMG_1773.jpg

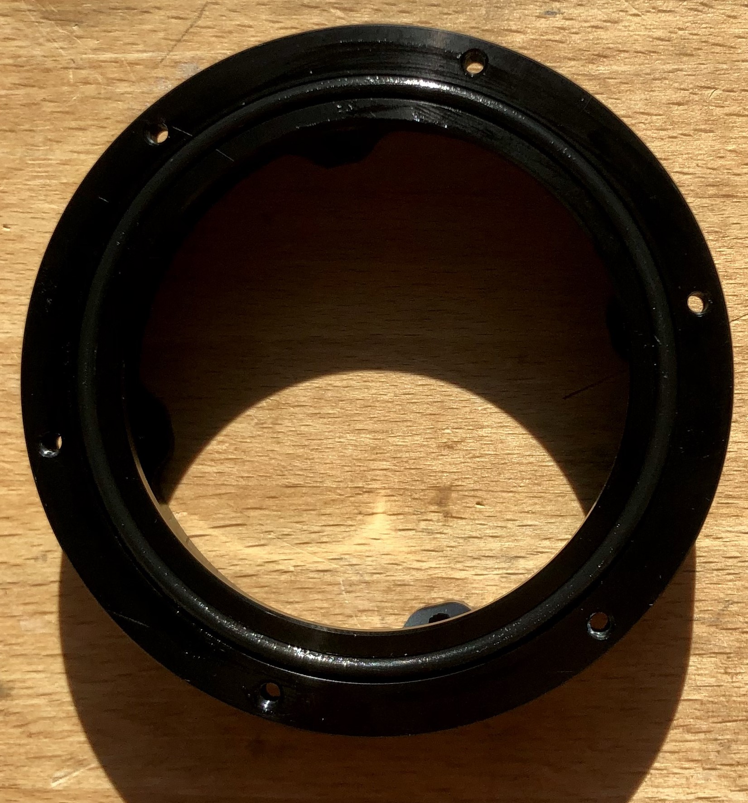
KosmosV4System/doc/pictures/V4_Batterie/IMG_1773.jpg
