ofauvarque/DocV4/KosmosV4System/doc/pictures/V4_Batterie/IMG_1776.jpg

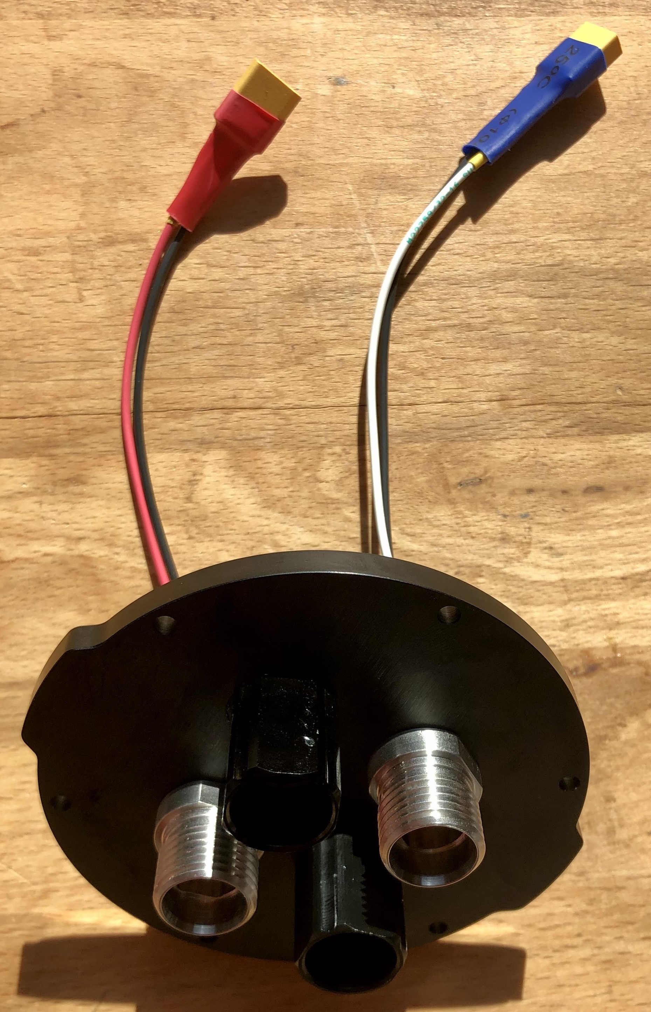
KosmosV4System/doc/pictures/V4_Batterie/IMG_1776.jpg
