ofauvarque/DocV4/KosmosV4System/doc/pictures/V4_Batterie/IMG_1777.jpg

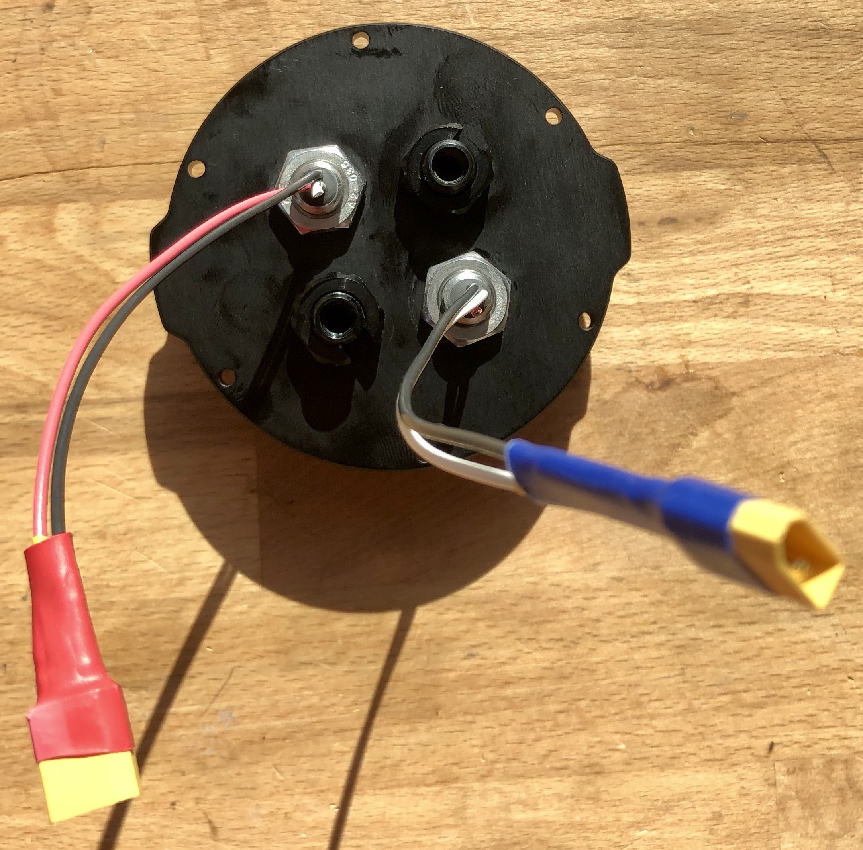
KosmosV4System/doc/pictures/V4_Batterie/IMG_1777.jpg
