ofauvarque/DocV4/KosmosV4System/doc/pictures/V4_Batterie/IMG_4648.jpg

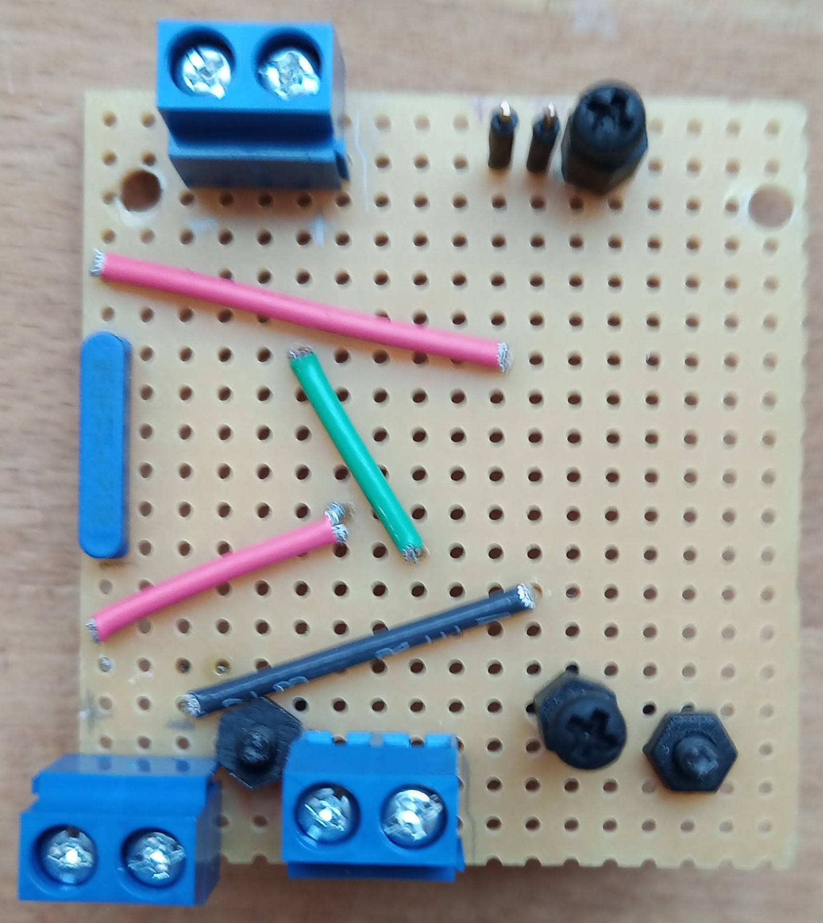
KosmosV4System/doc/pictures/V4_Batterie/IMG_4648.jpg
