ofauvarque/DocV4/KosmosV4System/doc/pictures/V4_Batterie/IMG_4653.jpg

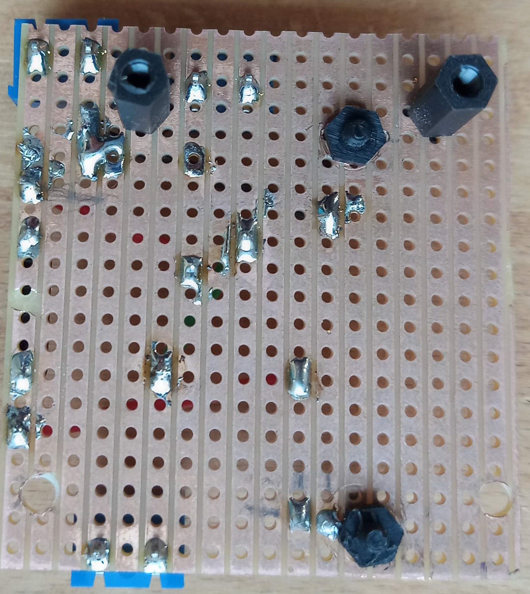
KosmosV4System/doc/pictures/V4_Batterie/IMG_4653.jpg
