ofauvarque/DocV4/KosmosV4System/doc/pictures/V4_Batterie/IMG_5129.jpg

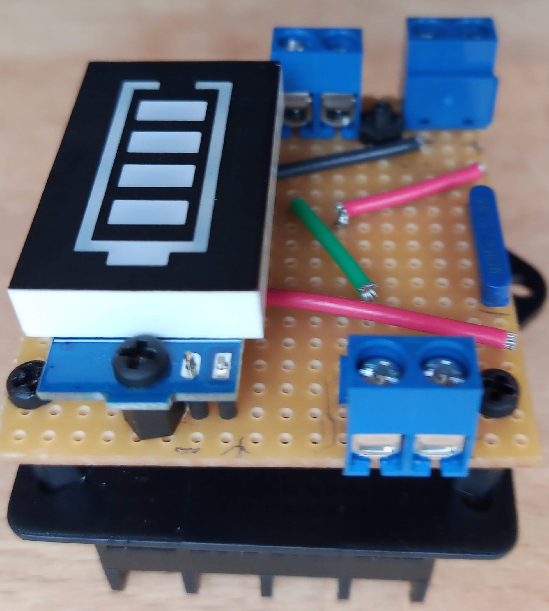
KosmosV4System/doc/pictures/V4_Batterie/IMG_5129.jpg
