ofauvarque/DocV4/KosmosV4System/doc/pictures/V4_Batterie/IMG_20250408_151946.jpg

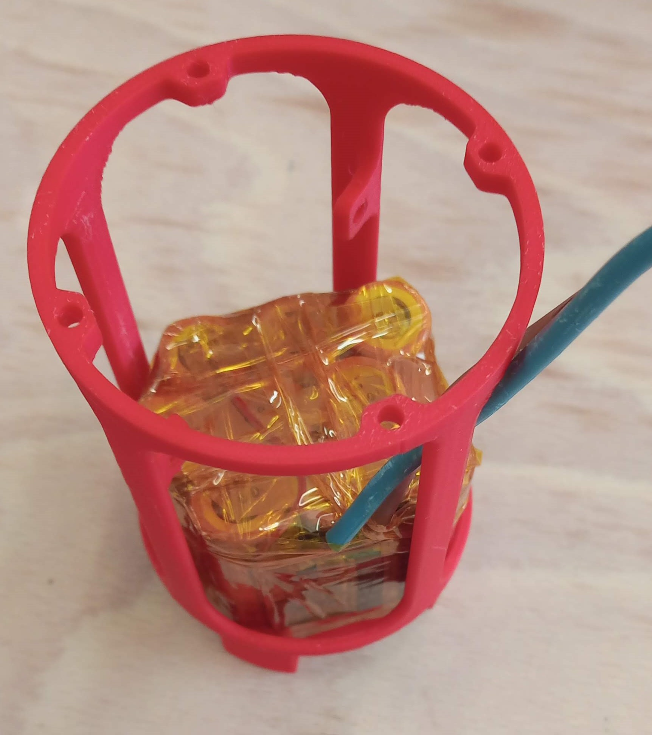
KosmosV4System/doc/pictures/V4_Batterie/IMG_20250408_151946.jpg
