ofauvarque/DocV4/KosmosV4System/doc/pictures/V4_Batterie/IMG_20250408_152120.jpg

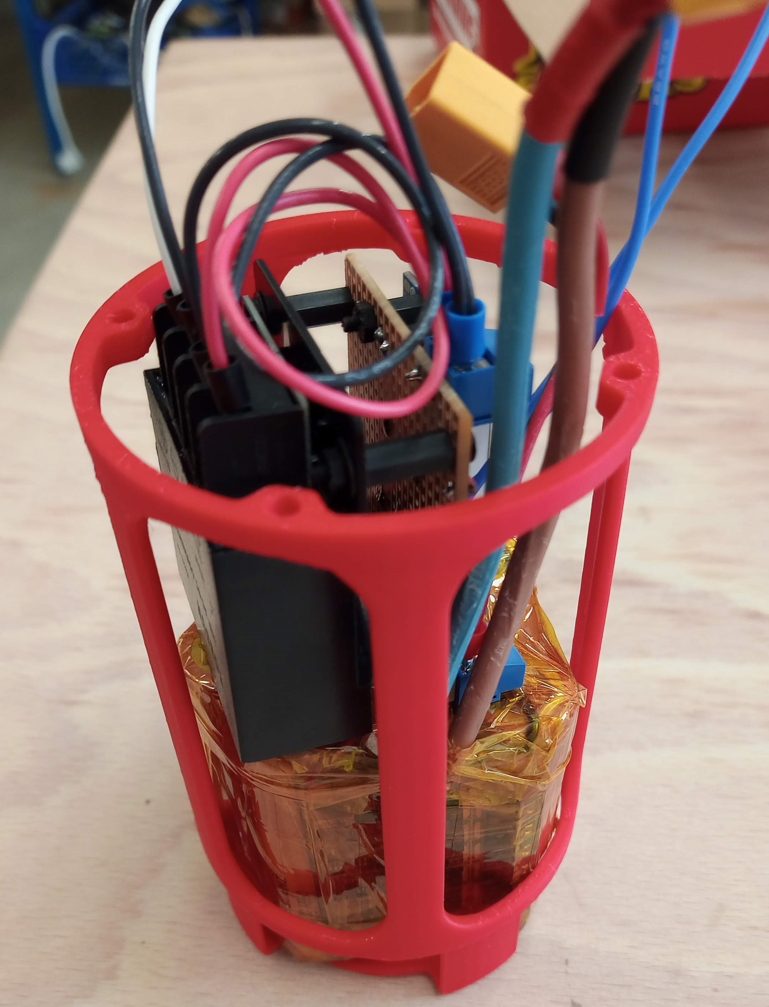
KosmosV4System/doc/pictures/V4_Batterie/IMG_20250408_152120.jpg
