ofauvarque/DocV4/KosmosV4System/doc/pictures/V4_Batterie/IMG_20250408_152518.jpg

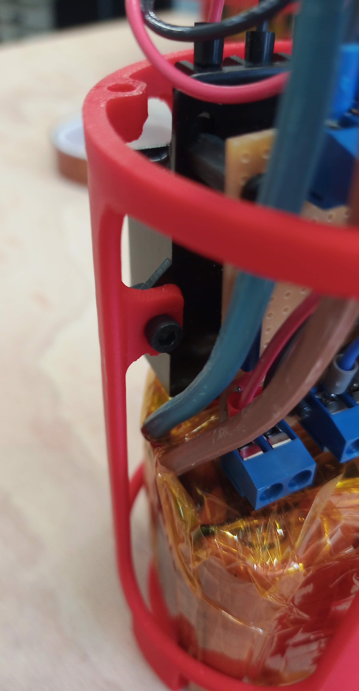
KosmosV4System/doc/pictures/V4_Batterie/IMG_20250408_152518.jpg
