ofauvarque/DocV4/KosmosV4System/doc/pictures/V4_Batterie/IMG_E1629.JPG

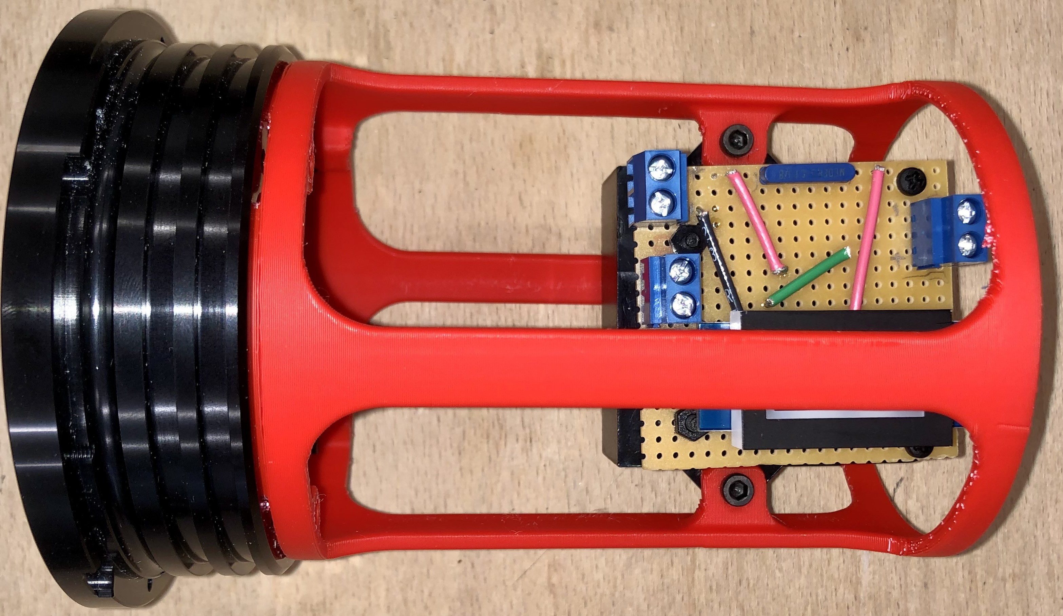
KosmosV4System/doc/pictures/V4_Batterie/IMG_E1629.JPG
