ofauvarque/DocV4/KosmosV4System/doc/pictures/V4_Batterie/SwitchCoupe.jpeg

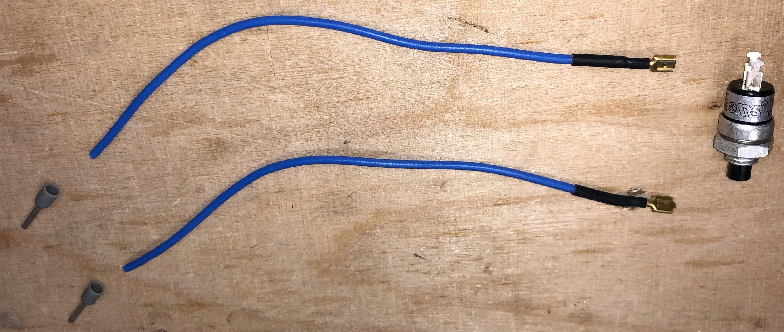
KosmosV4System/doc/pictures/V4_Batterie/SwitchCoupe.jpeg
