ofauvarque/DocV4/KosmosV4System/doc/pictures/V4_Batterie/SwitchOrigine.jpeg

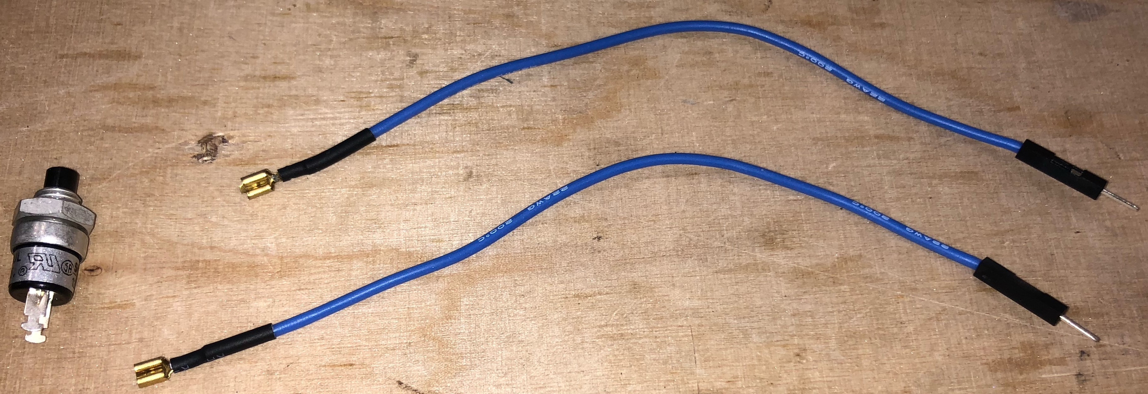
KosmosV4System/doc/pictures/V4_Batterie/SwitchOrigine.jpeg
