ofauvarque/DocV4/KosmosV4System/doc/pictures/V4_Batterie/VueGenerale.jpg

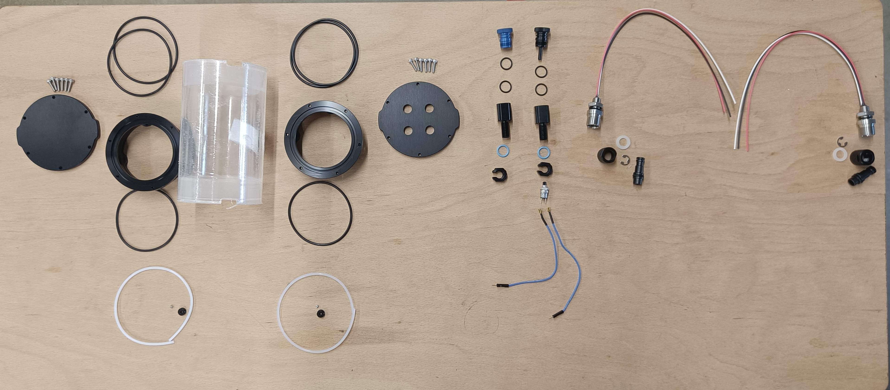
KosmosV4System/doc/pictures/V4_Batterie/VueGenerale.jpg
