ofauvarque/DocV4/KosmosV4System/doc/pictures/V4_Moteur/IMG_0695.JPG

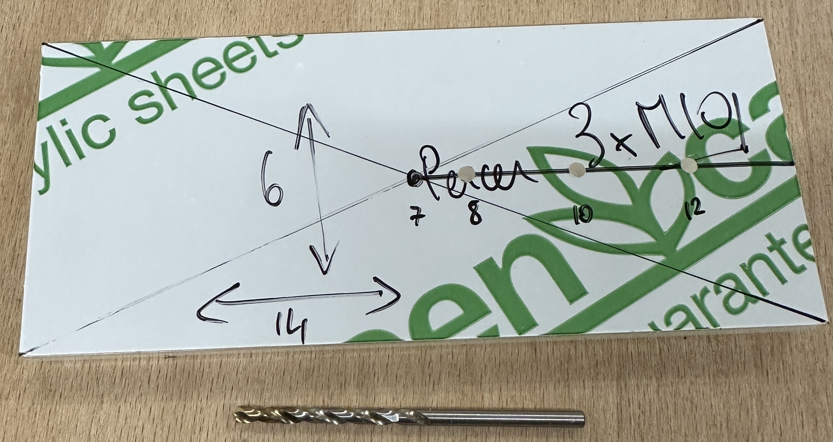
KosmosV4System/doc/pictures/V4_Moteur/IMG_0695.JPG
