ofauvarque/DocV4/KosmosV4System/doc/pictures/V4_Moteur/IMG_0706.JPG

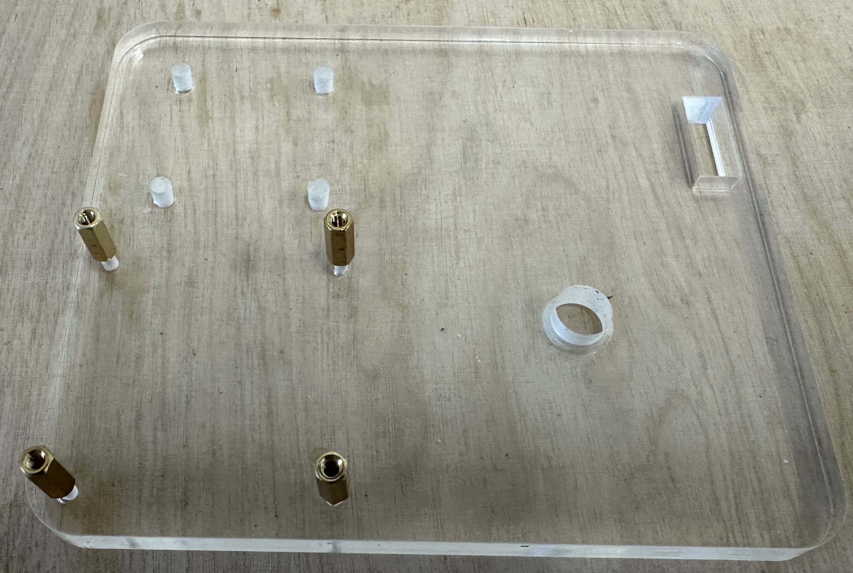
KosmosV4System/doc/pictures/V4_Moteur/IMG_0706.JPG
