ofauvarque/DocV4/KosmosV4System/doc/pictures/V4_Moteur/IMG_0878.JPG

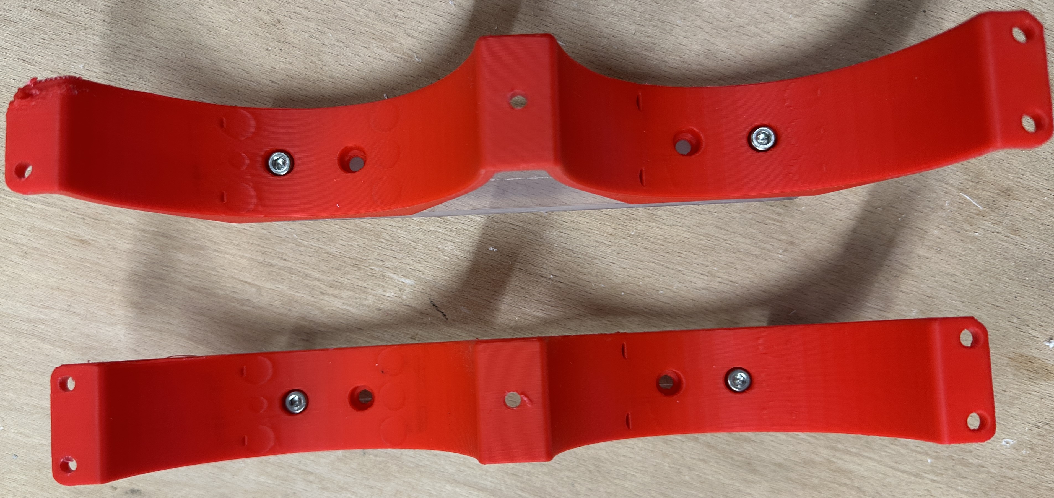
KosmosV4System/doc/pictures/V4_Moteur/IMG_0878.JPG
