ofauvarque/DocV4/KosmosV4System/doc/pictures/V4_Moteur/IMG_0884.JPG

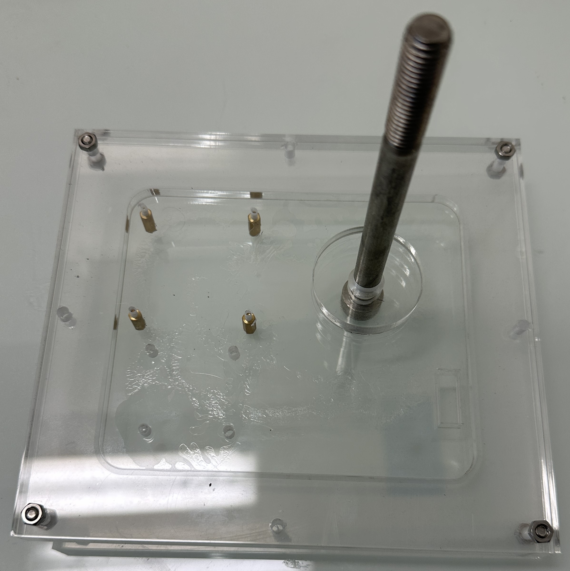
KosmosV4System/doc/pictures/V4_Moteur/IMG_0884.JPG
