ofauvarque/DocV4/KosmosV4System/doc/pictures/V4_Moteur/VueGenerale.PNG

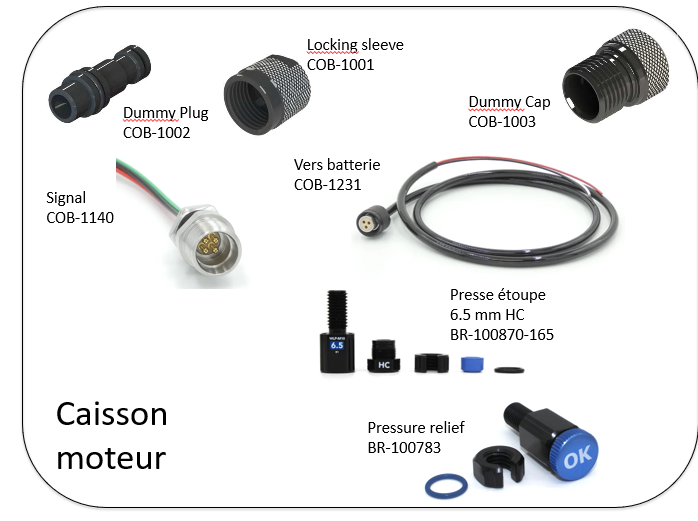
KosmosV4System/doc/pictures/V4_Moteur/VueGenerale.PNG
