ofauvarque/DocV4/KosmosV4System/doc/pictures/V4_SystemeComplet/Berceau.PNG

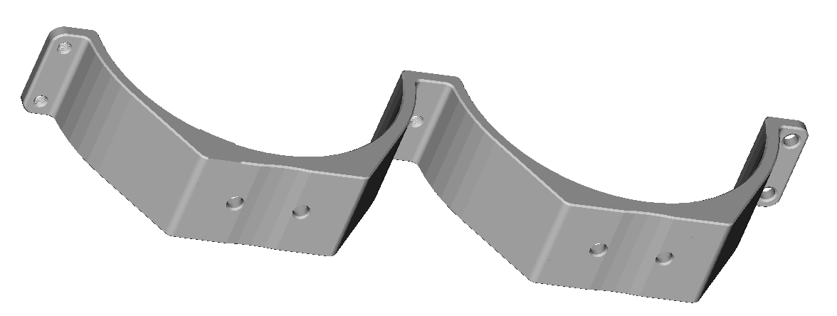
KosmosV4System/doc/pictures/V4_SystemeComplet/Berceau.PNG
