ofauvarque/DocV4/KosmosV4System/doc/pictures/V4_SystemeComplet/IMG20250122140253.jpg

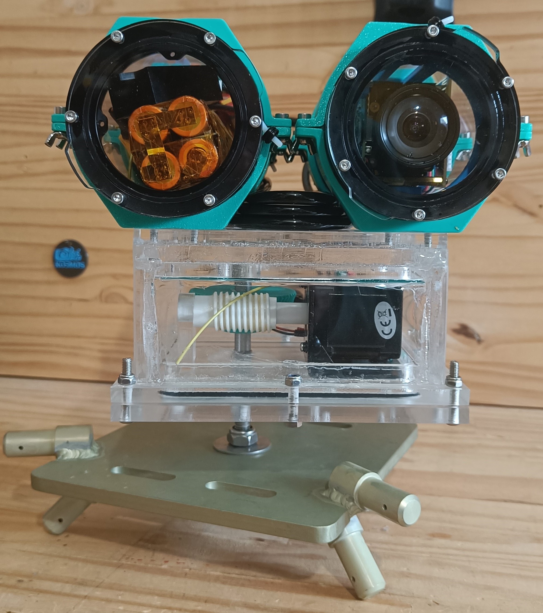
KosmosV4System/doc/pictures/V4_SystemeComplet/IMG20250122140253.jpg
