ofauvarque/DocV4/KosmosV4System/doc/pictures/V4_SystemeComplet/IMG20250122141339.jpg

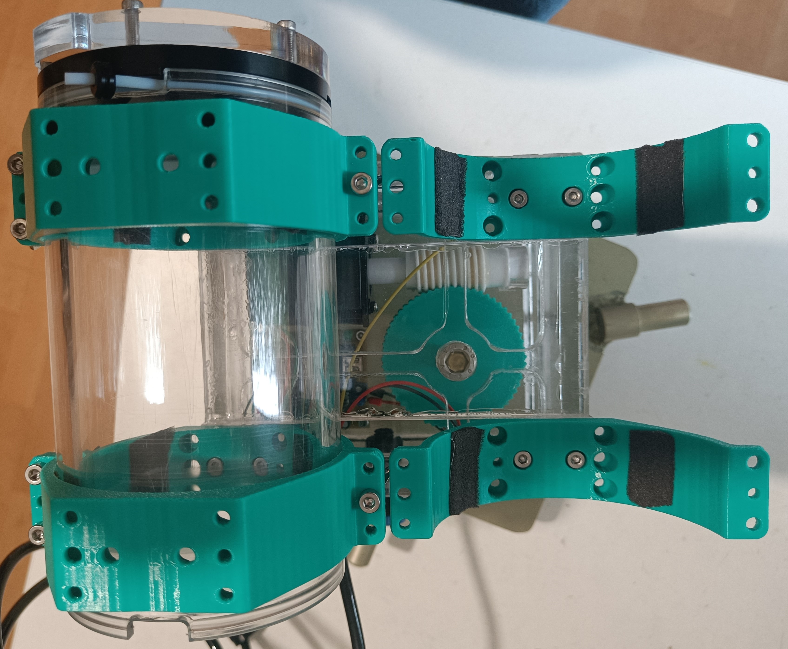
KosmosV4System/doc/pictures/V4_SystemeComplet/IMG20250122141339.jpg
