ofauvarque/DocV4/KosmosV4System/doc/pictures/V4_SystemeComplet/IMG_0546.JPG

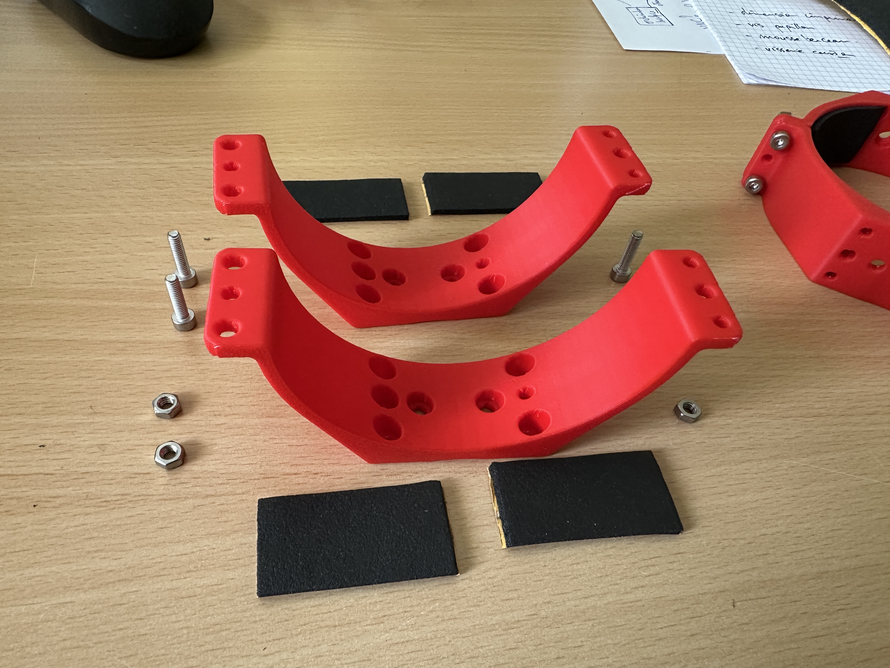
KosmosV4System/doc/pictures/V4_SystemeComplet/IMG_0546.JPG
