ofauvarque/DocV4/KosmosV4System/doc/pictures/V4_SystemeComplet/IMG_0547.JPG

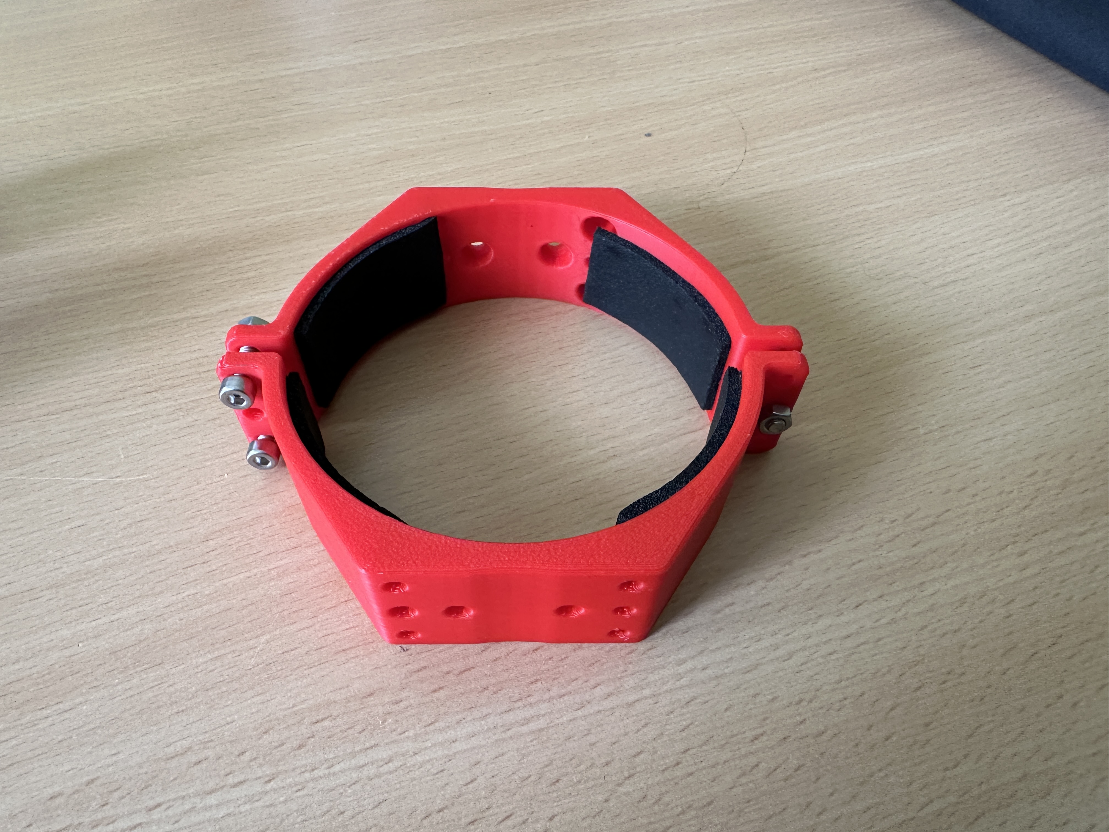
KosmosV4System/doc/pictures/V4_SystemeComplet/IMG_0547.JPG
