ofauvarque/DocV4/KosmosV4System/doc/pictures/V4_SystemeComplet/IMG_0690.JPG

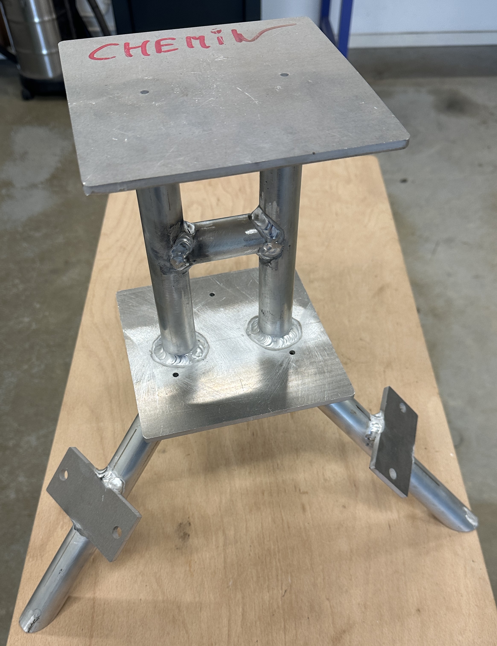
KosmosV4System/doc/pictures/V4_SystemeComplet/IMG_0690.JPG
