ofauvarque/DocV4/KosmosV4System/doc/pictures/V4_SystemeComplet/LiaisonPrincipalMoteur.jpeg

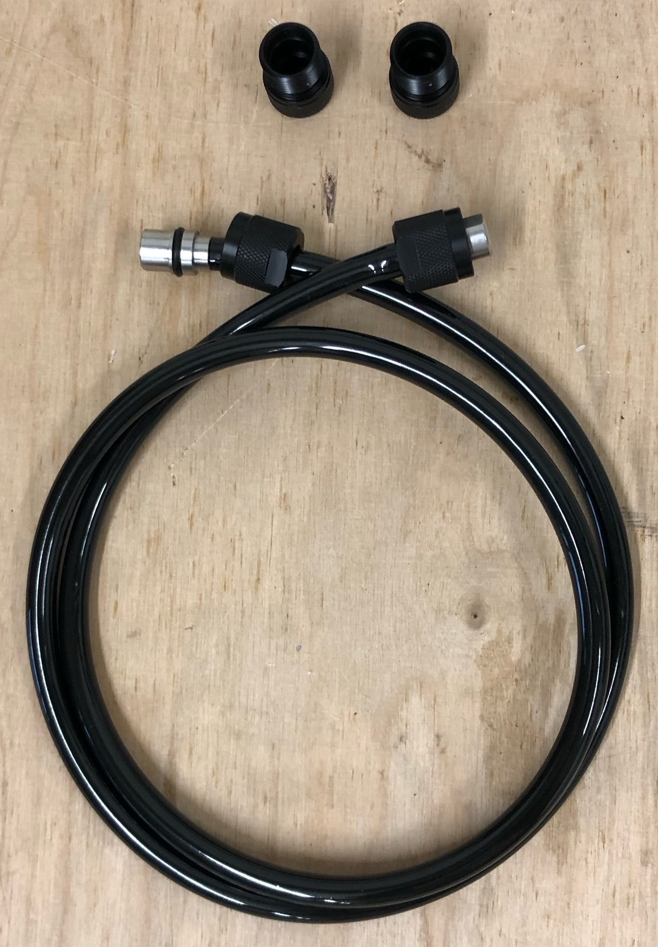
KosmosV4System/doc/pictures/V4_SystemeComplet/LiaisonPrincipalMoteur.jpeg
