ofauvarque/DocV4/KosmosV4System/doc/pictures/V4_Video/11_2.jpeg

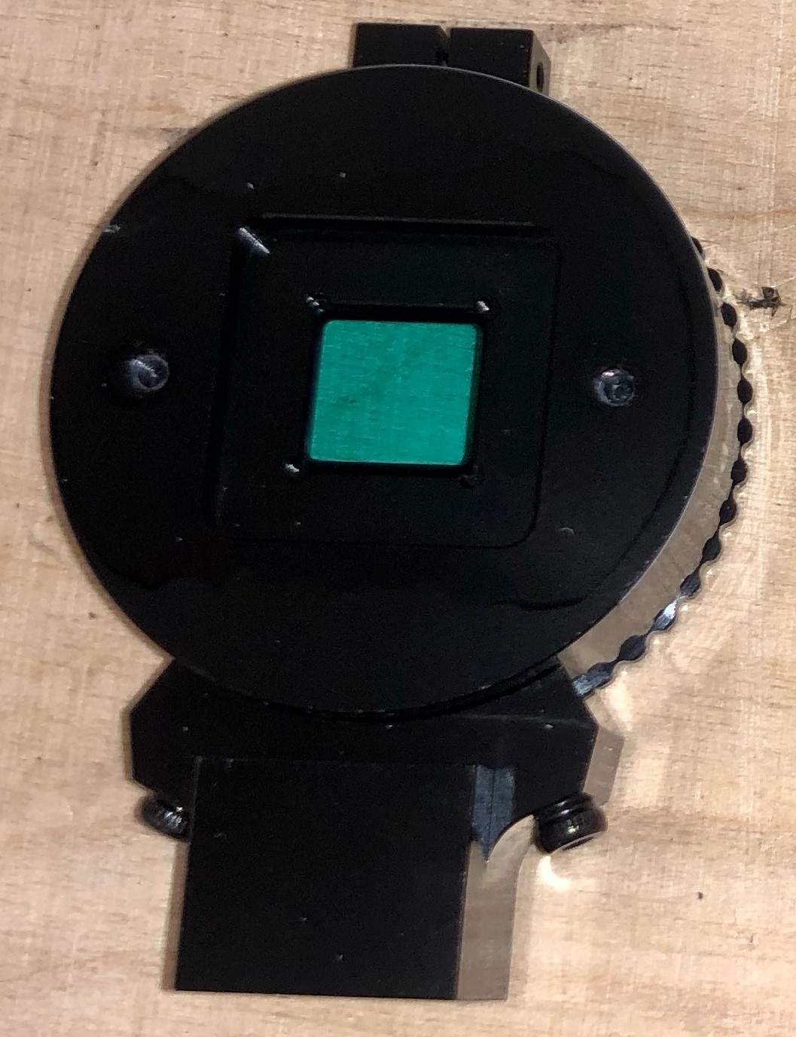
KosmosV4System/doc/pictures/V4_Video/11_2.jpeg
