ofauvarque/DocV4/KosmosV4System/doc/pictures/V4_Video/15.jpeg

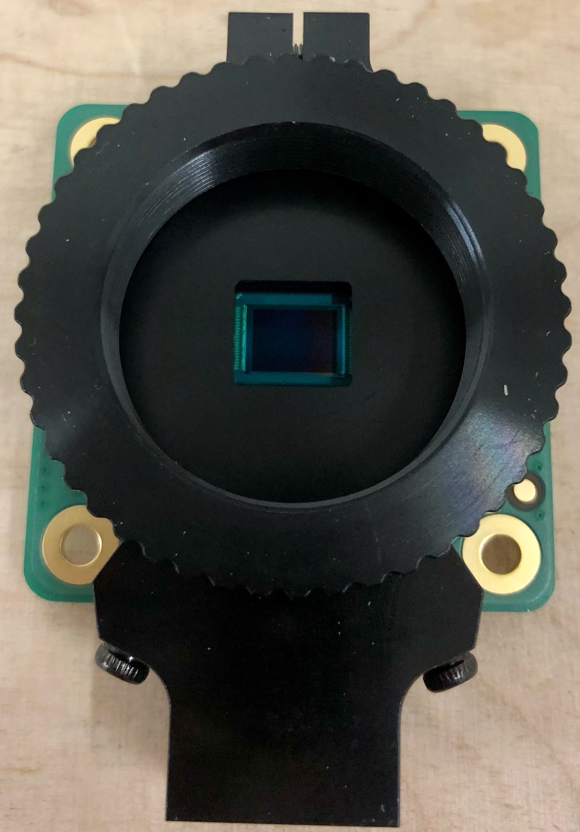
KosmosV4System/doc/pictures/V4_Video/15.jpeg
