ofauvarque/DocV4/KosmosV4System/doc/pictures/V4_Video/18.jpeg

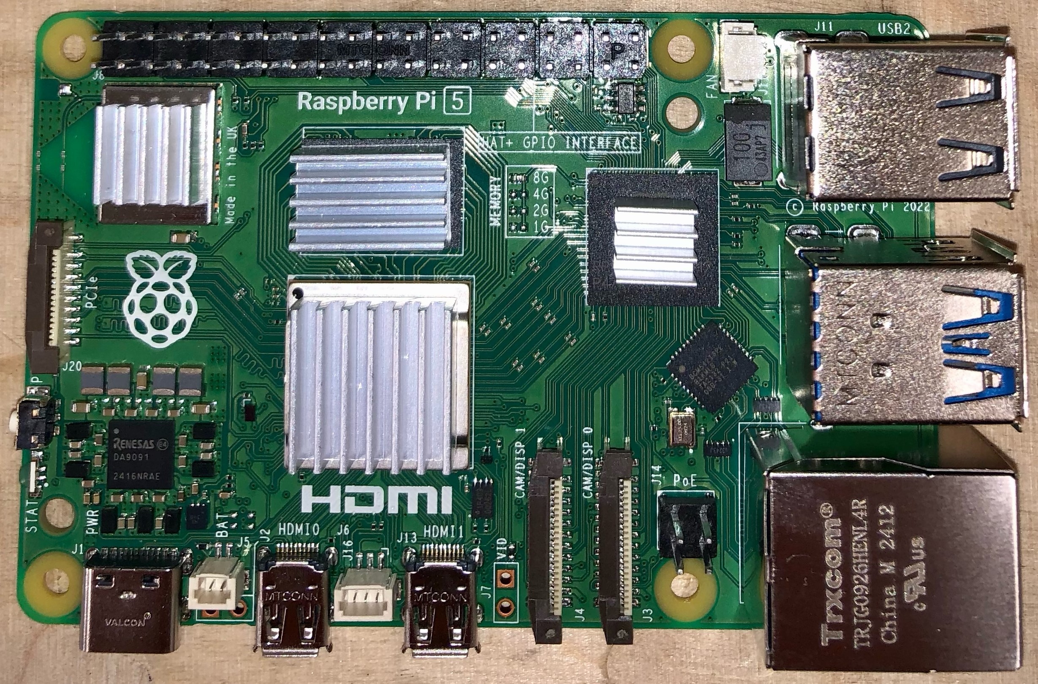
KosmosV4System/doc/pictures/V4_Video/18.jpeg
