ofauvarque/DocV4/KosmosV4System/doc/pictures/V4_Video/IMG30.jpg

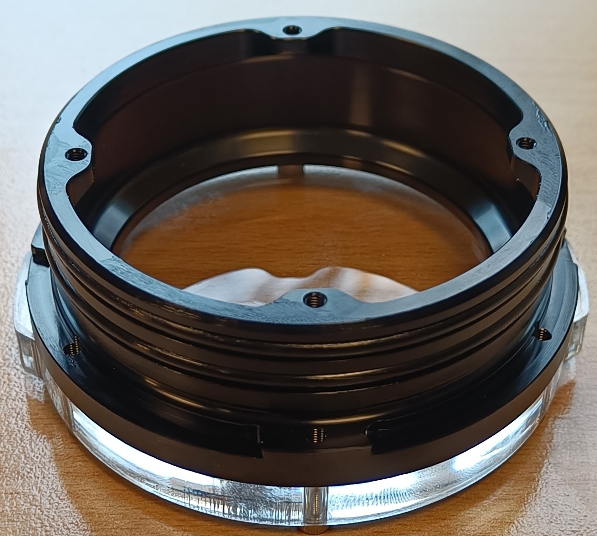
KosmosV4System/doc/pictures/V4_Video/IMG30.jpg
