ofauvarque/DocV4/KosmosV4System/doc/pictures/V4_Video/IMG_1567.jpg

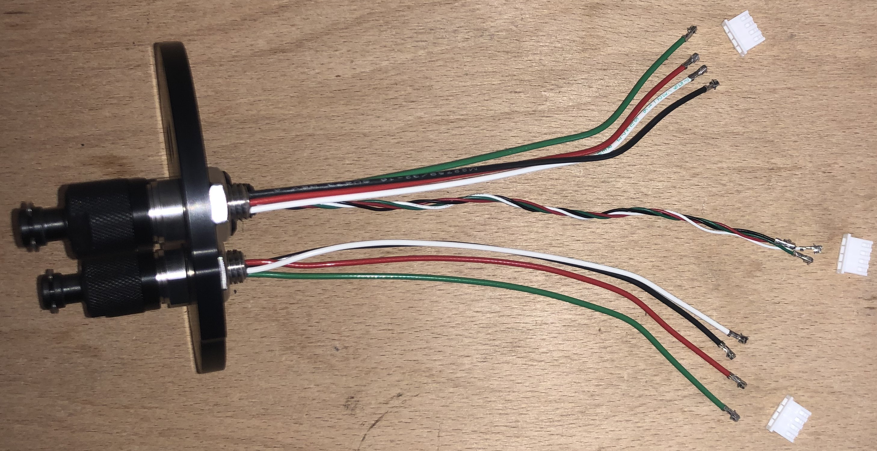
KosmosV4System/doc/pictures/V4_Video/IMG_1567.jpg
