ofauvarque/DocV4/KosmosV4System/doc/pictures/V4_Video/IMG_1577.jpg

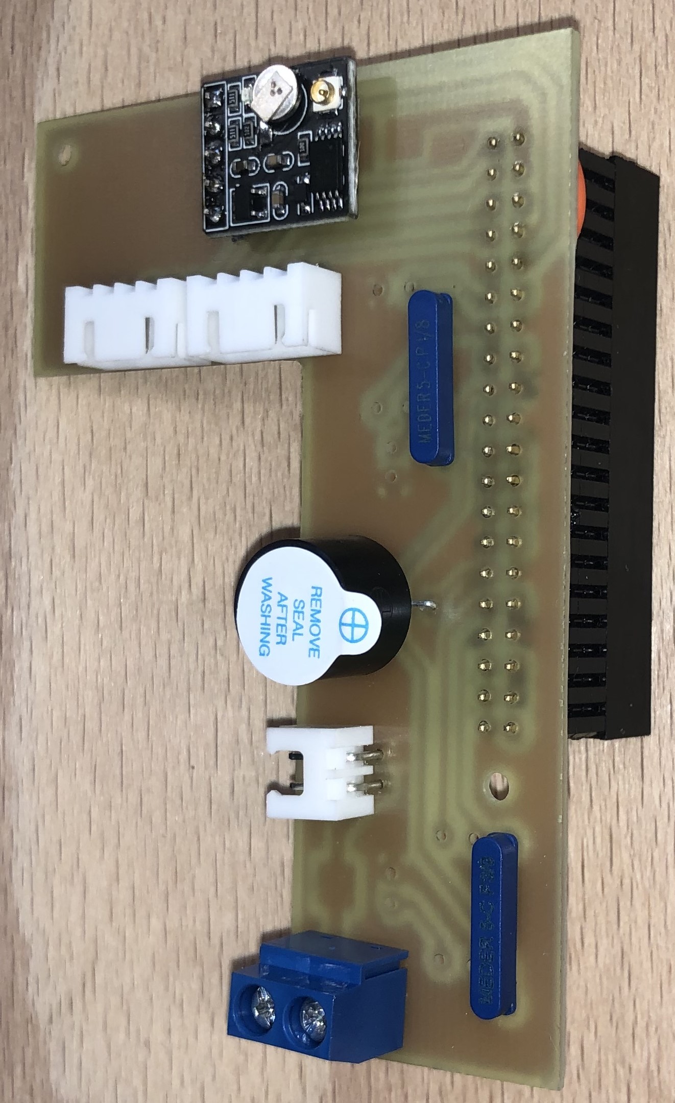
KosmosV4System/doc/pictures/V4_Video/IMG_1577.jpg
