ofauvarque/DocV4/KosmosV4System/doc/pictures/V4_Video/IMG_1612.JPG

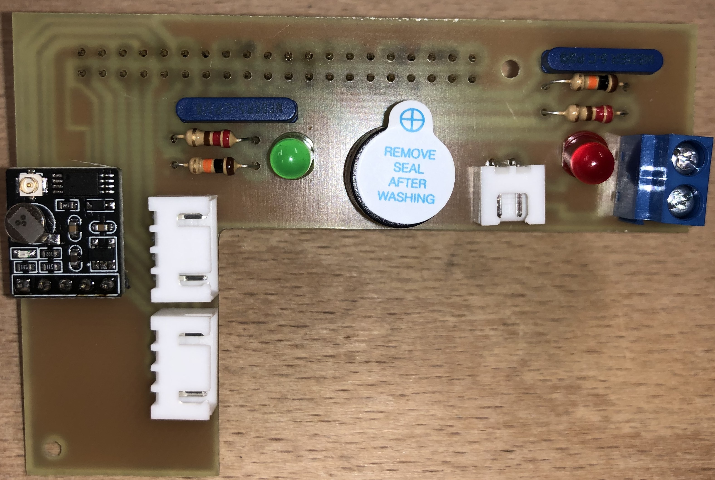
KosmosV4System/doc/pictures/V4_Video/IMG_1612.JPG
