ofauvarque/DocV4/KosmosV4System/doc/pictures/V4_Video/schemaLED.png

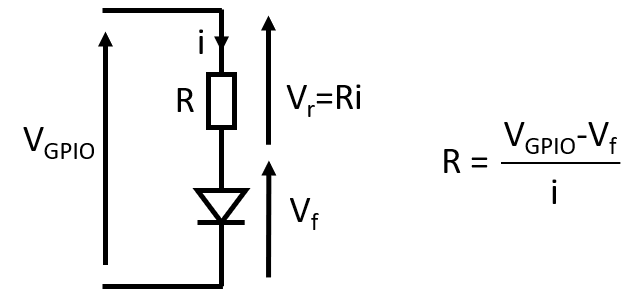
KosmosV4System/doc/pictures/V4_Video/schemaLED.png
