ofauvarque/DocV4/MagpiSystem/doc/pictures/03_Logiciel/first_launch.PNG

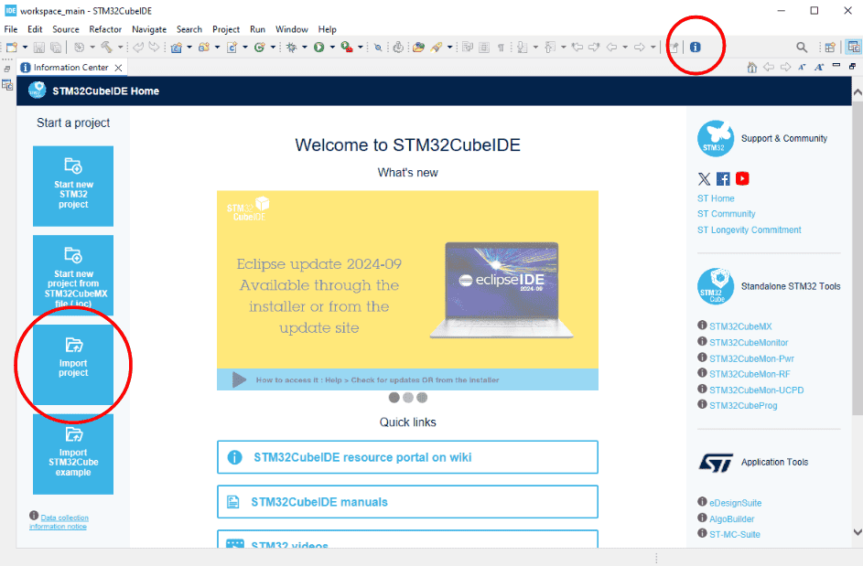
MagpiSystem/doc/pictures/03_Logiciel/first_launch.PNG
