ofauvarque/DocV4/MagpiSystem/doc/pictures/03_Logiciel/import_project.PNG

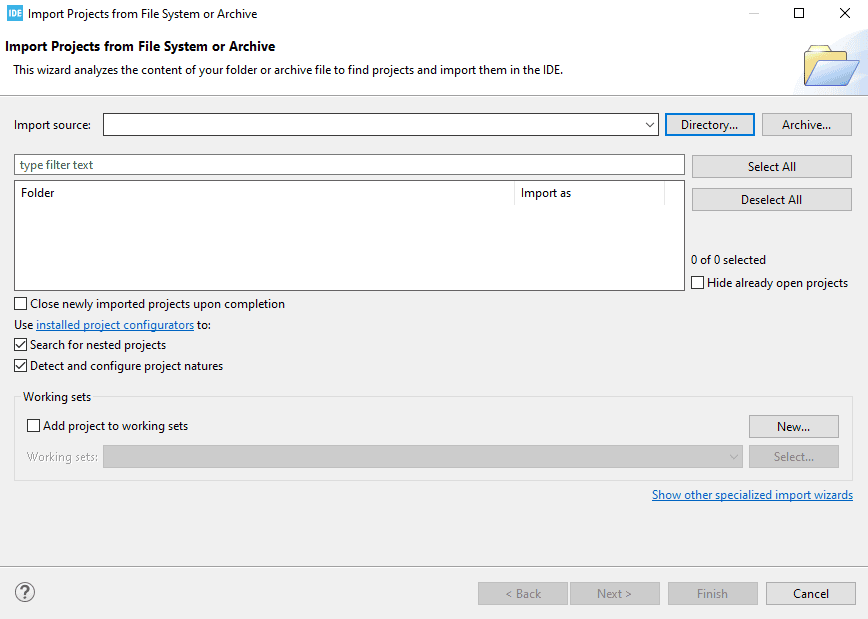
MagpiSystem/doc/pictures/03_Logiciel/import_project.PNG
