ofauvarque/DocV4/MagpiSystem/doc/pictures/03_Logiciel/project_opened.PNG

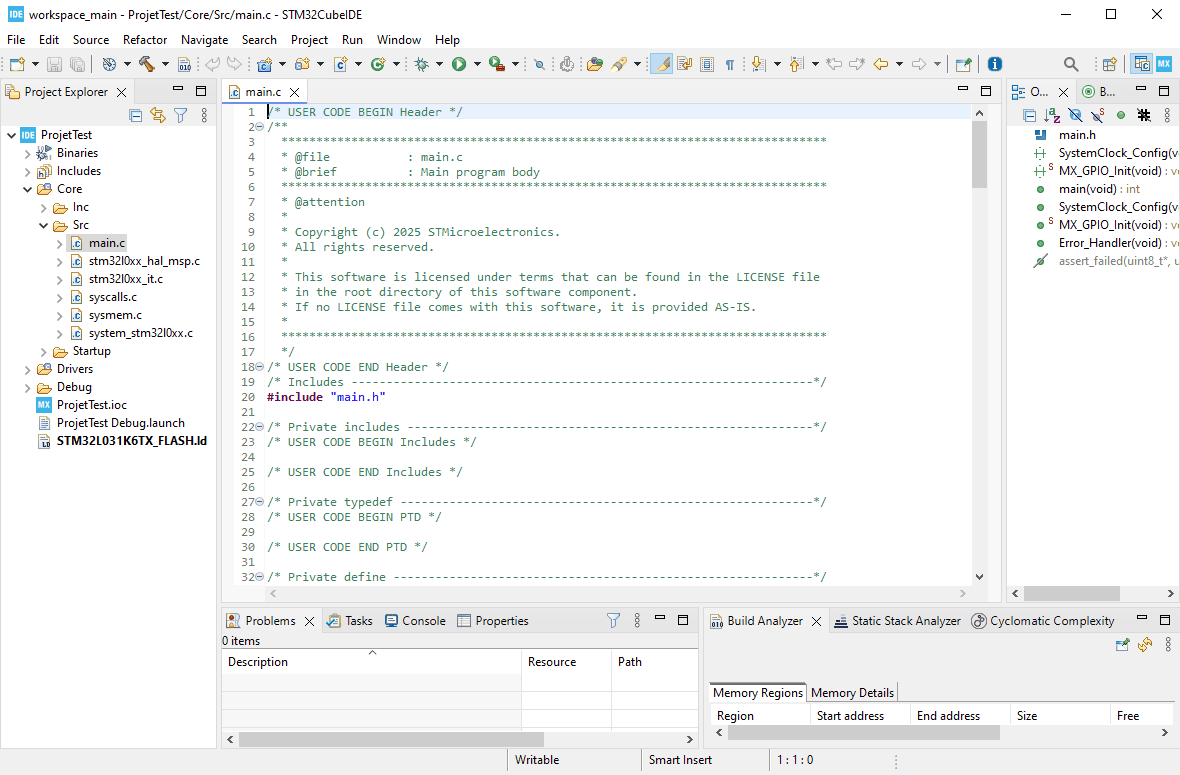
MagpiSystem/doc/pictures/03_Logiciel/project_opened.PNG
