ofauvarque/DocV4/MagpiSystem/doc/pictures/03_Logiciel/stLink_not_detected.PNG

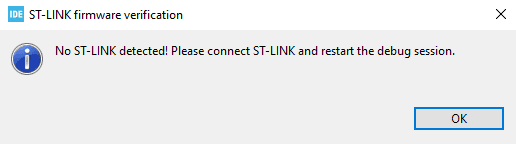
MagpiSystem/doc/pictures/03_Logiciel/stLink_not_detected.PNG
