ofauvarque/DocV4/MagpiSystem/doc/pictures/03_Logiciel/stm32_led_LD3.PNG

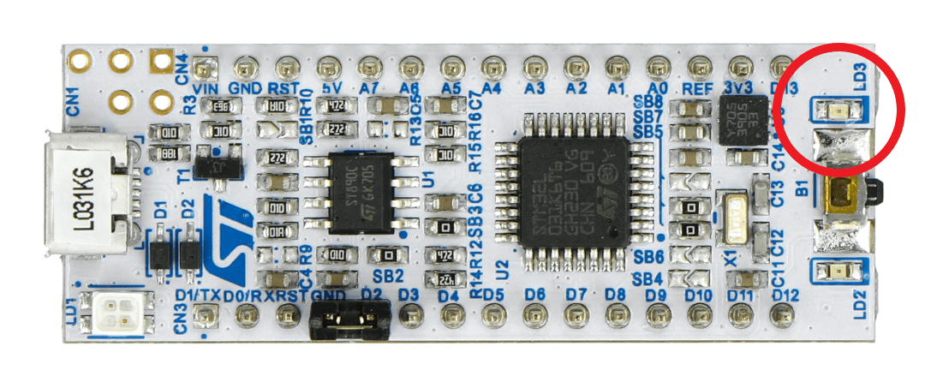
MagpiSystem/doc/pictures/03_Logiciel/stm32_led_LD3.PNG
