ofauvarque/DocV4/MagpiSystem/doc/pictures/03_Logiciel/stm32l031k6.PNG

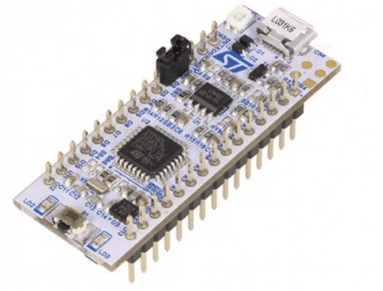
MagpiSystem/doc/pictures/03_Logiciel/stm32l031k6.PNG
