ofauvarque/DocV4/MagpiSystem/doc/pictures/03_Logiciel/USB_Micro-USB.PNG

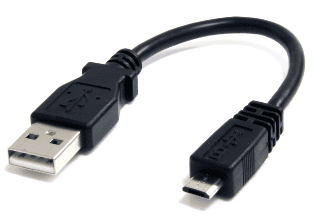
MagpiSystem/doc/pictures/03_Logiciel/USB_Micro-USB.PNG
