ofauvarque/DocV4/MagpiSystem/doc/pictures/04_Câblage/pince_sertir.jpg

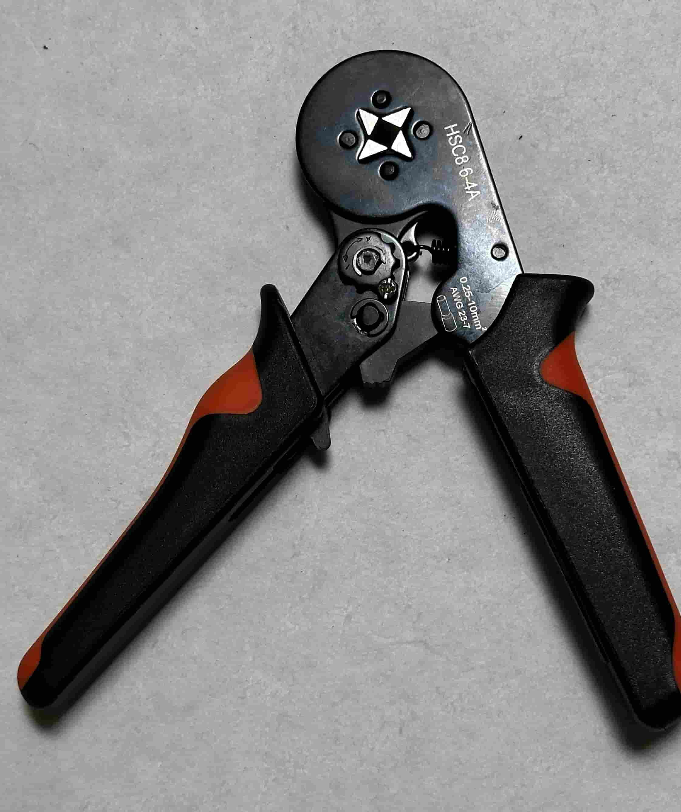
MagpiSystem/doc/pictures/04_Câblage/pince_sertir.jpg
