ofauvarque/DocV4/MagpiSystem/doc/pictures/04_Câblage/schema_cablage.png

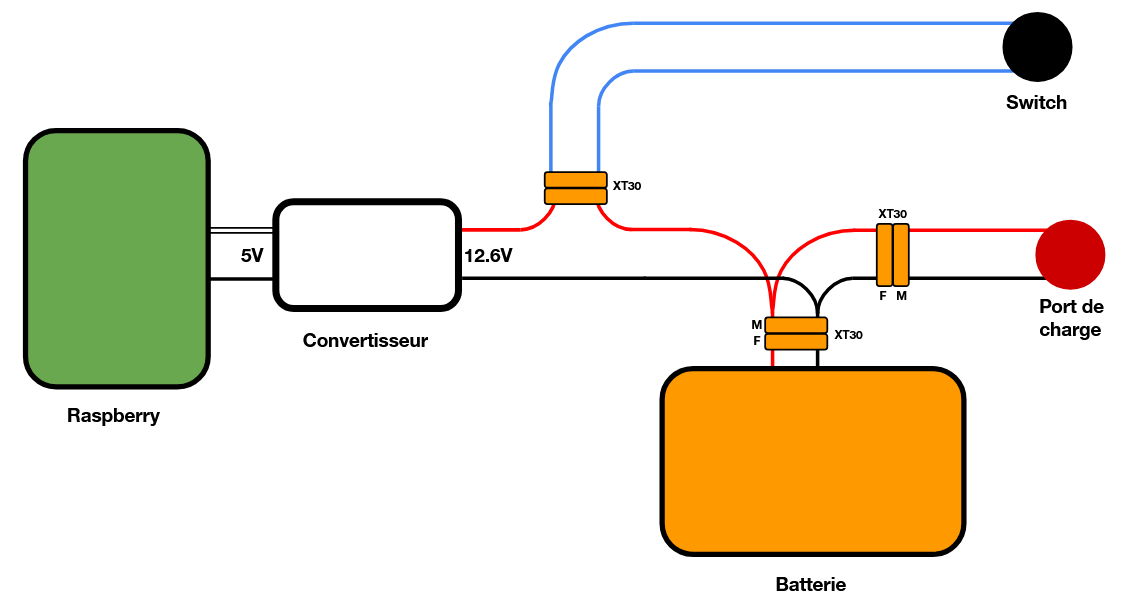
MagpiSystem/doc/pictures/04_Câblage/schema_cablage.png
