ofauvarque/DocV4/MagpiSystem/doc/pictures/readmeIllustration.png

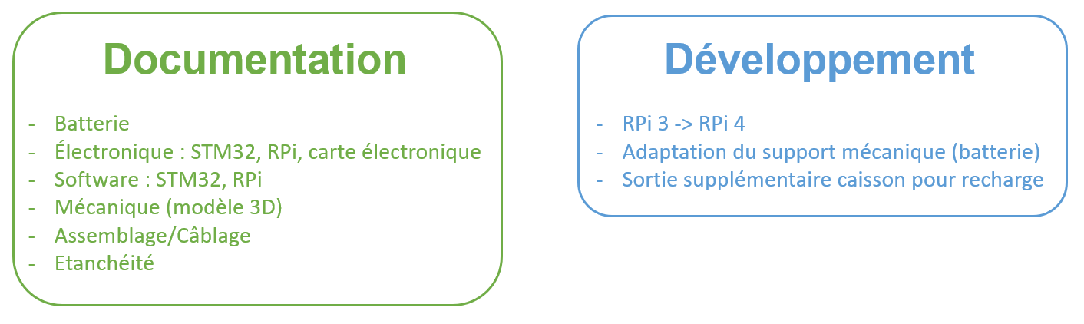
MagpiSystem/doc/pictures/readmeIllustration.png
