ofauvarque/DocV4/MagpiSystem/doc/sourcing/ElectroniqueMagPi.xlsx

Dernière mise à jour : | 2025-12-24 |  |  |  | O Fauvarque
Fournisseur | Caisson concerné | Description KOSMOS | Désignation fournisseur | Référence fournisseur | Lien fournisseur | Quantité | Prix unitaire (HT) | Prix unitaire (TTC) | Prix total (TTC)
GOTRONIC
Gotronic | Electronique | Raspberry Pi | Raspberry Pi 5 - 8GB | 38580 | https://www.gotronic.fr/art-carte-raspberry-pi-5-8-gb-38177.htm | 1 | 95.75 € | 114.90 € | 114.90 €
Gotronic | Electronique | Batterie RTC | Batterie RTC pour Raspberry Pi 5 | 38644 | https://www.gotronic.fr/art-batterie-rtc-pour-raspberry-pi-5-38451.htm | 1 | 5.75 € | 6.90 € | 6.90 €
Gotronic | Electronique | Dissipateurs thermiques | Set de 4 heat sinks aluminium | 11937 | https://www.gotronic.fr/art-radiateurs-economiques-pour-raspberry-pi-4b-32410.htm | 1 | 1.25 € | 1.50 € | 1.50 €
Gotronic | Video | Caméra (solution 1) | Caméra 1,6 Mpx C/CS SC0926 | 38395 | https://www.gotronic.fr/art-camera-1-6-mpx-c-cs-sc0926-37487.htm | 1 | 58.25 € | 69.90 € | 69.90 €
Gotronic | Video | Caméra (solution 2) | Module caméra 5 MPx CAMERA-JT | 35897 | https://www.gotronic.fr/art-module-camera-5-mpx-camera-jt-28027.htm | 1
Gotronic | Video | Nappe caméra 15 cm | Nappe caméra pour Pi Zero RB0-CAM-15 | 37353 | https://www.gotronic.fr/art-nappe-camera-pour-pi-zero-rb0-cam-15-33987.htm | 1 | 2.00 € | 2.40 € | 2.40 €
Gotronic | Consommables | Jeu de rilsans | Jeu de 75 serre-câbles TF01 | 11356 | https://www.gotronic.fr/art-jeu-de-75-serre-cables-tf01-6382.htm | 1 | 1.92 € | 2.30 € | 2.30 €
Gotronic | Batterie | Câbles d’équilibrage | Cordon JST PH femelle 4 cts JST4 vers fils - avec embase JST mâle à souder | 48918 | https://www.gotronic.fr/art-cordon-jst-ph-femelle-4-cts-jst4-22571.htm | 1 | 1.83 € | 2.20 € | 2.20 €
Gotronic | Cable recharge | Connecteur XT60 femelle | Fiche femelle 30 A XT60-F | 49285 | https://www.gotronic.fr/art-fiche-alim--f-xt60-47680.htm | 1 | 0.79 € | 0.95 € | 0.95 €
Gotronic | Cable recharge | Connecteur XT60 mâle | Fiche mâle 30 A XT60-M | 49286 | https://www.gotronic.fr/art-fiche-alim--m-xt60-47681.htm | 1 | 0.79 € | 0.95 € | 0.95 €
Gotronic | Cable recharge | Fil silicone noir | Câble silicone CS9040N | 08812 | https://www.gotronic.fr/art-cable-silicone-cs9040n-5112.htm | 1 | 3.92 € | 4.70 € | 4.70 €
Gotronic | Cable recharge | Fil silicone rouge | Câble silicone CS9040R | 08817 | https://www.gotronic.fr/art-cable-silicone-cs9040r-5115.htm | 1 | 3.92 € | 4.70 € | 4.70 €
Gotronic | Cable recharge | Connecteur banane noir | Fiche banane 1010N | 08240 | https://www.gotronic.fr/art-fiche-banane-1010n-178.htm | 1 | 0.96 € | 1.15 € | 1.15 €
Gotronic | Cable recharge | Connecteur banne rouge | Fiche banane 1010R | 08241 | https://www.gotronic.fr/art-fiche-banane-1010r-179.htm | 1 | 0.96 € | 1.15 € | 1.15 €
EDMUND |  |  |  |  |  |  |  |  | 0.00 €
Edmund Optics | Vidéo | Objectif caméra (solution 1) | Objectif à Distance Focale Fixe Série UC 4 mm |  | http://edmundoptics.fr/p/4mm-uc-series-fixed-focal-length-lens/2966/ | 1 |  | 260.00 € | 260.00 €
 |  |  |  |  |  |  |  |  | 0.00 €
DIGIKEY |  |  |  |  |  |  |  |  | 0.00 €
Digikey | Electronique | Carte micro SD 256 GB | Sahasra Electronic Solutions Limited CA227-011 | 5093-CA227-011-ND | https://www.digikey.fr/fr/products/detail/sahasra-electronic-solutions-limited/CA227-011/22532602 | 1 | 67.79 € | 81.34 € | 81.34 €
 |  |  |  |  |  |  |  |  | 0.00 €
AMAZON |  |  |  |  |  |  |  |  | 0.00 €
Amazon | Consommables + outil | Cosses + pince à sertir | Pince à Sertir,Pinces à Sertir à Cliquet a 0.5-10mm², Pince à Cosse de Câblevec Electrique 1250pcs AWG22-8 Outil de Sertissage de Ferrule pour soudage électrique ou les industries électriques |  | https://www.amazon.fr/Electrique-Sertissage-%C3%A9lectrique-industries-%C3%A9lectriques/dp/B0DPHPJDDP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 | 1 |  | 15.99 € | 15.99 €
Amazon | Batterie | Convertisseur 5V | Convertisseurs SUPERNIGHT Power Supply Transformer DC DC Step Down Voltage Reducer 12V~24V vers 5V 5A 25W dc Buck Converter Adjustable pour LED displays, Automotive, Electricity ect. |  | https://www.amazon.fr/Supernight-Convertisseurs-Transformer-Adjustable-Electricity/dp/B079M9CHV9 | 1 |  | 17.38 € | 17.38 €
Amazon | Consommables | Bande de nickel | Plaque Nickel Bande Ruban 0,15 x 8 mm Bande de Nickel pour batterie 18650 Spot Soudure Compatible pour Spot Soudeur Mach |  | https://www.amazon.fr/Plaque-batterie-Soudure-Compatible-Soudeur/dp/B09TT4KMLB | 1 |  | 9.99 € | 9.99 €
Amazon | Consommables | Ruban ESD | MMOBIEL Ruban Adhésif (20mm x 30m) - Ruban Polyimide Résistant à la Chaleur pour Sublimation Ruban de Pressage Thermique à Haute Température ESD pour HVAC Electronique Soudure Impression 3D etc. |  | https://www.amazon.fr/MMOBIEL-Polyimide-longueur-Antistatique-R%C3%A9sistant/dp/B07W4KWKKB | 1 |  | 14.99 € | 14.99 €
Amazon | Consommables | Kit supports Raspberry Pi HAT | Geekworm Outil d'Installation pour Raspberry Pi - 100 pcs M2.5 Hex Brass Spacer/Standoff + Écrou + Vis - Accessoires pour Raspberry Pi 5/4/3 B+/3B/3A+/Zero W |  | https://www.amazon.fr/Geekworm-Raspberry-Installation-Hexagonale-Accessoires/dp/B07MN2GY6Y | 1 |  | 11.89 € | 11.89 €
Amazon | Outil | Soudeuse par points | Soudeur par Points Réglable pour Batteries 8000W, Soudeuse à Point Portable 0,1-0,3mm avec Double Sortie D'impulsion 1-9 Vitesses Réglable par Pédale pour Fabrication de Packs de Batteries |  | https://www.amazon.fr/Neulriscn-R%C3%A9glable-Batteries-Dimpulsion-Fabrication/dp/B0DNQHWD2Q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 | 1 |  | 58.99 € | 58.99 €
Amazon | Caméra | Vis caméra (solution 1) | 2 Vis 1/4" en Acier Inoxydable avec Anneau D pour Trépied, Monopode et Plaque Rapide, Compatible Appareil Photo DSLR, Kodak, SmallRig, Manfrotto – Vis de Montage Caméra Professionnelle |  | https://www.amazon.fr/EUYKQNOI-Inoxydable-Monopode-Compatible-Manfrotto/dp/B0F6Y4L5RC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 | 1 |  | 6.99 € | 6.99 €
Amazon | Pieuvre | Connecteurs XT30 | YIXISI 15 Paires XT30 Batterie Connecteur, XT30 Connecteur mâle et Femelle, avec Thermorétractable Tube, pour RC Lipo Battery |  | https://www.amazon.fr/YIXISI-Batterie-Connecteur-Femelle-Thermor%C3%A9tractable/dp/B0CF898DV3 | 1 |  | 8.99 € | 8.99 €
 |  |  |  |  |  |  |  |  | 0.00 €
CONRAD |  |  |  |  |  |  |  |  | 0.00 €
Conrad | Batterie | Cellules 18650 3450 mAh | Pile rechargeable spéciale 18650 Samsung S9009316342928 résiste aux courants élevés, à tête plate Li-Ion 3.6 V 3450 mAh |  | https://www.conrad.fr/fr/p/pile-rechargeable-speciale-18650-samsung-s9009316342928-resiste-aux-courants-eleves-a-tete-plate-li-ion-3-6-v-3450-mah-1499572.html | 9 | 7.08 € | 8.50 € | 76.46 €
 |  |  |  |  |  |  |  |  | 0.00 €
Otronic |  |  |  |  |  |  |  |  | 0.00 €
Otronic | Batterie | BMS 3S | Circuit de protection BMS 3S avec fonction d'équilibrage (OT3568) |  | https://www.otronic.nl/fr/circuit-de-protection-bms-3s-avec-fonction-dequili.html | 1 |  | 2.05 € | 2.05 €
 |  |  |  |  |  |  |  |  | 0.00 €
