ofauvarque/DocV4/CommonElements/doc/pictures/01_Batterie/components_overview.jpg

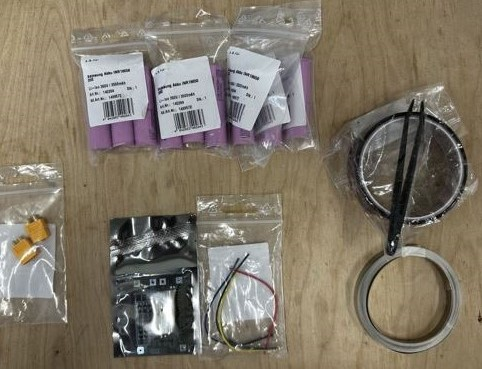
CommonElements/doc/pictures/01_Batterie/components_overview.jpg
