ofauvarque/DocV4/MagpiSystem/doc/pictures/01_Sourcing/Image1.png

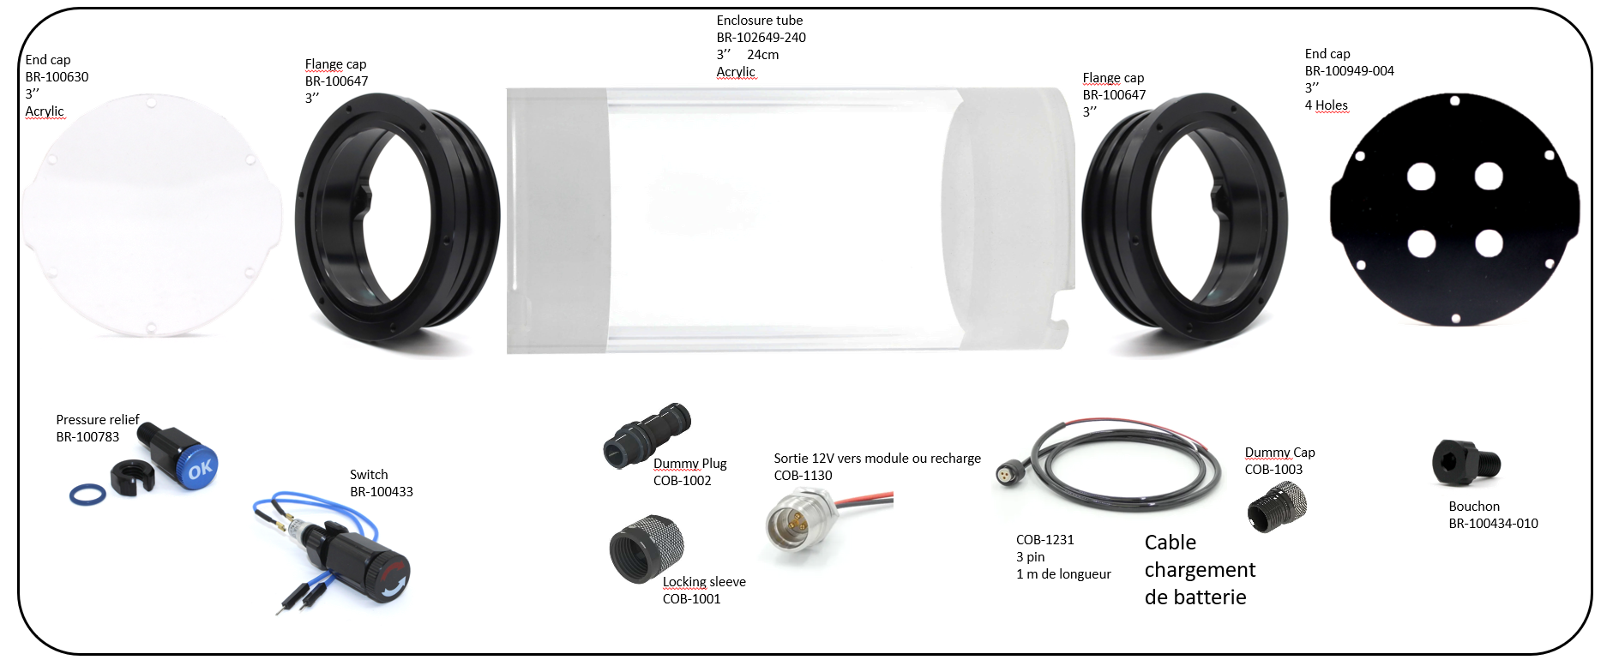
MagpiSystem/doc/pictures/01_Sourcing/Image1.png
