ofauvarque/DocV4/MagpiSystem/doc/pictures/01_Sourcing/Nomenclature_MagPI.PNG

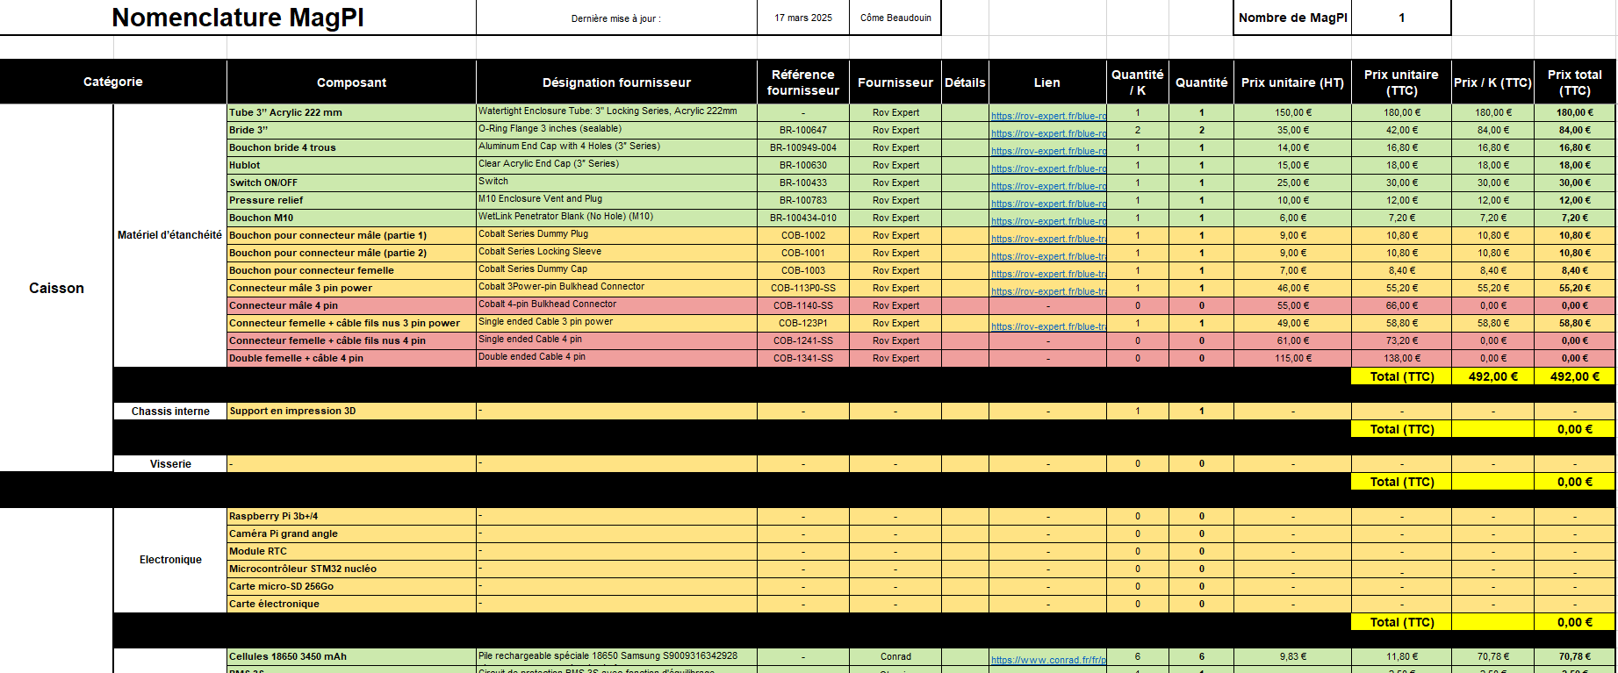
MagpiSystem/doc/pictures/01_Sourcing/Nomenclature_MagPI.PNG
