ofauvarque/DocV4/CommonElements/hardware/3Dprint_files/support_caisson_3pouces.STL

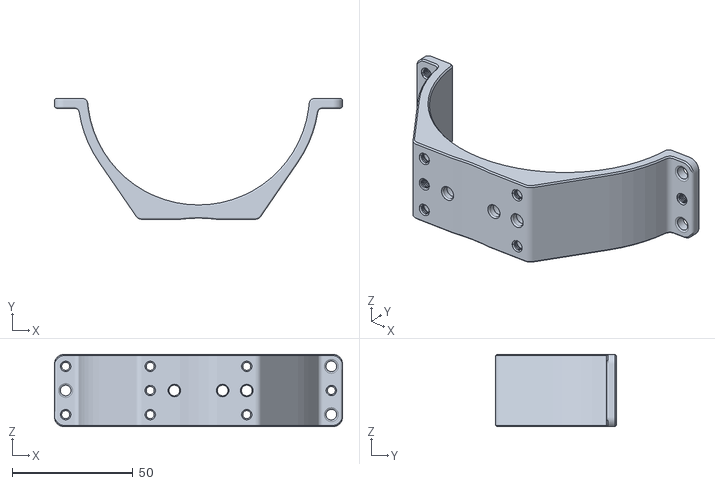
[picture p266: CAD file, 2025-01-27]
CommonElements/hardware/3Dprint_files/support_caisson_3pouces.STL
119.4 x 50.0 x 30.0
