ofauvarque/DocV4/KosmosV4System/hardware/3Dprint_files/V4_CaissonBatterie/Structure_batterie.step

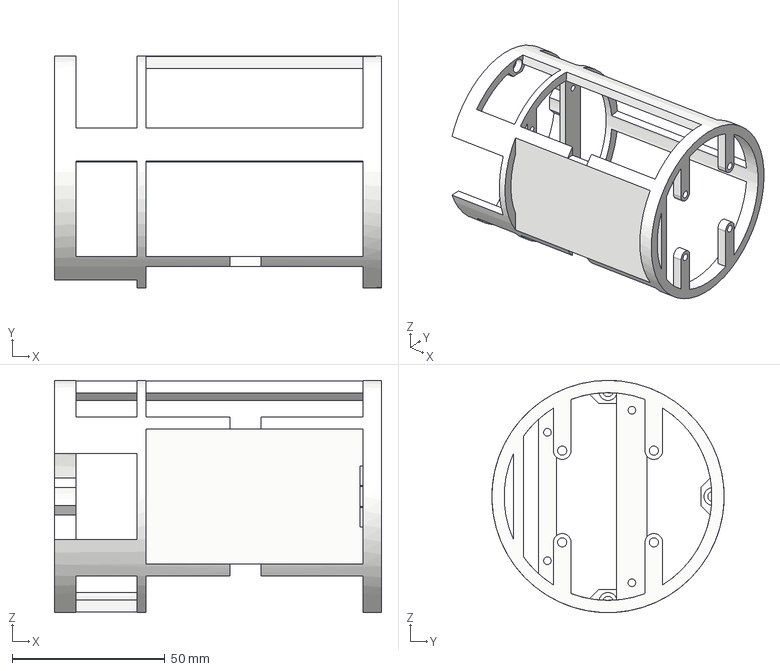
[picture p267: CAD file, 2025-10-03]
KosmosV4System/hardware/3Dprint_files/V4_CaissonBatterie/Structure_batterie.step
107.0 x 76.0 x 76.0 mm
