ofauvarque/DocV4/KosmosV4System/hardware/3Dprint_files/V4_CaissonMoteur/Roue_dentee_KOSMOS4.0.stl

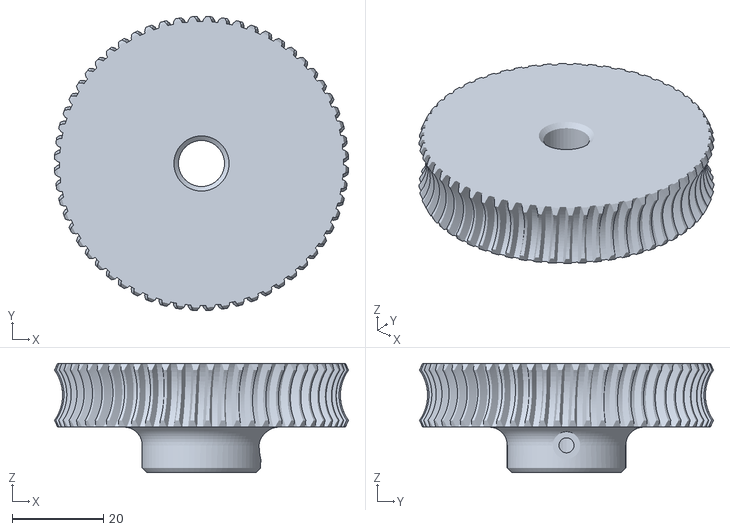
[picture p268: CAD file, 2025-01-27]
KosmosV4System/hardware/3Dprint_files/V4_CaissonMoteur/Roue_dentee_KOSMOS4.0.stl
64.5 x 64.5 x 24.0
