ofauvarque/DocV4/KosmosV4System/hardware/3Dprint_files/V4_CaissonPrincipal/Structure_video.step

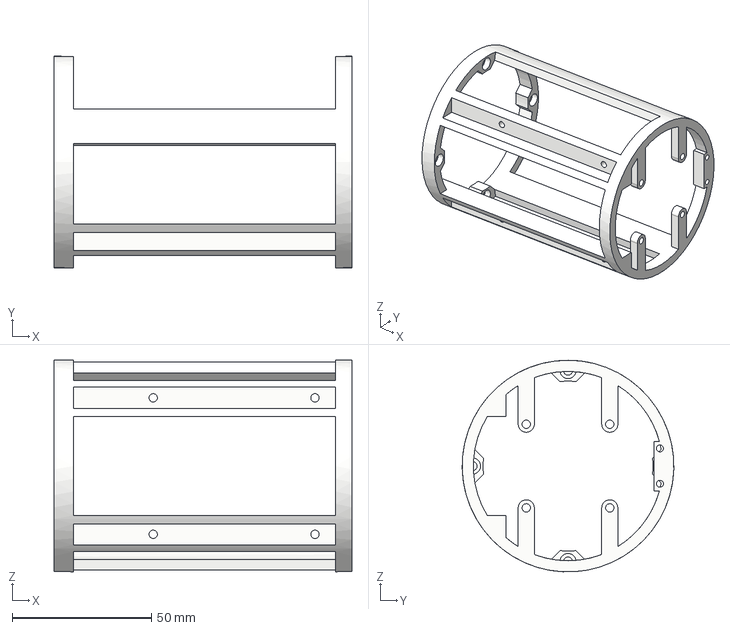
[picture p269: CAD file, 2026-01-09]
KosmosV4System/hardware/3Dprint_files/V4_CaissonPrincipal/Structure_video.step
107.0 x 76.0 x 75.9 mm
