ofauvarque/DocV4/KosmosV4System/hardware/3Dprint_files/V4_SystemeComplet/double_berceau.stl

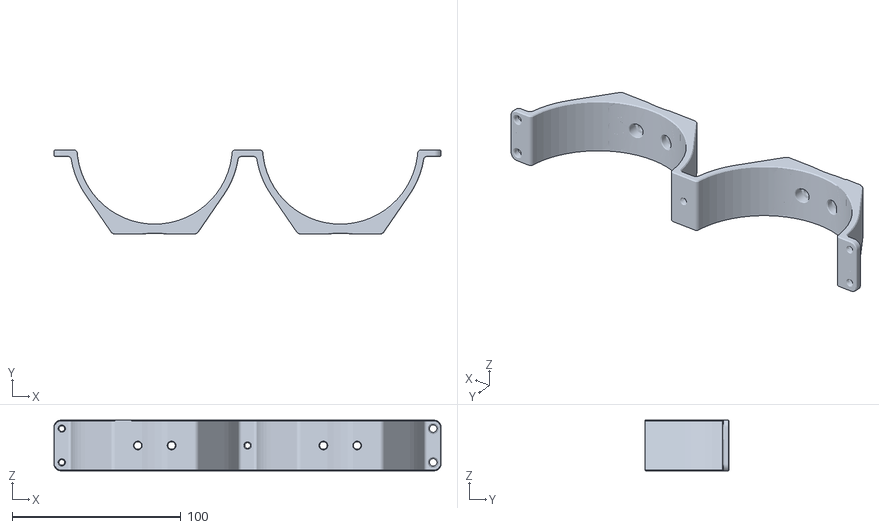
[picture p270: CAD file, 2025-09-17]
KosmosV4System/hardware/3Dprint_files/V4_SystemeComplet/double_berceau.stl
229.4 x 50.0 x 30.0
