ofauvarque/DocV4/KosmosV4System/hardware/Trépied/Pièces/Tube vertical.stp

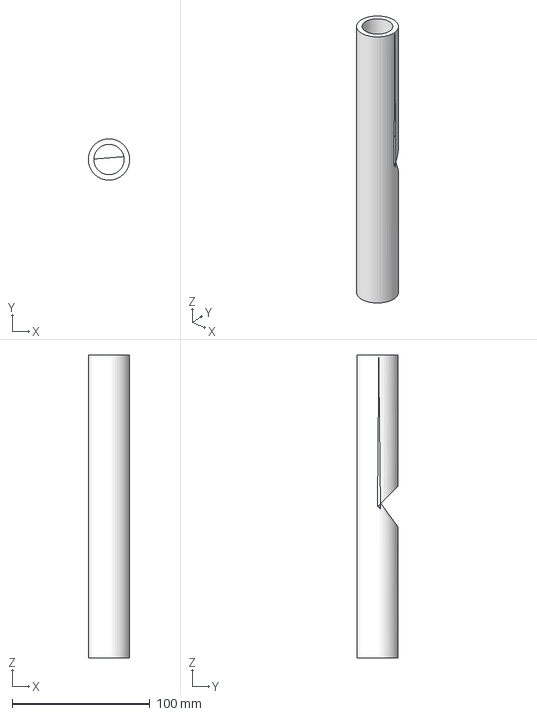
[picture p271: CAD file, 2025-03-12]
KosmosV4System/hardware/Trépied/Pièces/Tube vertical.stp
30.0 x 30.0 x 220.0 mm
