ofauvarque/DocV4/KosmosV4System/hardware/Trépied/Trépied.stp

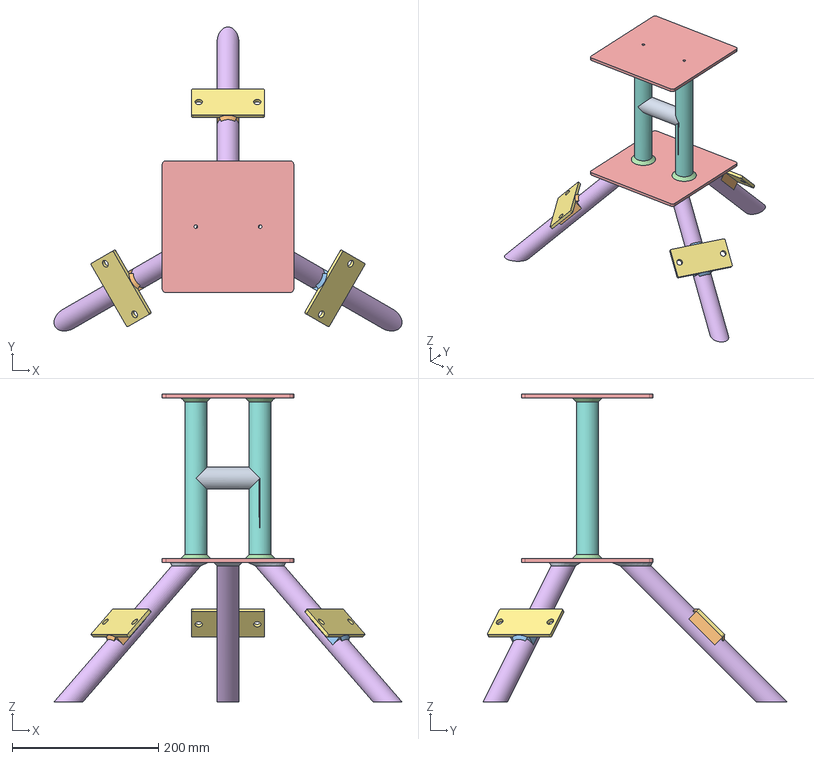
[picture p272: CAD file, 2025-03-12]
KosmosV4System/hardware/Trépied/Trépied.stp
476.0 x 415.9 x 420.9 mm
Trépied_1
Plaque inférieure x 2
Pied x 3
Plaque fixation x 3
Tube vertical x 2
Tube horizontale
