ofauvarque/DocV4/MagpiSystem/hardware/3Dprint_files/big_camera.stl

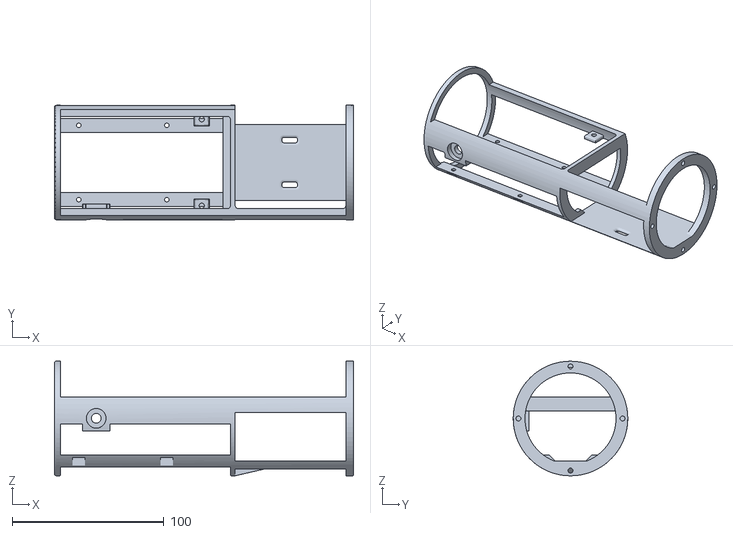
[picture p273: CAD file, 2025-09-16]
MagpiSystem/hardware/3Dprint_files/big_camera.stl
197.0 x 75.5 x 75.5
