ofauvarque/DocV4/MagpiSystem/hardware/3Dprint_files/big_camera_version_multipieces/montant_RPI.SLDPRT

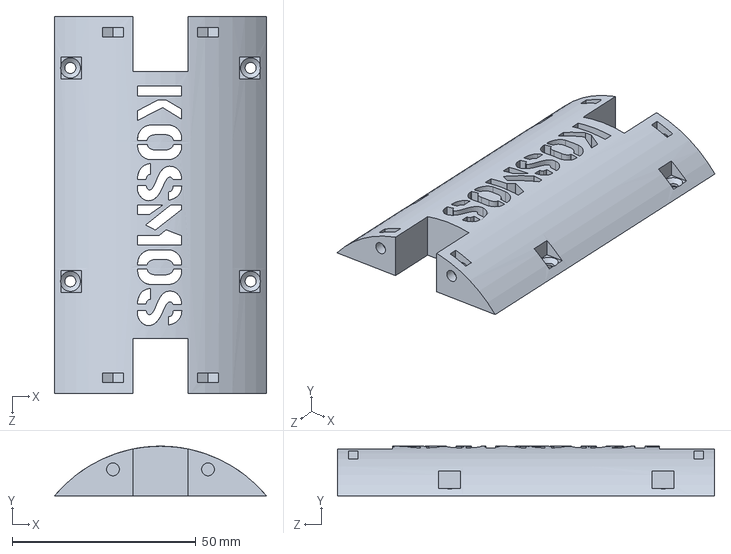
[picture p274: CAD file, 2025-09-15]
MagpiSystem/hardware/3Dprint_files/big_camera_version_multipieces/montant_RPI.SLDPRT
57.6 x 13.5 x 102.5 mm
