ofauvarque/DocV4/MagpiSystem/hardware/3Dprint_files/big_camera_version_multipieces/Nouveau dossier/montant_batterie.SLDPRT

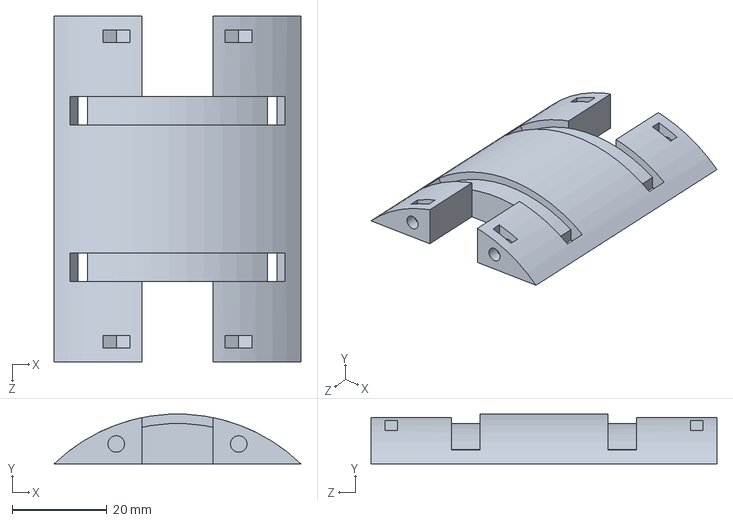
[picture p275: CAD file, 2025-09-29]
MagpiSystem/hardware/3Dprint_files/big_camera_version_multipieces/Nouveau dossier/montant_batterie.SLDPRT
52.0 x 10.5 x 73.0 mm
