ofauvarque/DocV4/KosmosV4System/hardware/3Dprint_files/V4_CaissonMoteur/Vis_sans_fin_KOSMOS4.0.stl

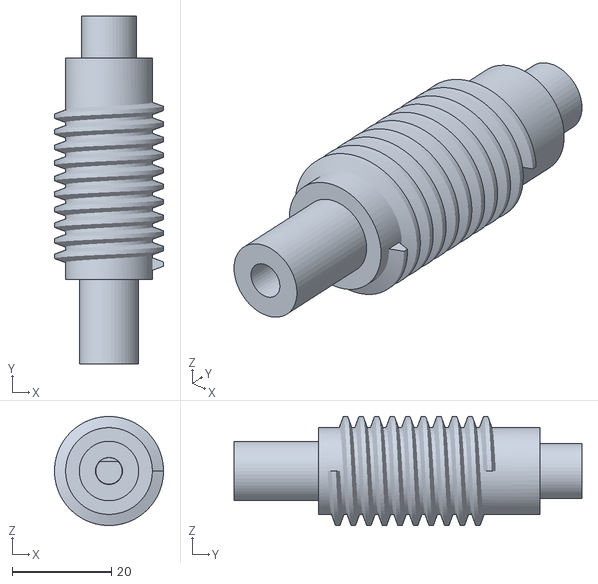
[picture p276: CAD file, 2025-01-27]
KosmosV4System/hardware/3Dprint_files/V4_CaissonMoteur/Vis_sans_fin_KOSMOS4.0.stl
22.0 x 70.2 x 22.0
