ofauvarque/DocV4/KosmosV4System/hardware/3Dprint_files/V4_CaissonPrincipal/Structure_video_mono.stl

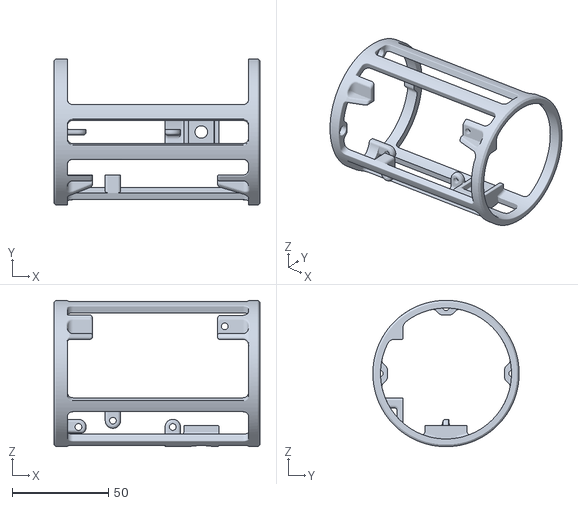
[picture p277: CAD file, 2025-01-27]
KosmosV4System/hardware/3Dprint_files/V4_CaissonPrincipal/Structure_video_mono.stl
107.0 x 76.0 x 76.0
