ofauvarque/DocV4/KosmosV4System/hardware/Trépied/Pièces/Plaque inférieure.stp

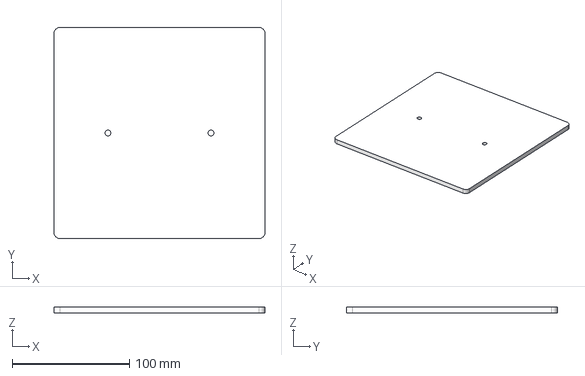
[picture p278: CAD file, 2025-03-12]
KosmosV4System/hardware/Trépied/Pièces/Plaque inférieure.stp
180.0 x 180.0 x 5.00 mm
