ofauvarque/DocV4/MagpiSystem/hardware/3Dprint_files/big_camera_version_multipieces/montant_alim.SLDPRT

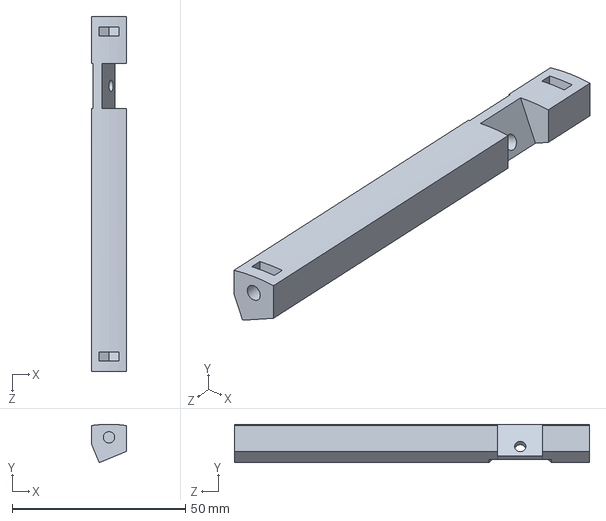
[picture p279: CAD file, 2025-09-15]
MagpiSystem/hardware/3Dprint_files/big_camera_version_multipieces/montant_alim.SLDPRT
10.0 x 11.1 x 102.5 mm
