ofauvarque/DocV4/MagpiSystem/hardware/3Dprint_files/big_camera_version_multipieces/Nouveau dossier/montant_73mm.SLDPRT

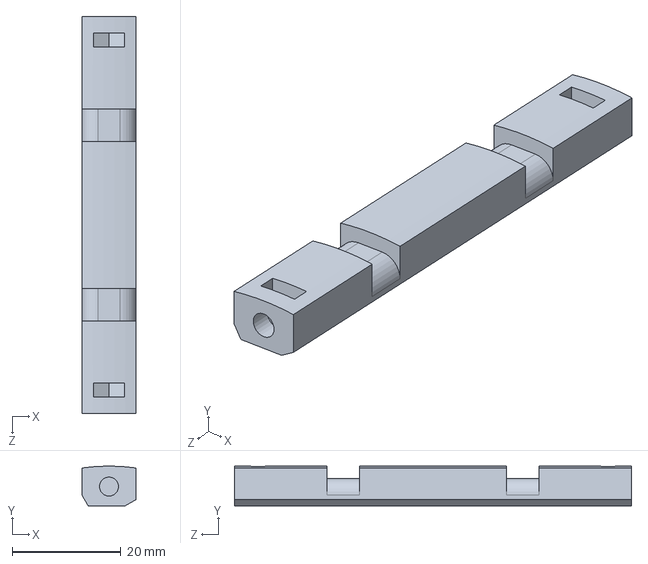
[picture p280: CAD file, 2025-09-29]
MagpiSystem/hardware/3Dprint_files/big_camera_version_multipieces/Nouveau dossier/montant_73mm.SLDPRT
10.0 x 7.27 x 73.0 mm
