ofauvarque/DocV4/MagpiSystem/hardware/3Dprint_files/small_camera.stl

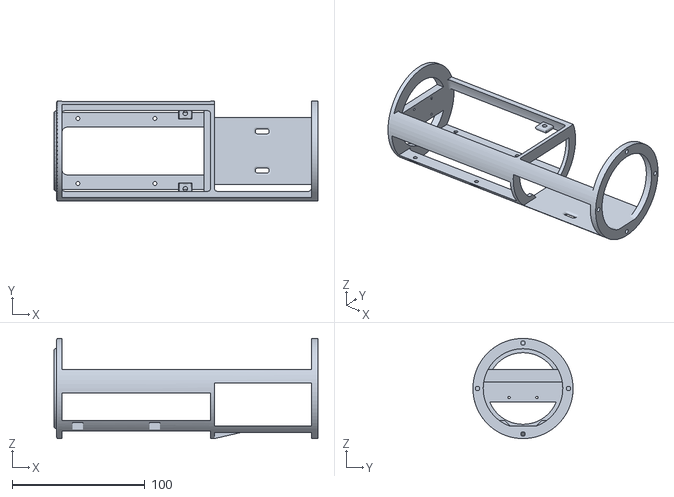
[picture p281: CAD file, 2025-09-16]
MagpiSystem/hardware/3Dprint_files/small_camera.stl
199.0 x 75.5 x 75.5
