ofauvarque/DocV4/KosmosV4System/hardware/Trépied/Pièces/Plaque fixation.stp

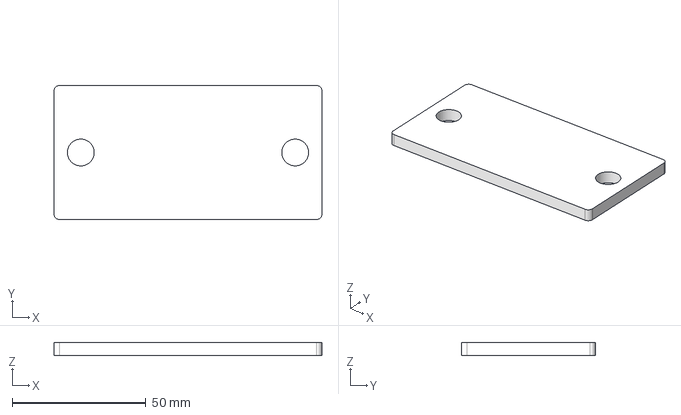
[picture p282: CAD file, 2025-03-12]
KosmosV4System/hardware/Trépied/Pièces/Plaque fixation.stp
100.0 x 50.0 x 5.00 mm
