ofauvarque/DocV4/MagpiSystem/hardware/3Dprint_files/big_camera_version_multipieces/montant_73mm.SLDPRT

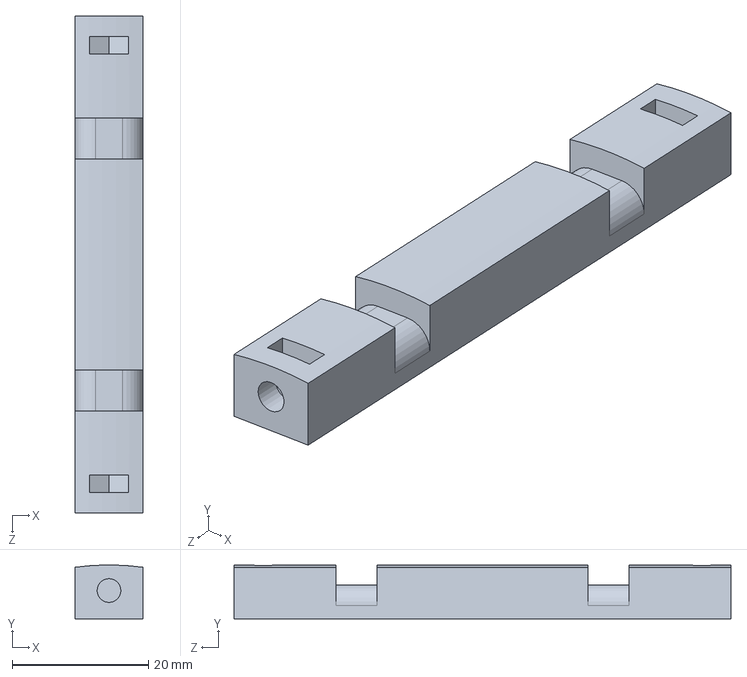
[picture p283: CAD file, 2025-09-15]
MagpiSystem/hardware/3Dprint_files/big_camera_version_multipieces/montant_73mm.SLDPRT
10.0 x 7.91 x 73.0 mm
