ofauvarque/DocV4/MagpiSystem/hardware/3Dprint_files/big_camera_version_multipieces/Nouveau dossier/Pack_batterie.SLDPRT

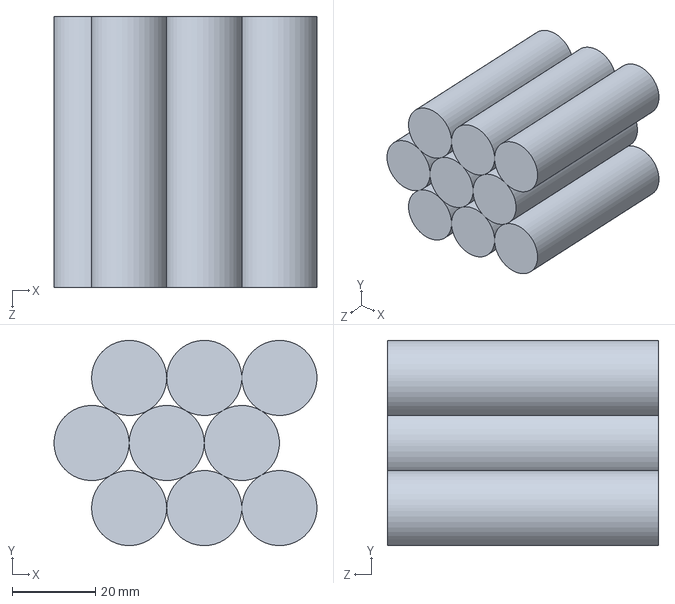
[picture p284: CAD file, 2025-09-29]
MagpiSystem/hardware/3Dprint_files/big_camera_version_multipieces/Nouveau dossier/Pack_batterie.SLDPRT
63.0 x 49.2 x 65.0 mm
