ofauvarque/DocV4/KosmosV4System/hardware/Trépied/Pièces/Pied.stp

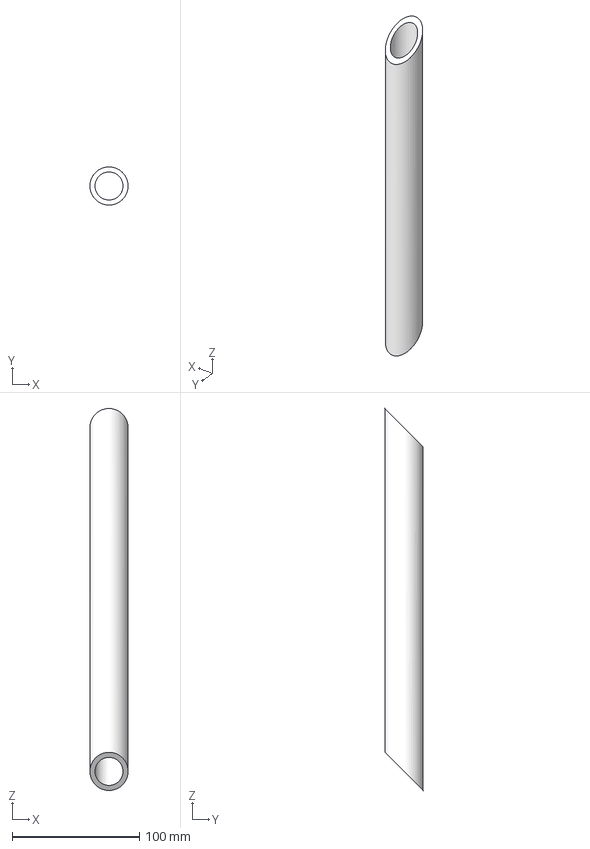
[picture p285: CAD file, 2025-03-12]
KosmosV4System/hardware/Trépied/Pièces/Pied.stp
30.0 x 30.0 x 300.0 mm
