ofauvarque/DocV4/MagpiSystem/hardware/3Dprint_files/big_camera_version_multipieces/Entretoise_RPI.SLDPRT

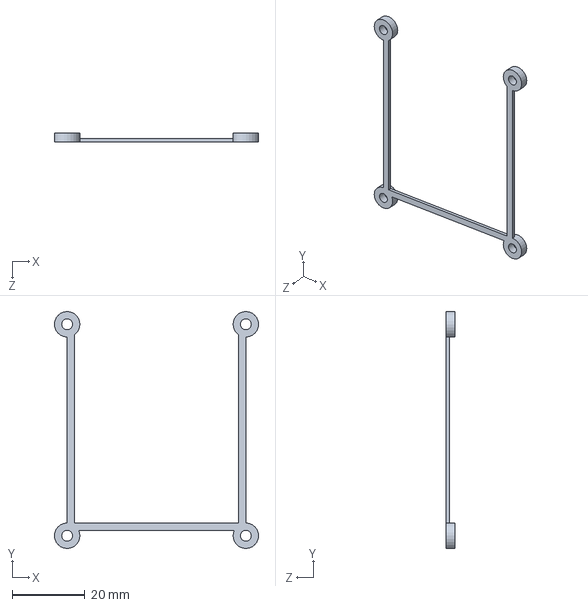
[picture p286: CAD file, 2025-09-15]
MagpiSystem/hardware/3Dprint_files/big_camera_version_multipieces/Entretoise_RPI.SLDPRT
56.0 x 65.0 x 2.50 mm
