ofauvarque/DocV4/KosmosV4System/hardware/Trépied/Pièces/Tube horizontale.stp

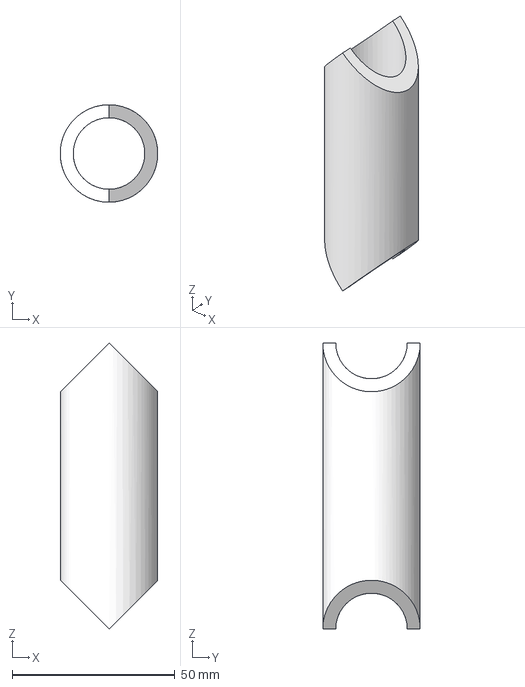
[picture p287: CAD file, 2025-03-12]
KosmosV4System/hardware/Trépied/Pièces/Tube horizontale.stp
30.0 x 30.0 x 88.0 mm
