ofauvarque/DocV4/MagpiSystem/hardware/3Dprint_files/big_camera_version_multipieces/Module_DC_DC.SLDPRT

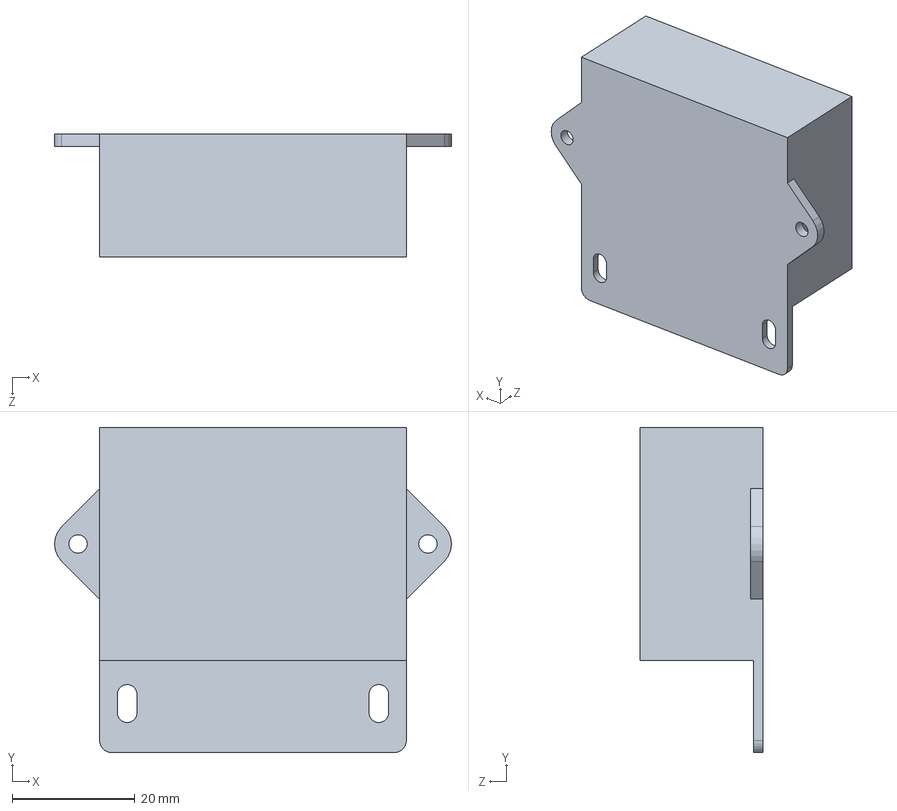
[picture p288: CAD file, 2025-09-15]
MagpiSystem/hardware/3Dprint_files/big_camera_version_multipieces/Module_DC_DC.SLDPRT
64.7 x 53.0 x 20.0 mm
