ofauvarque/DocV4/MagpiSystem/hardware/3Dprint_files/big_camera_version_multipieces/montant_camera.SLDPRT

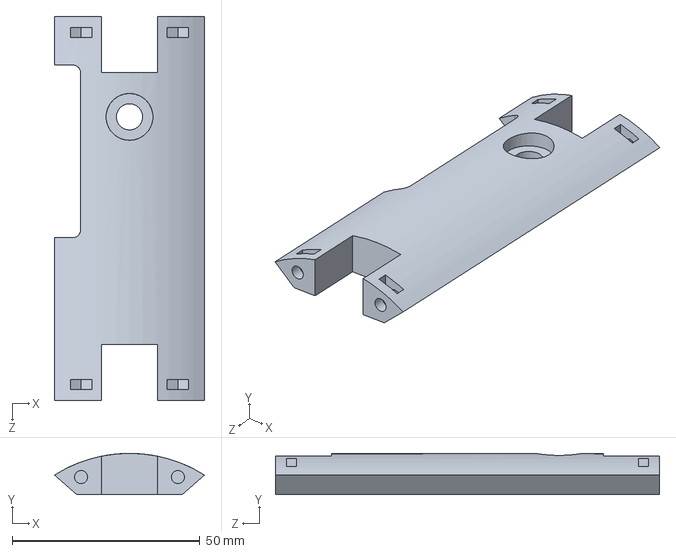
[picture p289: CAD file, 2025-09-15]
MagpiSystem/hardware/3Dprint_files/big_camera_version_multipieces/montant_camera.SLDPRT
40.0 x 11.0 x 102.5 mm
