ofauvarque/DocV4/MagpiSystem/hardware/3Dprint_files/big_camera_version_multipieces/cadre.SLDPRT

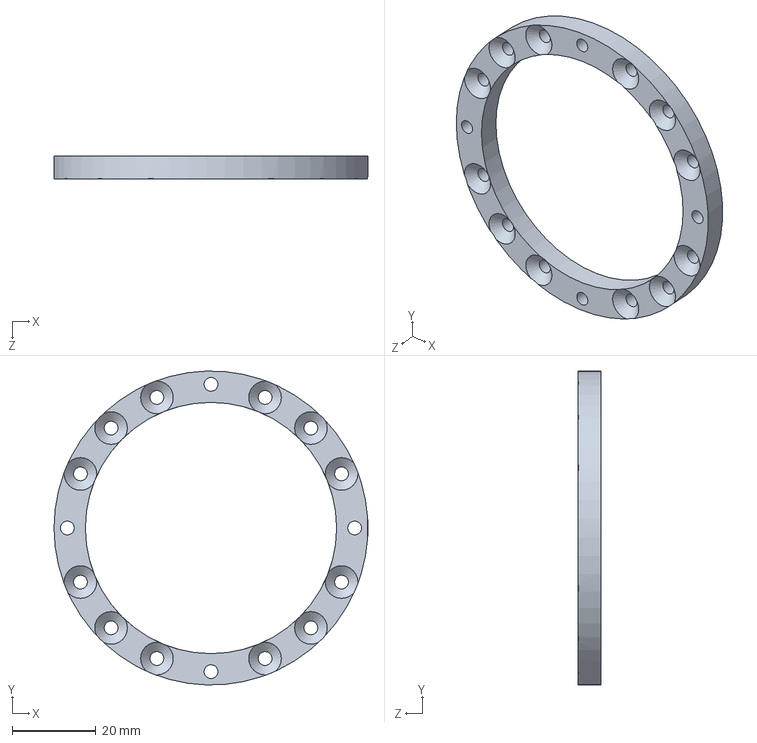
[picture p290: CAD file, 2025-09-15]
MagpiSystem/hardware/3Dprint_files/big_camera_version_multipieces/cadre.SLDPRT
75.0 x 75.0 x 5.50 mm
