ofauvarque/DocV4/(list of files, cad)

Other CAD files:
MagpiSystem/hardware/3Dprint_files/big_camera_version_multipieces/Pack_batterie.SLDPRT
KosmosV4System/hardware/3Dprint_files/V4_CaissonPrincipal/Structure_video.f3d
KosmosV4System/hardware/3Dprint_files/V4_SystemeComplet/double_berceau.f3d
MagpiSystem/hardware/3Dprint_files/big_camera.f3d
MagpiSystem/hardware/3Dprint_files/big_camera_version_multipieces/Entretoise_RPI.STL
MagpiSystem/hardware/3Dprint_files/big_camera_version_multipieces/Nouveau dossier/montant_73mm.STL
MagpiSystem/hardware/3Dprint_files/big_camera_version_multipieces/Nouveau dossier/montant_batterie.STL
MagpiSystem/hardware/3Dprint_files/big_camera_version_multipieces/cadre.STL
MagpiSystem/hardware/3Dprint_files/big_camera_version_multipieces/montant_73mm.STL
MagpiSystem/hardware/3Dprint_files/big_camera_version_multipieces/montant_RPI.STL
MagpiSystem/hardware/3Dprint_files/big_camera_version_multipieces/montant_alim.STL
MagpiSystem/hardware/3Dprint_files/big_camera_version_multipieces/montant_camera.STL
MagpiSystem/hardware/3Dprint_files/small_camera.f3d
