ofauvarque/DocV4/MagpiSystem/doc/05_assemblage.md

# **Assemblage du système**

Cette partie comprend le montage de la partie hermétique puis l'installation de tous les composants au sein de cette dernière.

## Vue d'ensemble

|Caisson|
|:--:|
|*Assemblage final du caisson*|
---

### **Éléments nécessaires**

#### **Outils**

Outils

- **Clé de 17 et Clé WetLink M10**
- **Clé allen, tournevis plat/cruciforme**
- **O-ring pick**

---

### Caisson hermétique

#### Composants

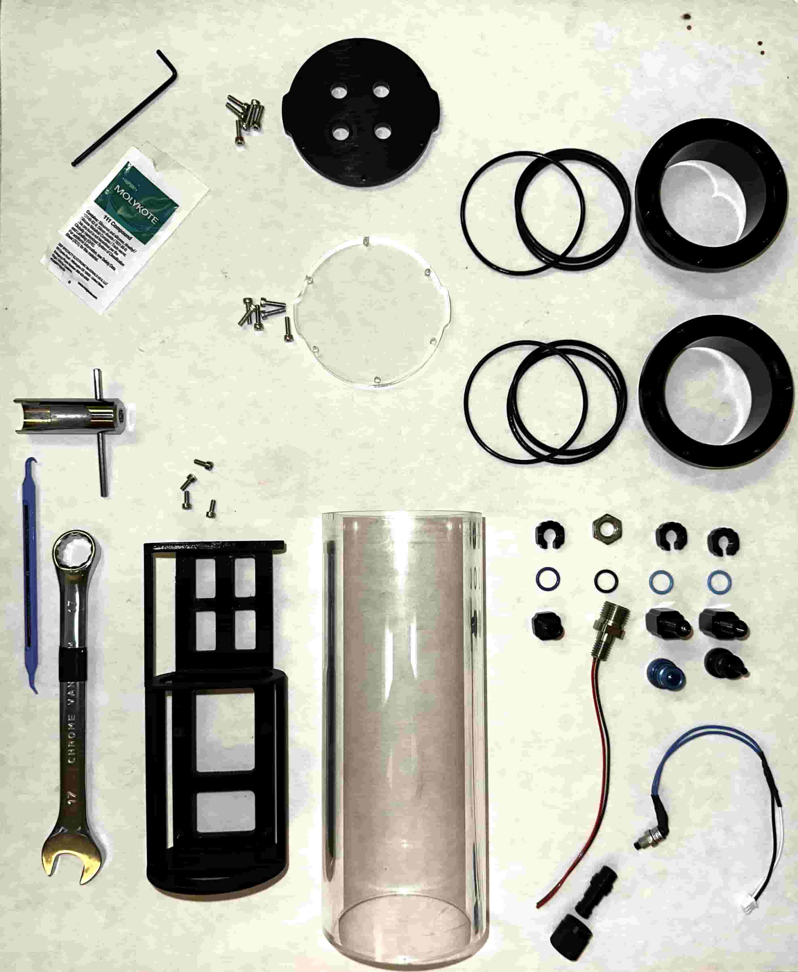
[picture p291: MagpiSystem/doc/pictures/05_Assemblage/assemblage_overview.jpg]
Composant hermétique


---

On installe d'abord le switch, port de charge, vis de purge et bouchon sur le côté en aluminium.

Côté aluminium Côté aluminium

Le constructeur des composants hermétique propose un tutoriel expliquant l'assemblage des bouchons du caisson avec graissage des joints : **[ici](https://youtu.be/G6PqEsKjxHM)**.

On obtient donc nos deux flanges finies.

Hublot

---

### Assemblage des composants

Composants système

- **Batterie**
- **Connecteur pieuvre**
- **Raspberry Pi**
- **Convertisseur 12V-5V**
- **Camera et sa nappe**
- **Câbles d'alimentation du Raspberry**
- **Partie hermétique**
- **Support 3D**

#### Convertisseur

Convertisseur

Le convertisseur est fixé sur ses supports.

#### Raspberry Pi

Raspberry

La carte Raspberry Pi est fixée, la nappe de la caméra est installée au préalable pour plus de facilité.

#### Batterie

Batterie

La batterie est installé et fixé avec un serre flex, qui passe dans les encoches du support. Les câbles de la batterie passent sous la carte raspberry. Les câbles de charge et du switch sont aussi coincé par le serre flex et passent eux aussi sous la carte.

#### Câblage

Câblage

La pieuvre est connectée aux différents éléments, en respectant bien le schéma de câblage.

#### Alimentation Raspberry

Alim convertisseur

Les câbles de la pieuvre sont connectés au convertisseur, les câbles d'alimentation de la rapsberry sont branchés sur les pin 1 et 3 de la carte.

#### Caméra

Alim convertisseur

La nappe de la caméra est branchée.

---

Ainsi notre système est assemblé et prêt à être testé.

Alim convertisseur
