ofauvarque/DocV4/CommonElements/doc/pictures/01_Batterie/four_cables_soldered_on_bms.jpg

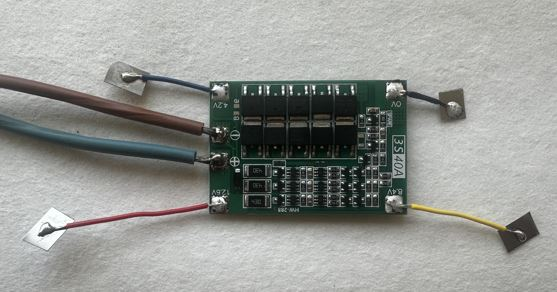
CommonElements/doc/pictures/01_Batterie/four_cables_soldered_on_bms.jpg
