ofauvarque/DocV4/CommonElements/doc/pictures/01_Batterie/four_cables_soldered_on_nickel_right_length.jpg

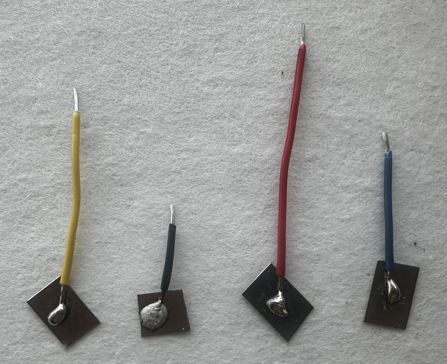
CommonElements/doc/pictures/01_Batterie/four_cables_soldered_on_nickel_right_length.jpg
