ofauvarque/DocV4/CommonElements/doc/pictures/01_Batterie/lithium_acu_before_soldering.jpg

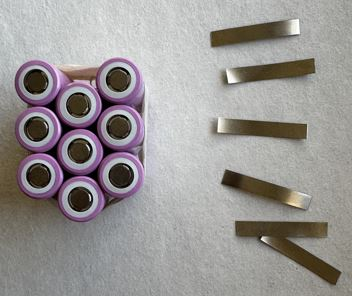
CommonElements/doc/pictures/01_Batterie/lithium_acu_before_soldering.jpg
