ofauvarque/DocV4/CommonElements/doc/pictures/01_Batterie/lithium_acu_nickel_plate_soldered.jpg

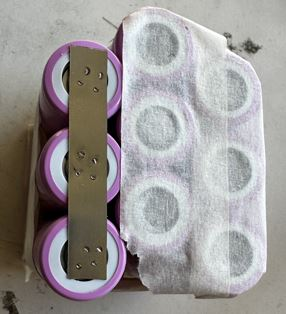
CommonElements/doc/pictures/01_Batterie/lithium_acu_nickel_plate_soldered.jpg
