ofauvarque/DocV4/CommonElements/doc/pictures/01_Batterie/lithium_acu_nickel_plates_soldered.jpg

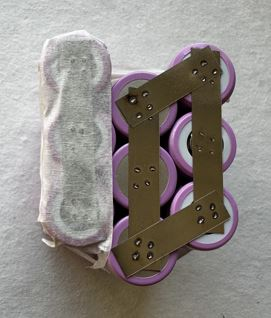
CommonElements/doc/pictures/01_Batterie/lithium_acu_nickel_plates_soldered.jpg
