ofauvarque/DocV4/CommonElements/doc/pictures/01_Batterie/lithium_acu_soldered_with_four_nickel_plates.jpg

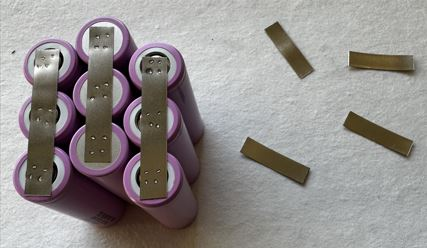
CommonElements/doc/pictures/01_Batterie/lithium_acu_soldered_with_four_nickel_plates.jpg
