ofauvarque/DocV4/CommonElements/doc/pictures/01_Batterie/lithium_acu_soldering_equipment.jpg

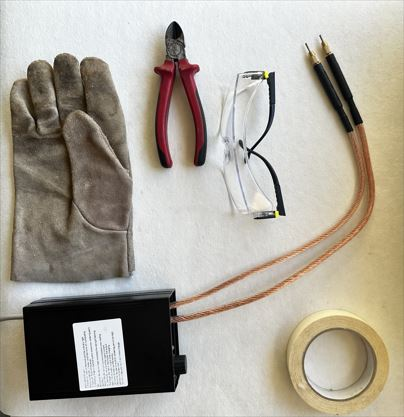
CommonElements/doc/pictures/01_Batterie/lithium_acu_soldering_equipment.jpg
