ofauvarque/DocV4/CommonElements/doc/pictures/01_Batterie/red_blue_soldered_on_battery.jpg

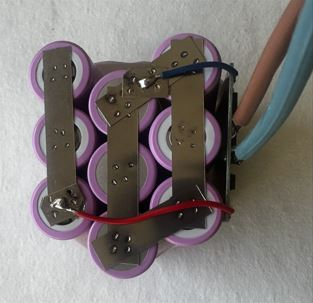
CommonElements/doc/pictures/01_Batterie/red_blue_soldered_on_battery.jpg
