ofauvarque/DocV4/CommonElements/doc/pictures/01_Batterie/xt30_soldered.jpg

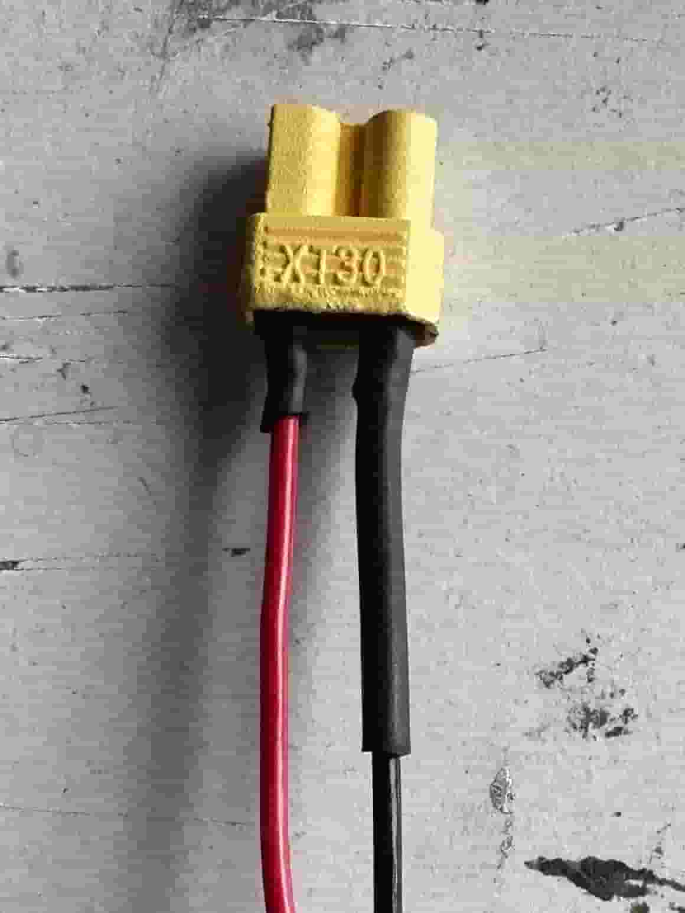
CommonElements/doc/pictures/01_Batterie/xt30_soldered.jpg
