ofauvarque/DocV4/CommonElements/doc/pictures/01_Batterie/yellow_black_soldered_on_battery.jpg

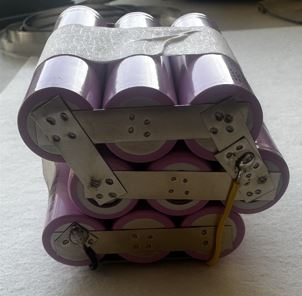
CommonElements/doc/pictures/01_Batterie/yellow_black_soldered_on_battery.jpg
