ofauvarque/DocV4/MagpiSystem/doc/pictures/03_Logiciel/build.PNG

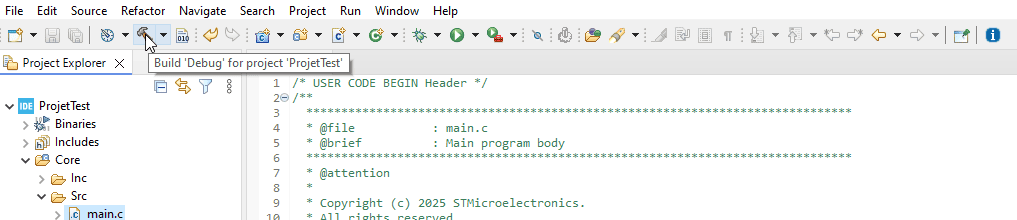
MagpiSystem/doc/pictures/03_Logiciel/build.PNG
