ofauvarque/DocV4/MagpiSystem/doc/pictures/03_Logiciel/installer_window.PNG

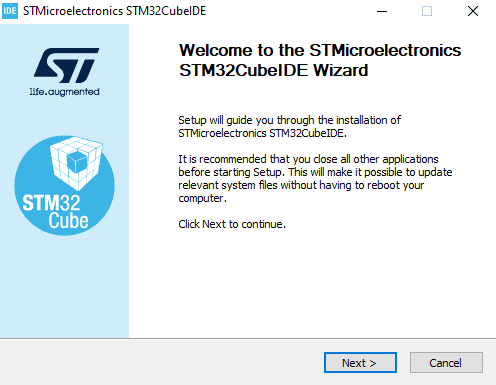
MagpiSystem/doc/pictures/03_Logiciel/installer_window.PNG
