ofauvarque/DocV4/MagpiSystem/doc/pictures/05_Assemblage/image001.png

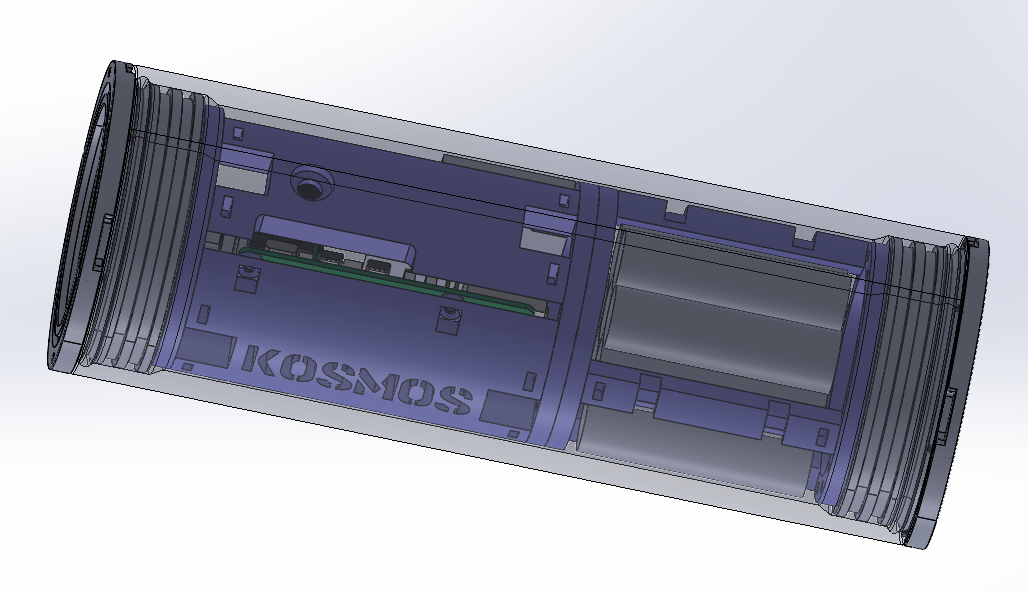
MagpiSystem/doc/pictures/05_Assemblage/image001.png
