ofauvarque/DocV4/MagpiSystem/doc/pictures/05_Assemblage/image002.png

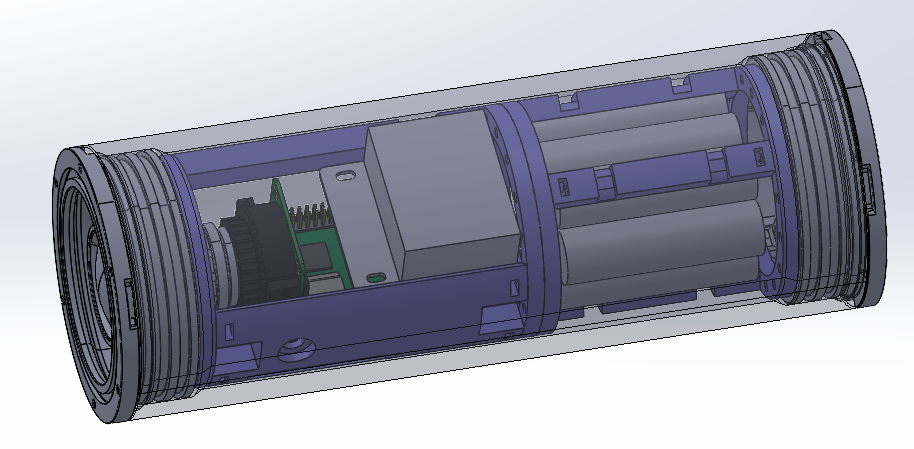
MagpiSystem/doc/pictures/05_Assemblage/image002.png
