ofauvarque/DocV4/MagpiSystem/doc/pictures/05_Assemblage/image004.jpg

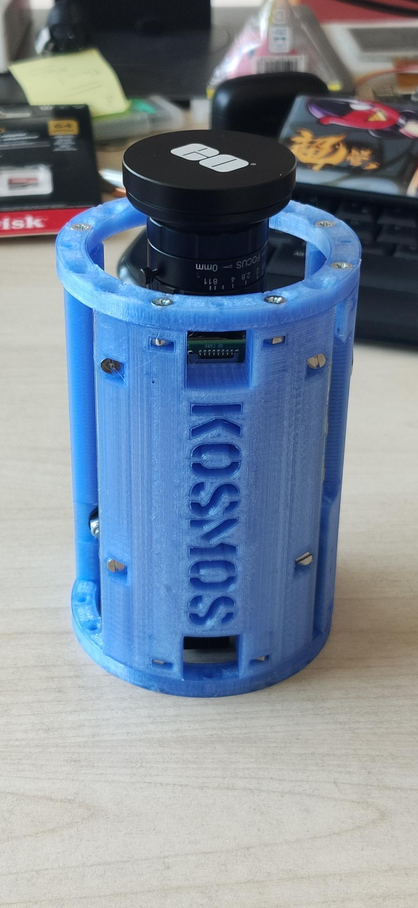
MagpiSystem/doc/pictures/05_Assemblage/image004.jpg
