ofauvarque/DocV4/MagpiSystem/doc/pictures/05_Assemblage/image005.jpg

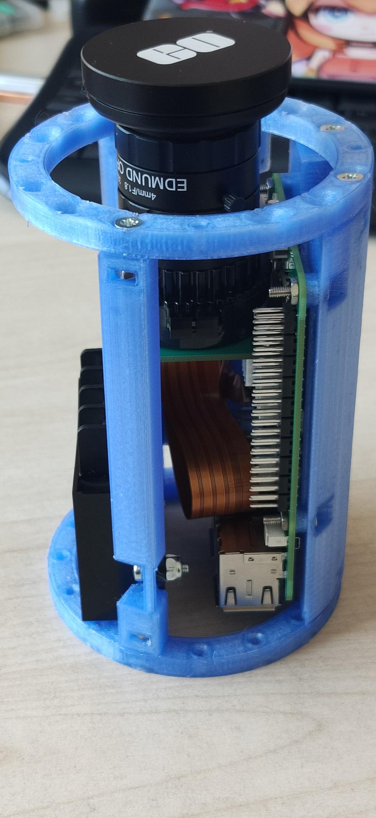
MagpiSystem/doc/pictures/05_Assemblage/image005.jpg
