ofauvarque/DocV4/MagpiSystem/doc/pictures/05_Assemblage/image006.jpg

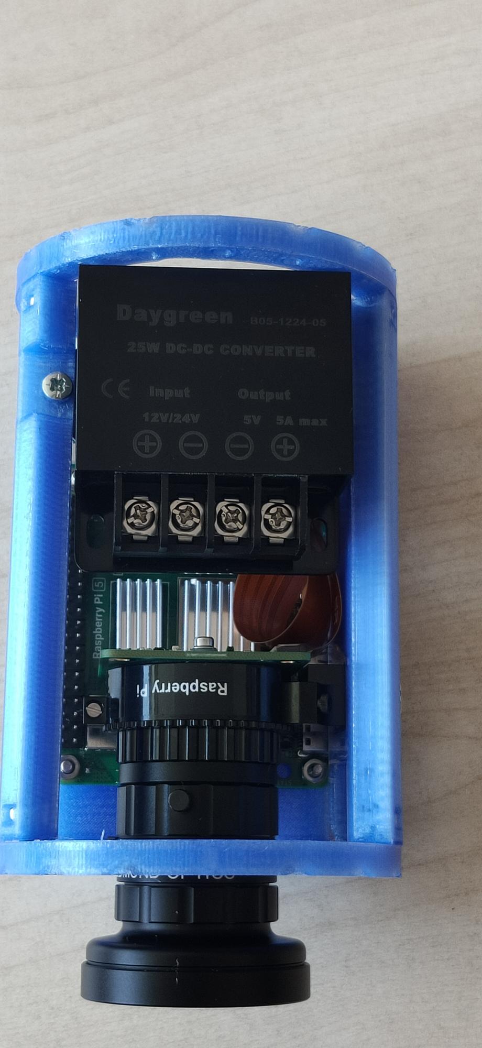
MagpiSystem/doc/pictures/05_Assemblage/image006.jpg
