ofauvarque/DocV4/MagpiSystem/doc/pictures/05_Assemblage/image007.jpg

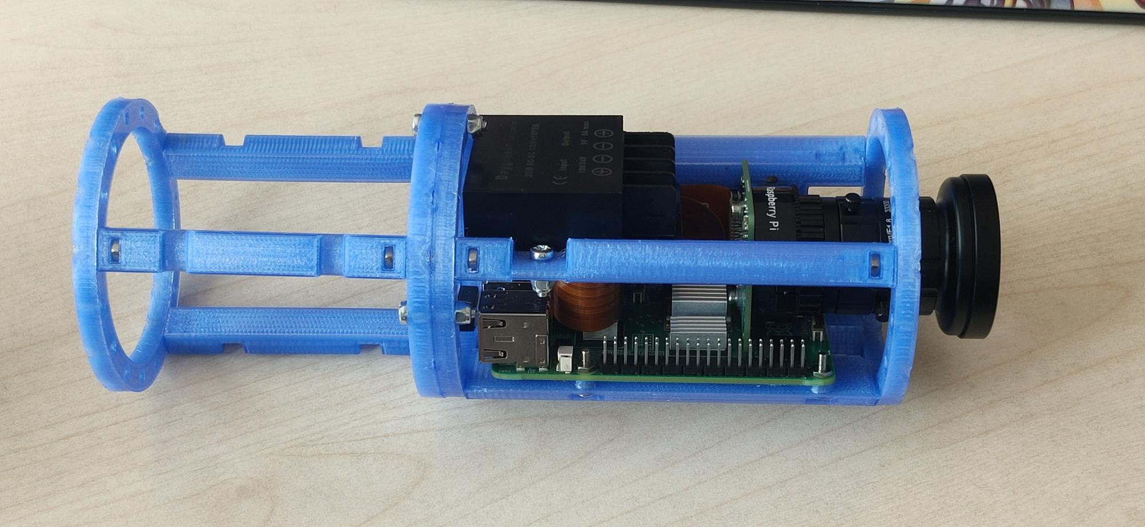
MagpiSystem/doc/pictures/05_Assemblage/image007.jpg
