ofauvarque/DocV4/MagpiSystem/doc/pictures/05_Assemblage/image008.jpg

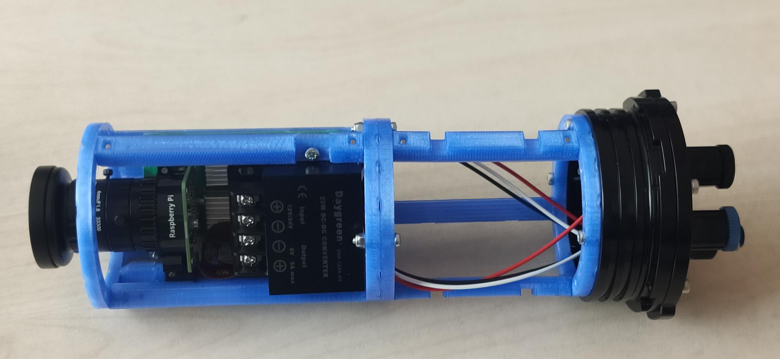
MagpiSystem/doc/pictures/05_Assemblage/image008.jpg
