ofauvarque/DocV4/MagpiSystem/doc/pictures/05_Assemblage/image009.jpg

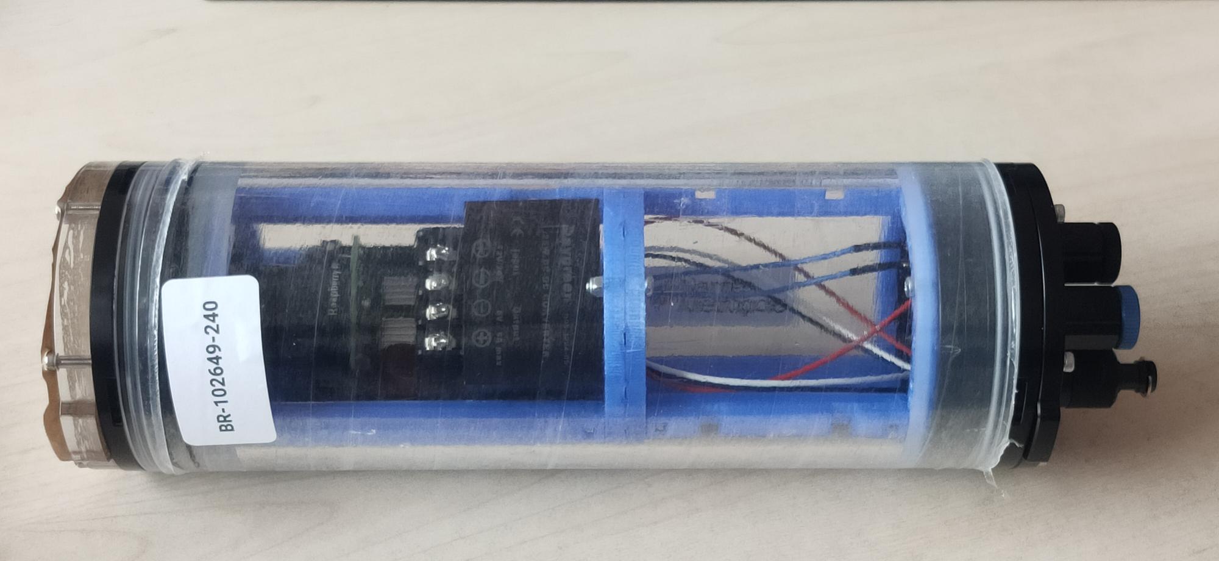
MagpiSystem/doc/pictures/05_Assemblage/image009.jpg
