ofauvarque/DocV4/MagpiSystem/doc/pictures/05_Assemblage/IMG_0686.JPG

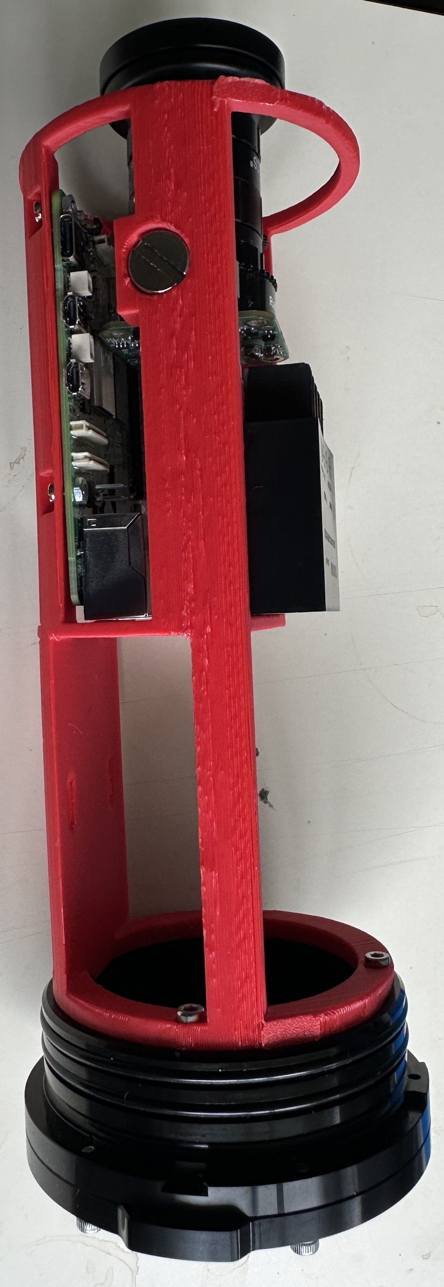
MagpiSystem/doc/pictures/05_Assemblage/IMG_0686.JPG
