ofauvarque/DocV4/MagpiSystem/doc/pictures/05_Assemblage/PhotoAlexandre/image015.png

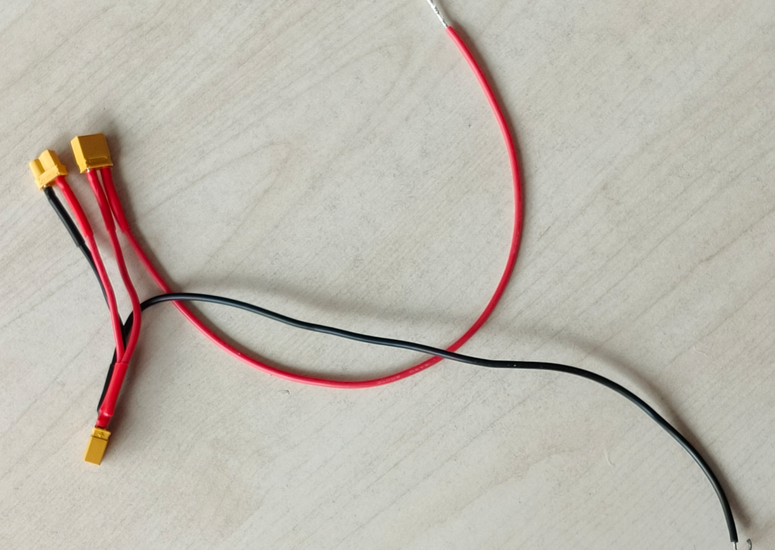
MagpiSystem/doc/pictures/05_Assemblage/PhotoAlexandre/image015.png
