ofauvarque/DocV4/MagpiSystem/doc/pictures/05_Assemblage/PhotoAlexandre/image018.png

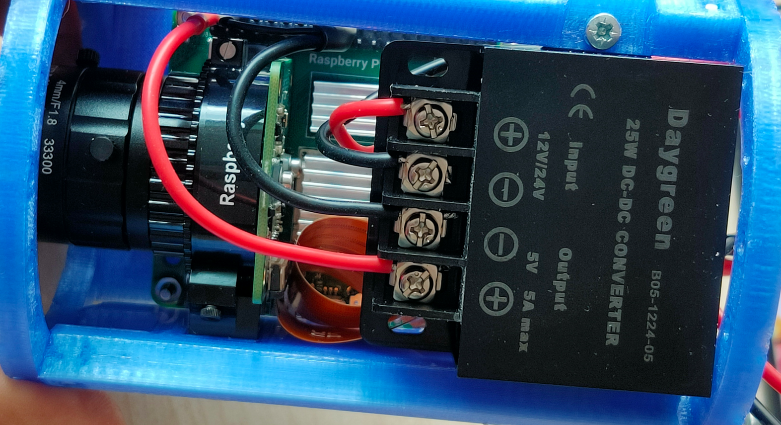
MagpiSystem/doc/pictures/05_Assemblage/PhotoAlexandre/image018.png
