ofauvarque/DocV4/MagpiSystem/doc/pictures/05_Assemblage/PhotoAlexandre/image021.png

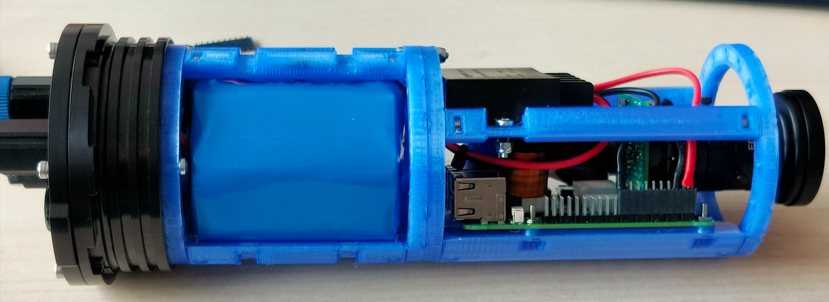
MagpiSystem/doc/pictures/05_Assemblage/PhotoAlexandre/image021.png
