ofauvarque/DocV4/KosmosV4System/hardware/Trépied/2D/Tube horizontale.pdf

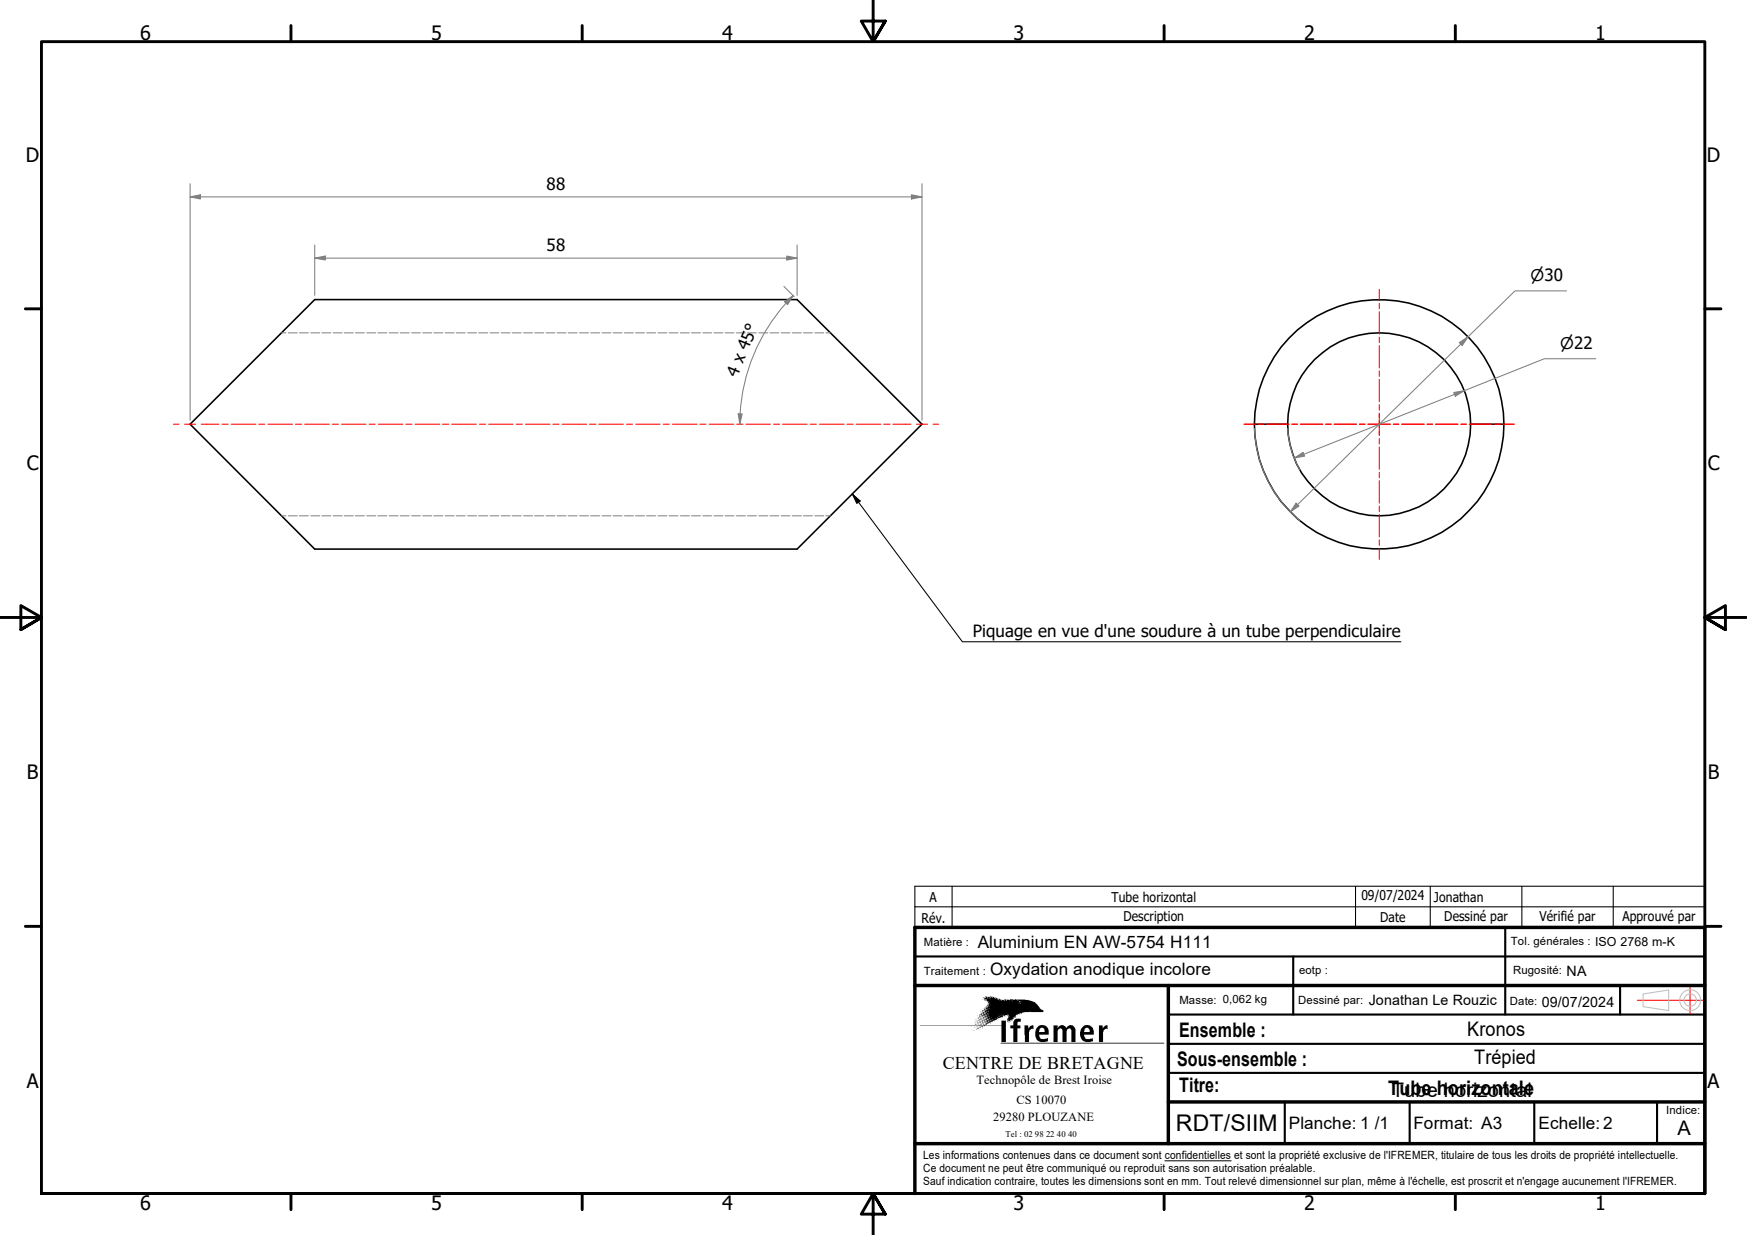
[picture p326: page 1]
Matière :; Tol. générales :; Sous-ensemble :; Ensemble :; Tube horizontale; ISO 2768 m-K; Format: A3; Echelle: 2; Tube horizontal; Jonathan; Rév.; Description; Date; Dessiné par; Vérifié par; Approuvé par

Piquage en vue d'une soudure à un tube perpendiculaire

luminium EN AW-5754 H111

Traitement : Oxydation anodique incolore | eotp : | Rugosité: NA

CENTRE DE BRETAGNE Technopôle de Brest Iroise CS 10070 29280 PLOUZANE Tel : 02 98 22 40 40 | Masse: 0,062 kg | Dessiné par: Jonathan Le Rouzic | 09/07/2024 Date:

Les informations contenues dans ce document sont confidentielles et sont la propriété exclusive de l'IFREMER, titulaire de tous les droits de propriété intellectuelle.
Ce document ne peut être communiqué ou reproduit sans son autorisation préalable.
Sauf indication contraire, toutes les dimensions sont en mm. Tout relevé dimensionnel sur plan, même à l'échelle, est proscrit et n'engage aucunement l'IFREMER.
