ofauvarque/DocV4/KosmosV4System/hardware/Trépied/Trépied.pdf

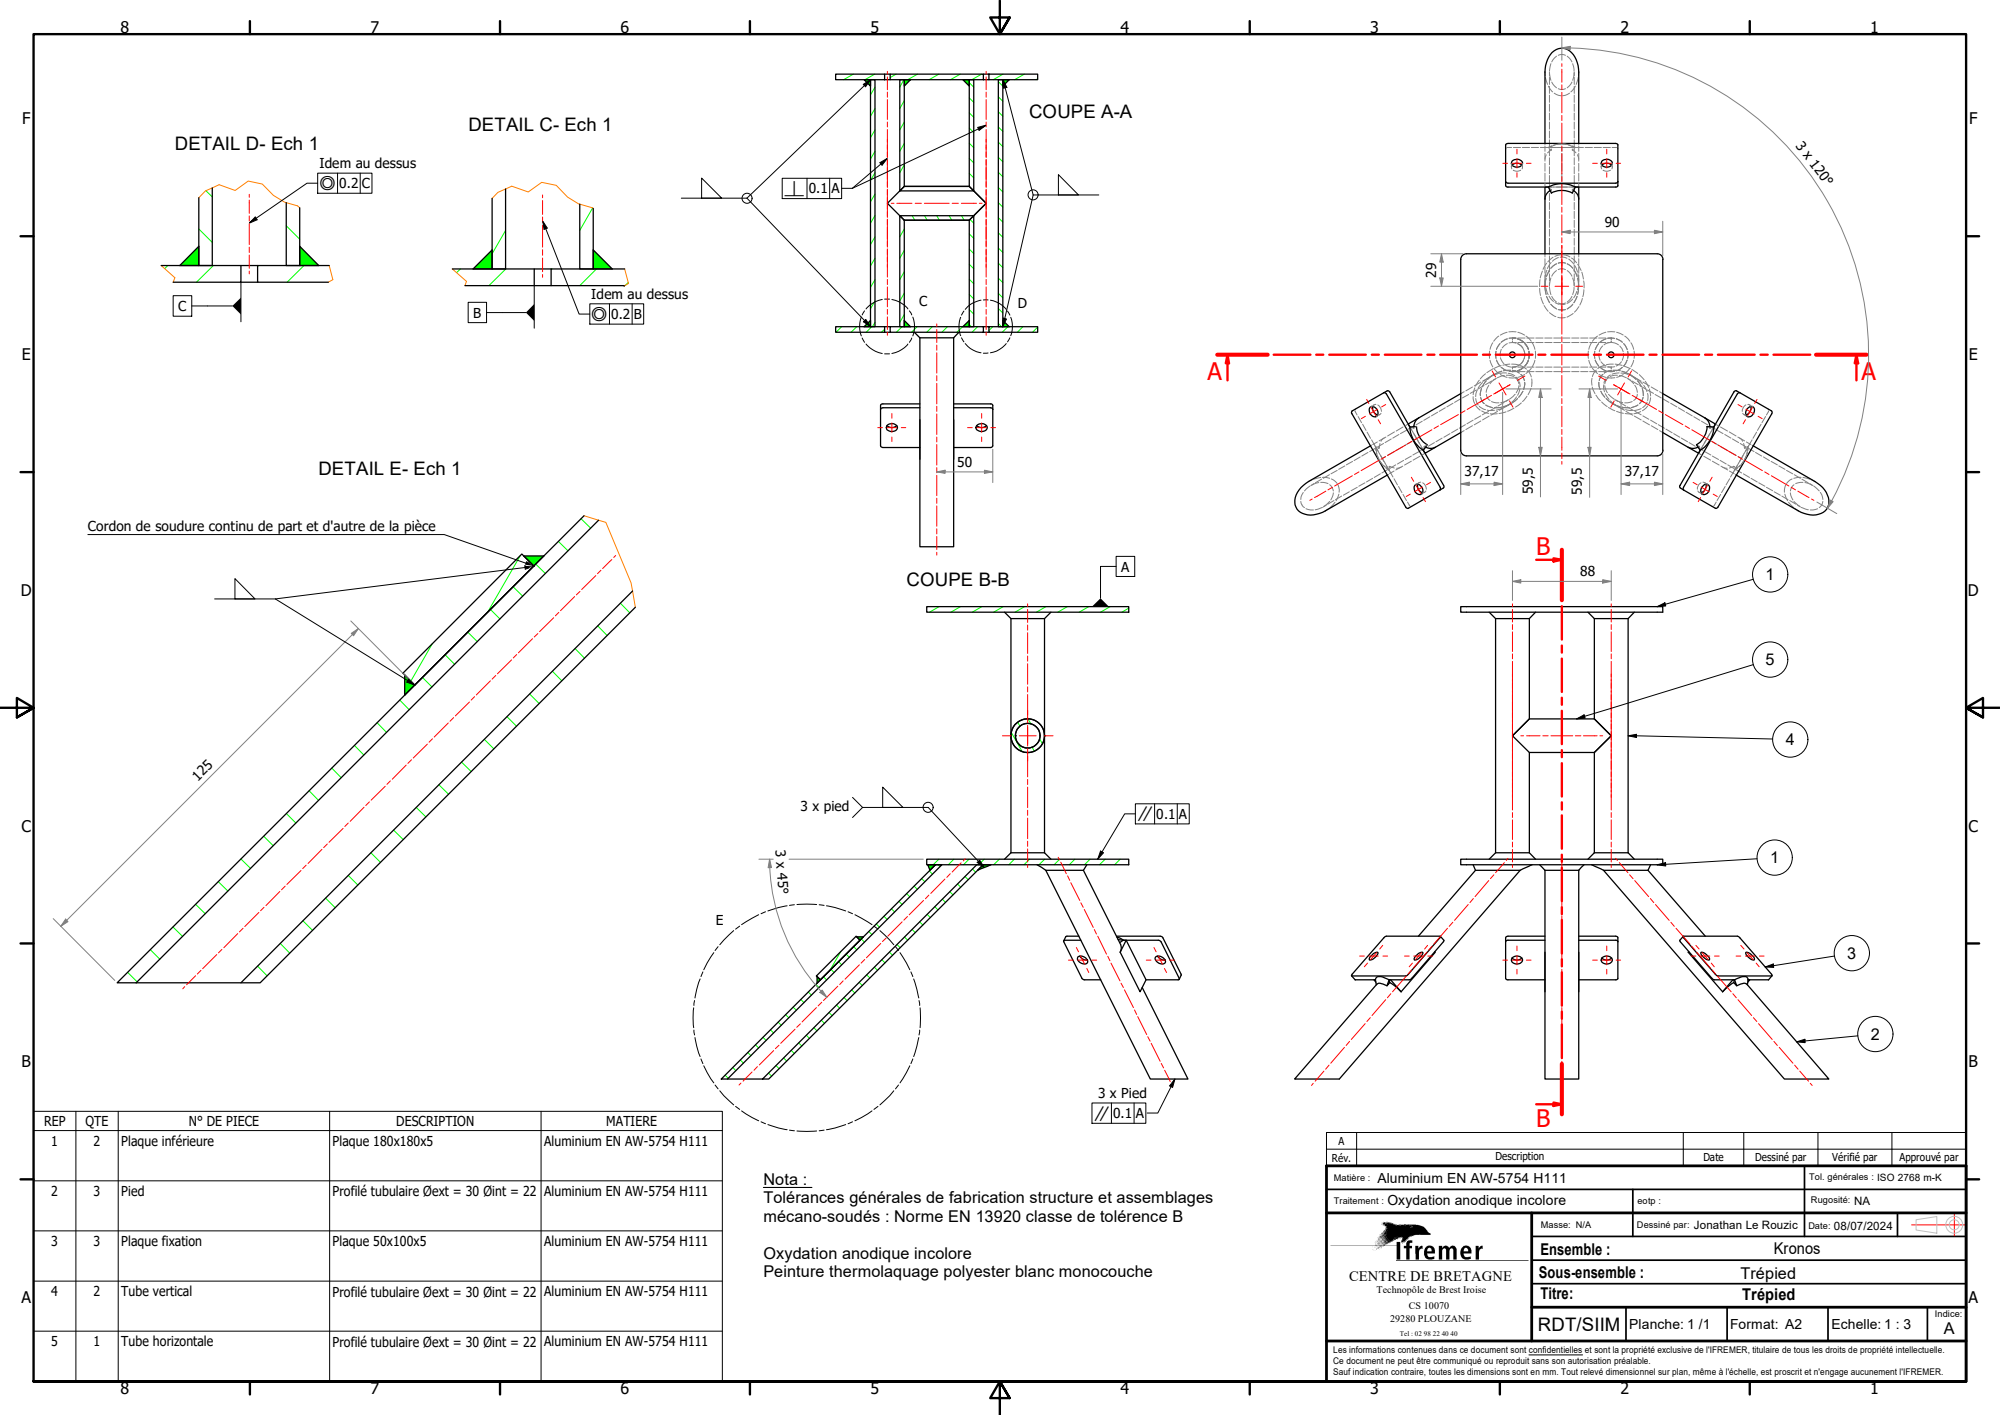
[picture p327: page 1]
COUPE A-A; COUPE B-B; DETAIL C- Ech 1; DETAIL D- Ech 1; DETAIL E- Ech 1; REP; QTE; N° DE PIECE; DESCRIPTION; MATIERE; Plaque inférieure; Plaque 180x180x5; Aluminium EN AW-5754 H111; Tube vertical; Profilé tubulaire Øext = 30 Øint = 22; Tube horizontale; Sous-ensemble :; Ensemble :; Format: A2; Echelle: 1 : 3; 3 x Pied ∥ 0.1 A; 3 x pied

Idem au dessus

Cordon de soudure continu de part et d'autre de la pièce

Rév. | Description | Date | Dessiné par | Vérifié par | Approuvé par

Nota :
Tolérances générales de fabrication structure et assemblages
mécano-soudés : Norme EN 13920 classe de tolérence B

Matière : A luminium EN AW-5754 H111 | Tol. générales : ISO 2768 m-K

2 | 3 | Pied | Profilé tubulaire Øext = 30 Øint = 22 | Aluminium EN AW-5754 H111

Oxydation anodique incolore Traitement : | eotp : | NA Rugosité:

CENTRE DE BRETAGNE Technopôle de Brest Iroise CS 10070 29280 PLOUZANE Tel : 02 98 22 40 40 | Masse: N/A | Dessiné par: Jonathan Le Rouzic | Date: 08/07/2024

3 | 3 | Plaque fixation | Plaque 50x100x5 | Aluminium EN AW-5754 H111

Oxydation anodique incolore
Peinture thermolaquage polyester blanc monocouche

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
