ofauvarque/DocV4/KosmosV4System/doc/pictures/V4_Moteur/Motor_PCB_KOSMOS.kicad_sch.pdf

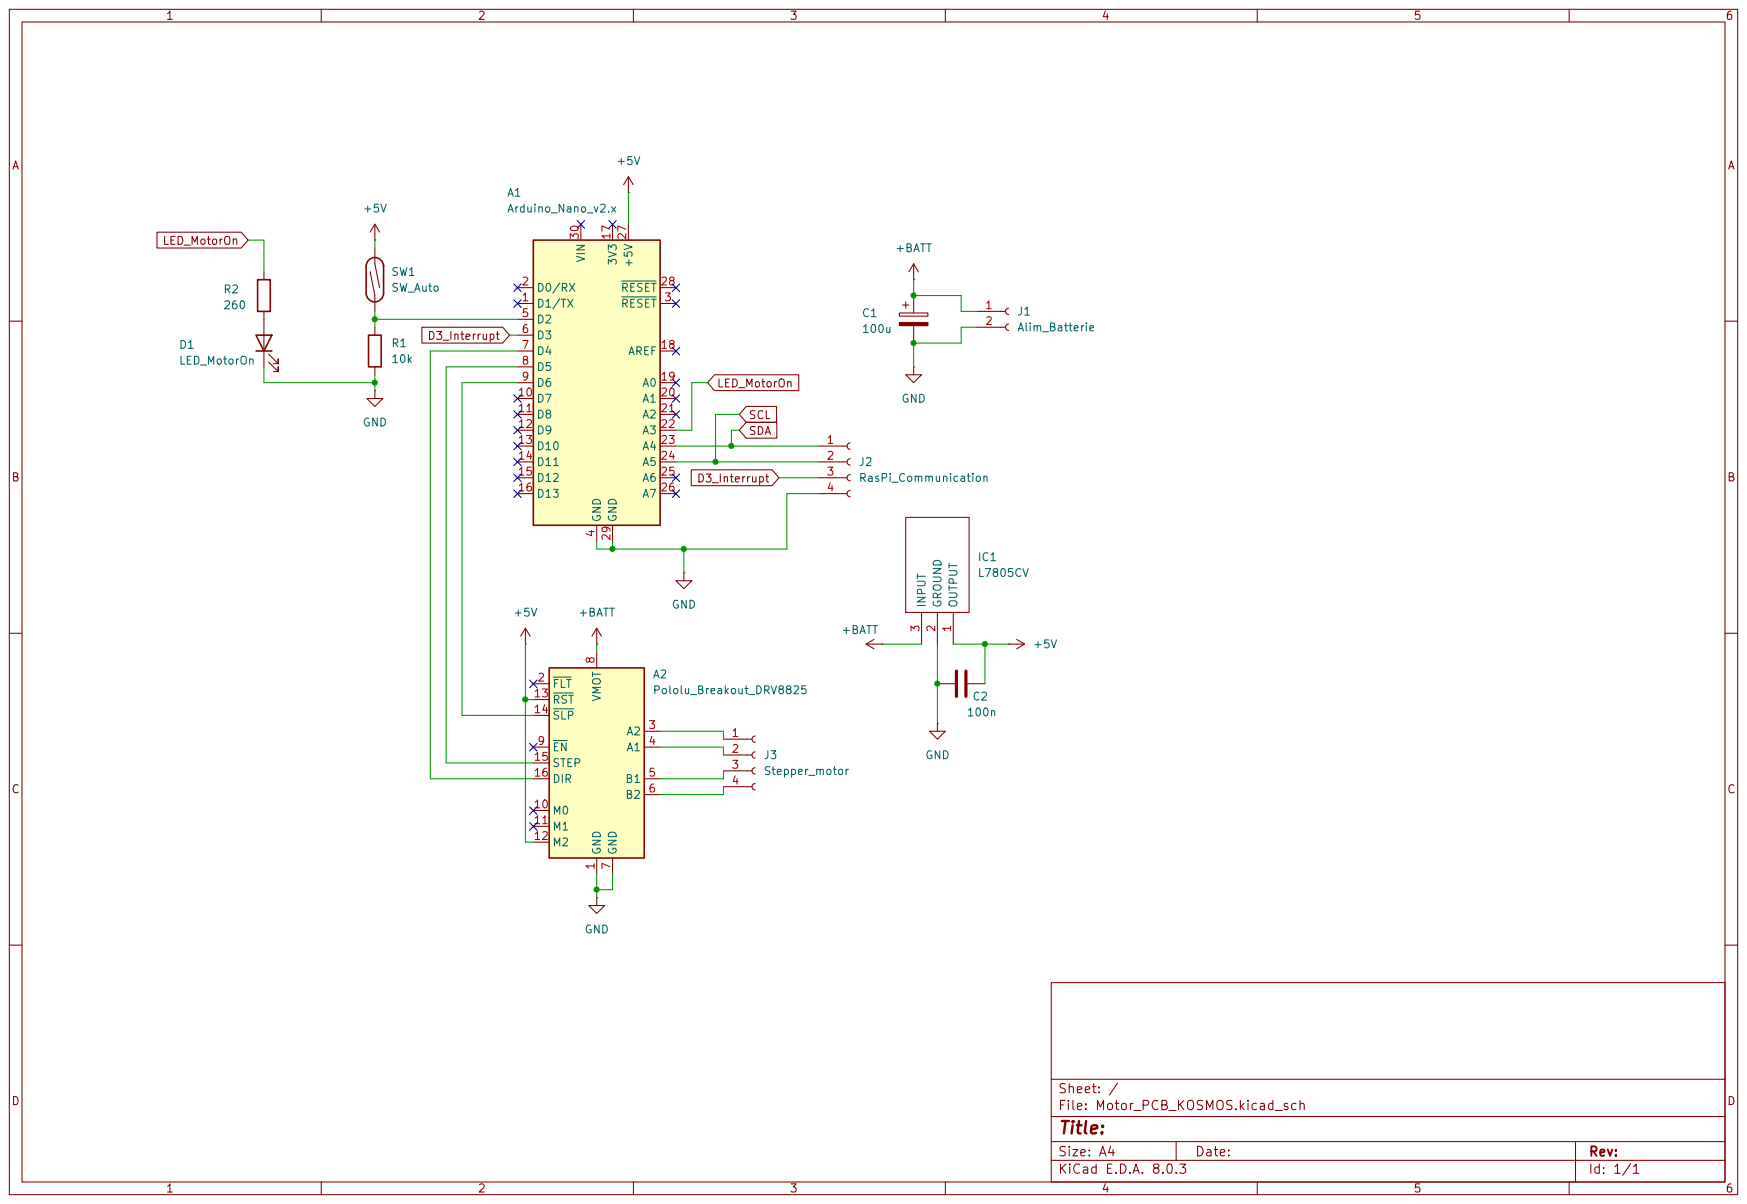
[picture p328: page 1]
