ofauvarque/DocV4/KosmosV4System/hardware/CartesElectroniques/RPi_PCB_v4.0_KAL/RPi_PCB_KOSMOS_4.0_uptodate - Copie/RPi_PCB_KOSMOS_4.0_v2.kicad_pcb

## KiCad design KosmosV4System/hardware/CartesElectroniques/RPi_PCB_v4.0_KAL/RPi_PCB_KOSMOS_4.0_uptodate - Copie/RPi_PCB_KOSMOS_4.0_v2.kicad_pcb (2025-07-15)

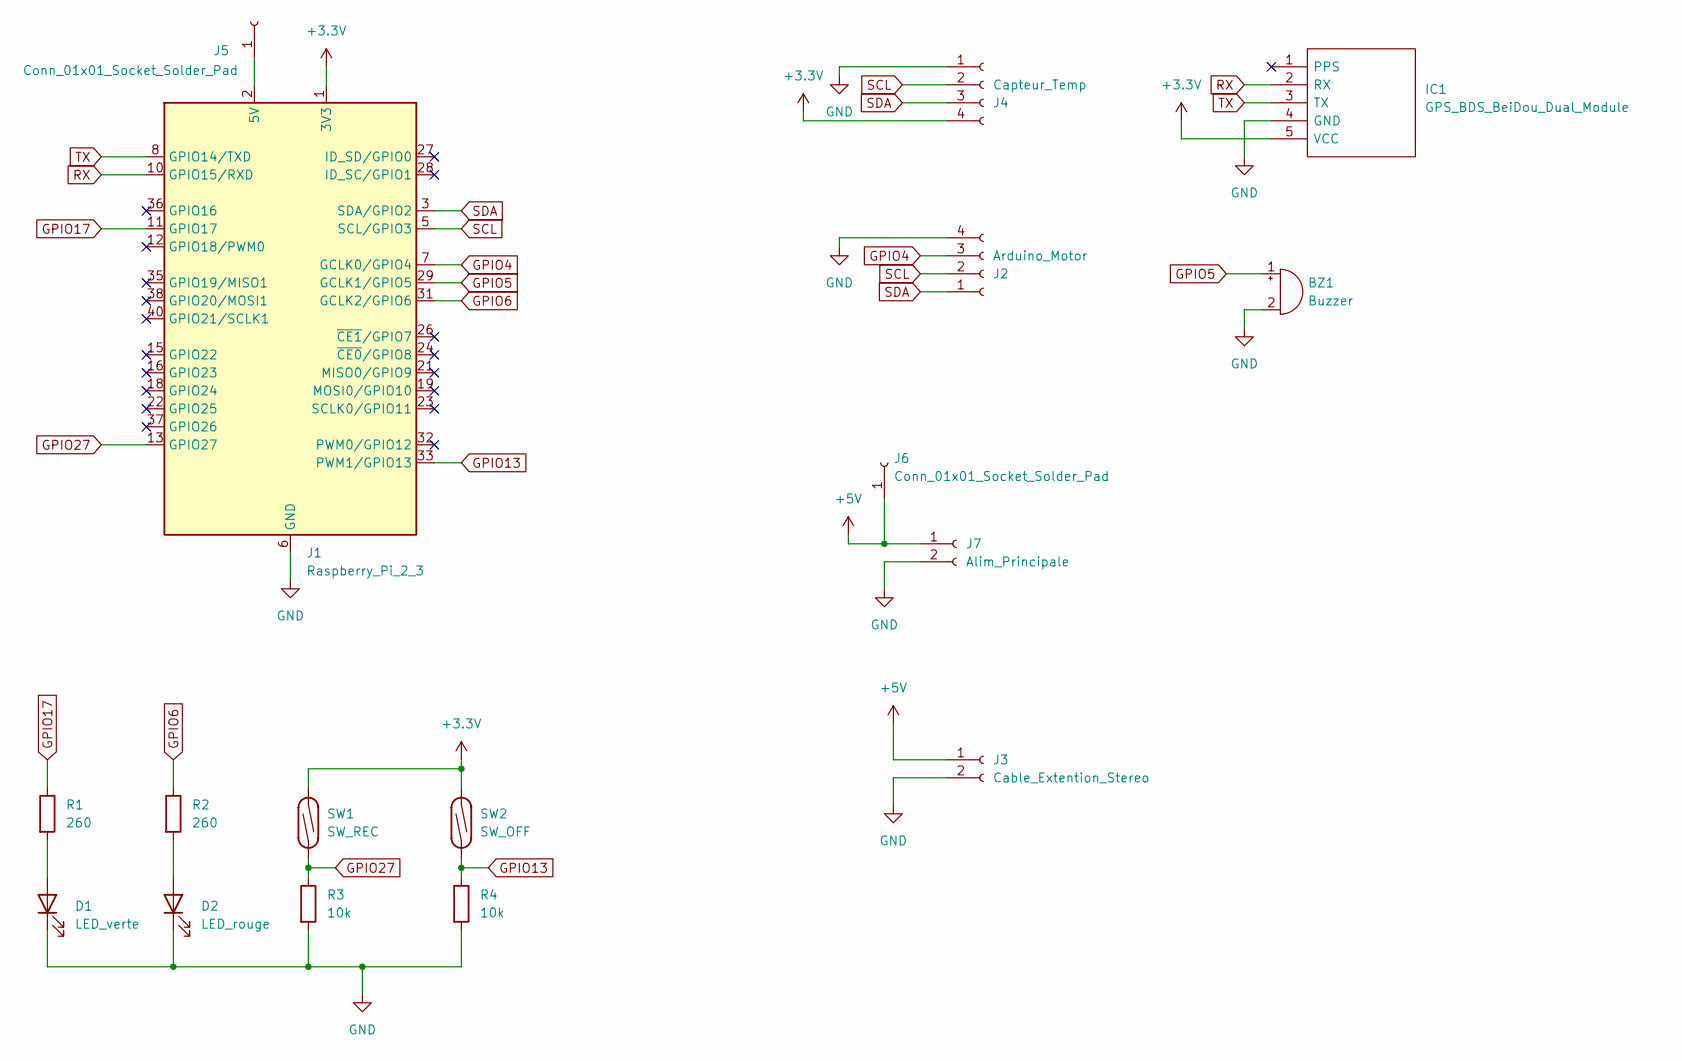
[picture p331: schematic RPi_PCB_KOSMOS_4.0_v2.kicad_sch]

Parts:
BZ1: Buzzer; Buzzer_D16.8_H8.2_P10_v2.2
D1: LED_verte; LED_D5.0mm_v2.2mm
D2: LED_rouge; LED_D5.0mm_v2.2mm
IC1: GPS_BDS_BeiDou_Dual_Module; GPS_BDS_BeiDou_Dual_Module_v2.2mm
J1: Raspberry_Pi_2_3; PinSocket_2x20_P2.54mm_Vertical_pad2.2mm
J2: Arduino_Motor; JST_EH_S4B-EH_1x04_P2.50mm_Horizontal_kosmos
J3: Cable_Extention_Stereo; JST_EH_S2B-EH_1x02_P2.50mm_Horizontal_kosmos
J4: Capteur_Temp; JST_EH_S4B-EH_1x04_P2.50mm_Horizontal_kosmos
J5, J6: Conn_01x01_Socket_Solder_Pad; TestPoint_Pad_4.0x4.0mm_KOSMOS
J7: Alim_Principale; TerminalBlock_bornier-2_P5.08mm_v3mm
R1, R2: 260; R_Axial_DIN0207_L6.3mm_D2.5mm_P10.16mm_Horizontal_v2.2mm
R3, R4: 10k; R_Axial_DIN0207_L6.3mm_D2.5mm_P10.16mm_Horizontal_v2.2mm
SW1: SW_REC; R_Axial_DIN0207_L6.3mm_D2.5mm_P13.24mm_Horizontal_v2mm
SW2: SW_OFF; R_Axial_DIN0207_L6.3mm_D2.5mm_P13.24mm_Horizontal_v2mm

Connections:
+3.3V: IC1.5 (VCC), J1.1 (3V3), J1.17 (3V3), J4.4, SW1.2, SW2.2
+5V: J3.1, J6.1, J7.1
GND: BZ1.2 (-), D1.1 (K), D2.1 (K), IC1.4 (GND), J1.6 (GND), J1.9 (GND), J1.14 (GND), J1.20 (GND), J1.25 (GND), J1.30 (GND), J1.34 (GND), J1.39 (GND), J2.4, J3.2, J4.1, J7.2, R3.2, R4.2
GPIO4: J1.7 (GCLK0/GPIO4), J2.3
GPIO5: BZ1.1 (+), J1.29 (GCLK1/GPIO5)
GPIO6: J1.31 (GCLK2/GPIO6), R2.1
GPIO13: J1.33 (PWM1/GPIO13), R4.1, SW2.1
GPIO17: J1.11 (GPIO17), R1.1
GPIO27: J1.13 (GPIO27), R3.1, SW1.1
unnamed: D1.2 (A), R1.2
unnamed: D2.2 (A), R2.2
unnamed: J1.2 (5V), J1.4 (5V), J5.1
RX: IC1.2 (RX), J1.10 (GPIO15/RXD)
SCL: J1.5 (SCL/GPIO3), J2.2, J4.2
SDA: J1.3 (SDA/GPIO2), J2.1, J4.3
TX: IC1.3 (TX), J1.8 (GPIO14/TXD)

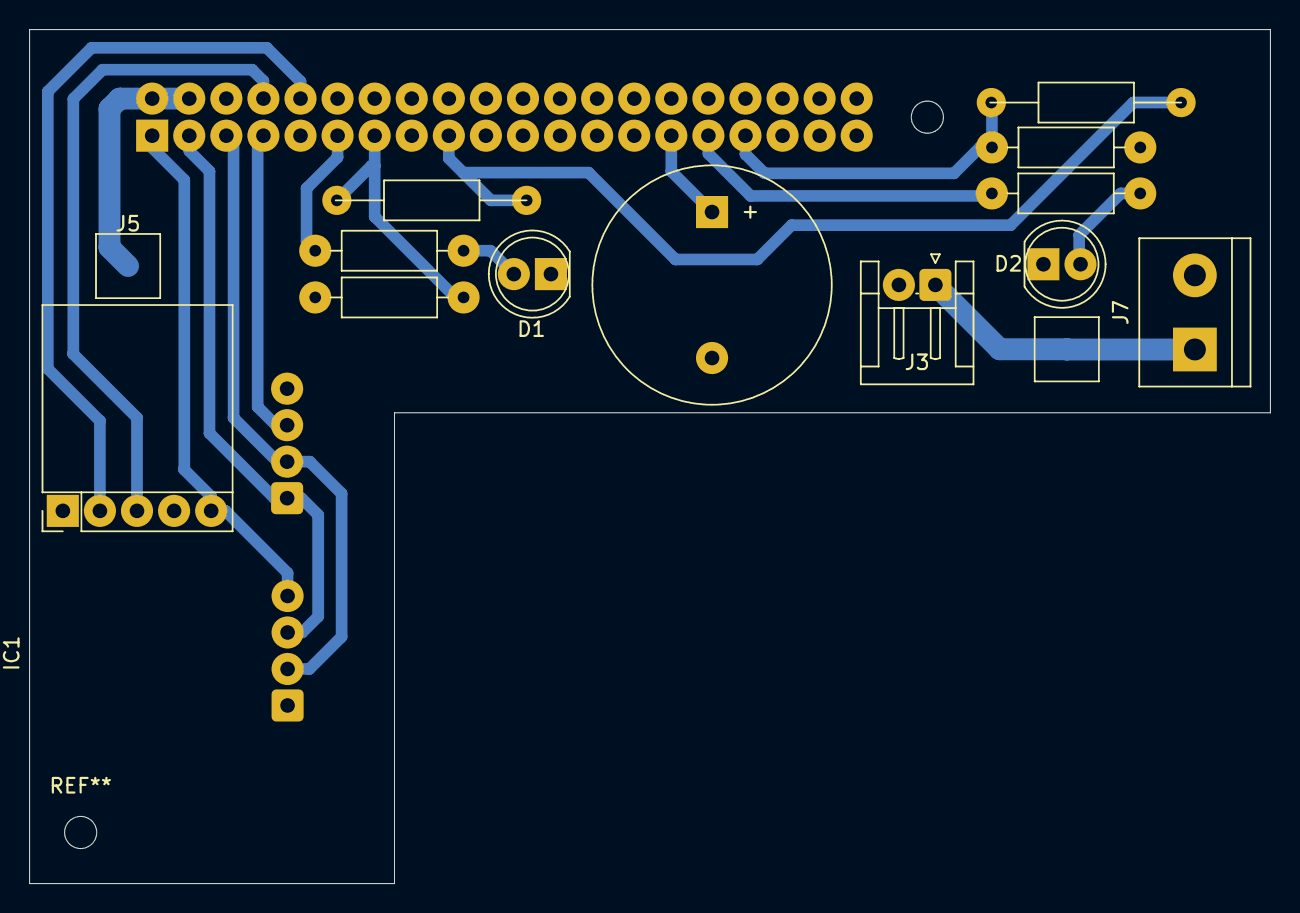
[picture p332: board KosmosV4System/hardware/CartesElectroniques/RPi_PCB_v4.0_KAL/RPi_PCB_… from above]

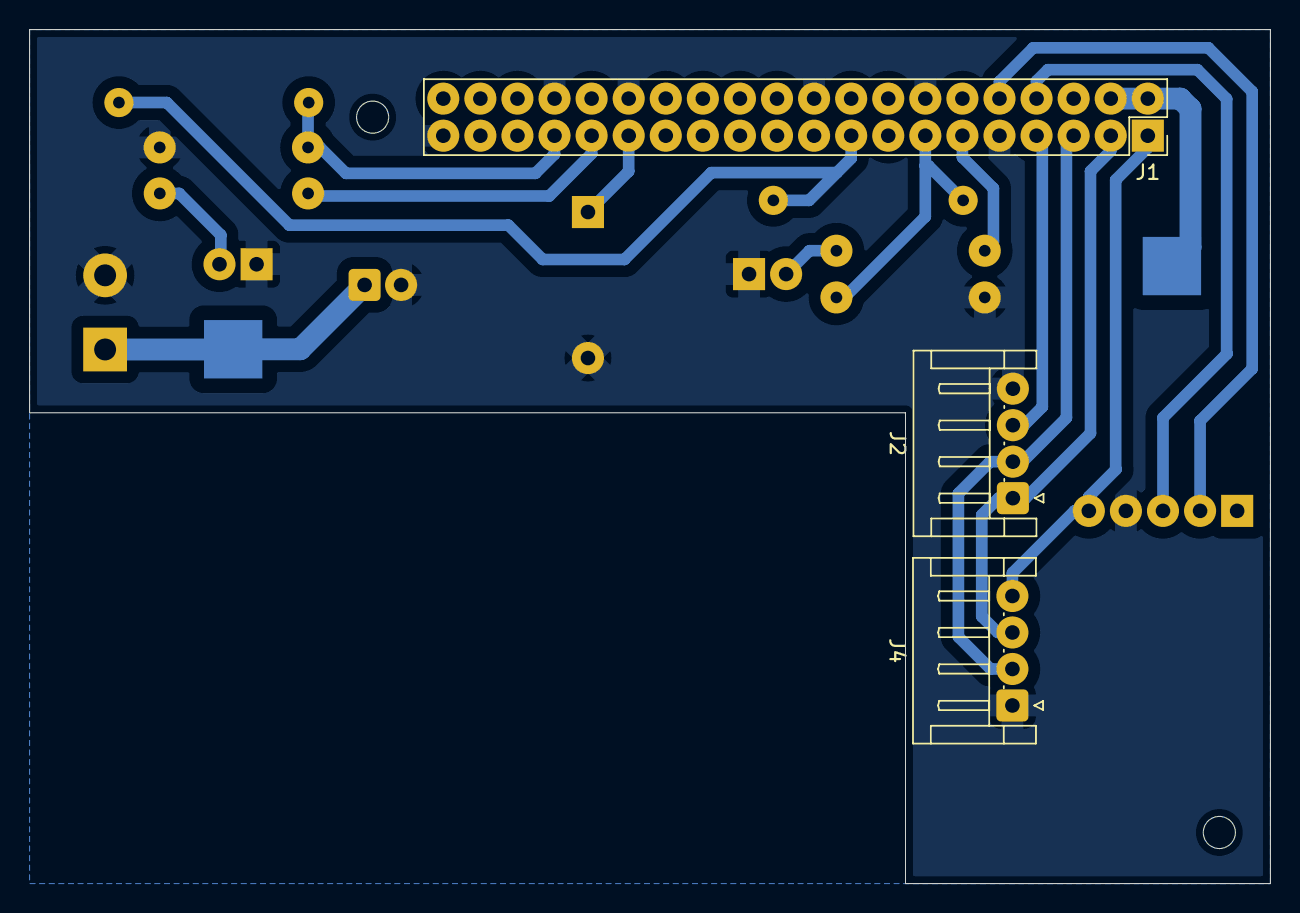
[picture p333: board KosmosV4System/hardware/CartesElectroniques/RPi_PCB_v4.0_KAL/RPi_PCB_… from below]

Board: 2 copper layers, 85.0 x 58.5 mm, 17 parts (3 on the bottom side), 16 nets.
