ofauvarque/DocV4/KosmosV4System/hardware/CartesElectroniques/Motor_PCB/Motor_PCB_KOSMOS_uptodate - Copie/Motor_PCB_KOSMOS.kicad_pcb

## KiCad design KosmosV4System/hardware/CartesElectroniques/Motor_PCB/Motor_PCB_KOSMOS_uptodate - Copie/Motor_PCB_KOSMOS.kicad_pcb (2025-07-15)

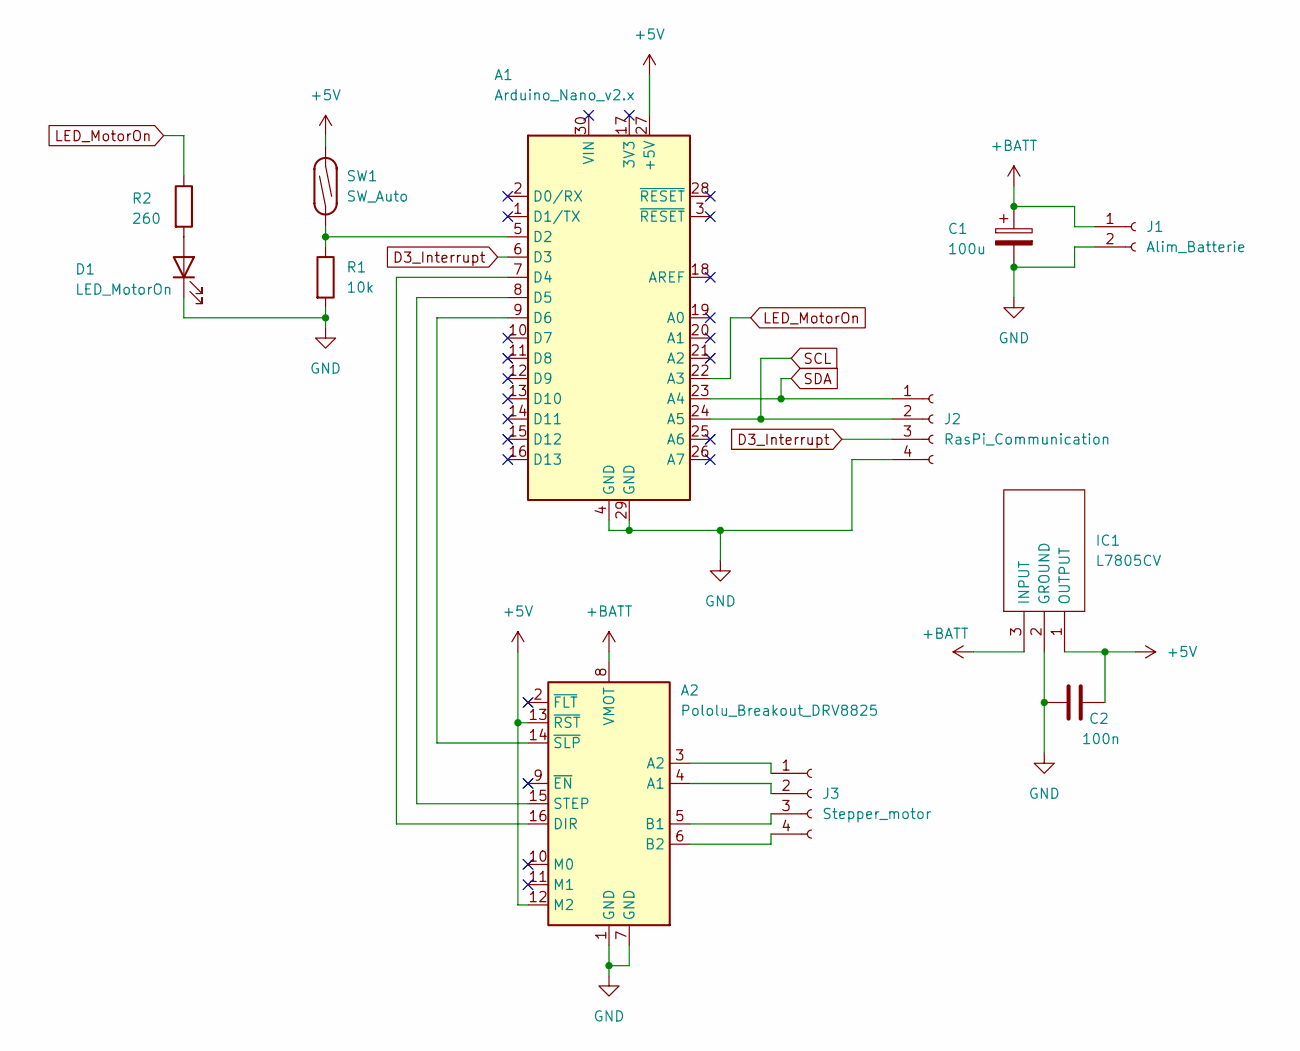
[picture p334: schematic Motor_PCB_KOSMOS.kicad_sch]

Parts:
A1: Arduino_Nano_v2.x; Arduino_Nano_v2.2mm
A2: Pololu_Breakout_DRV8825; Pololu_Breakout-16_15.2x20.3mm_v2.2mm
C1: 100u; CP_Radial_D5.0mm_P2.50mm_v2.2mm
C2: 100n; C_Rect_L7.0mm_W2.5mm_P5.00mm_v2.2mm
D1: LED_MotorOn; LED_D5.0mm_v2.2mm
IC1: L7805CV; L7805CV_v2.2mm; Manufacturer_Part_Number L7805CV; Mouser Part Number 511-L7805CV
J1: Alim_Batterie; TerminalBlock_bornier-2_P5.08mm_v3mm
J2: RasPi_Communication; JST_EH_B4B-EH-A_1x04_P2.50mm_Vertical_v2.2mm
J3: Stepper_motor; JST_EH_B4B-EH-A_1x04_P2.50mm_Vertical_v2.2mm
R1: 10k; R_Axial_DIN0207_L6.3mm_D2.5mm_P10.16mm_Horizontal_v2.2mm
R2: 260; R_Axial_DIN0207_L6.3mm_D2.5mm_P10.16mm_Horizontal_v2.2mm
SW1: SW_Auto; R_Axial_DIN0207_L6.3mm_D2.5mm_P15.24mm_Horizontal_v2mm

Connections:
+5V: A1.27 (+5V), A2.12 (M2), A2.13 (~RST), C2.2, IC1.1 (OUTPUT), SW1.2
+BATT: A2.8 (VMOT), C1.1, IC1.3 (INPUT), J1.1
D3_Interrupt: A1.6 (D3), J2.3
GND: A1.4 (GND), A1.29 (GND), A2.1 (GND), A2.7 (GND), C1.2, C2.1, D1.1 (K), IC1.2 (GROUND), J1.2, J2.4, R1.2
LED_MotorOn: A1.22 (A3), R2.1
unnamed: A1.5 (D2), R1.1, SW1.1
unnamed: A1.7 (D4), A2.16 (DIR)
unnamed: A1.8 (D5), A2.15 (STEP)
unnamed: A1.9 (D6), A2.14 (~SLP)
unnamed: A2.4 (A1), J3.2
unnamed: A2.3 (A2), J3.1
unnamed: A2.5 (B1), J3.3
unnamed: A2.6 (B2), J3.4
unnamed: D1.2 (A), R2.2
SCL: A1.24 (A5), J2.2
SDA: A1.23 (A4), J2.1

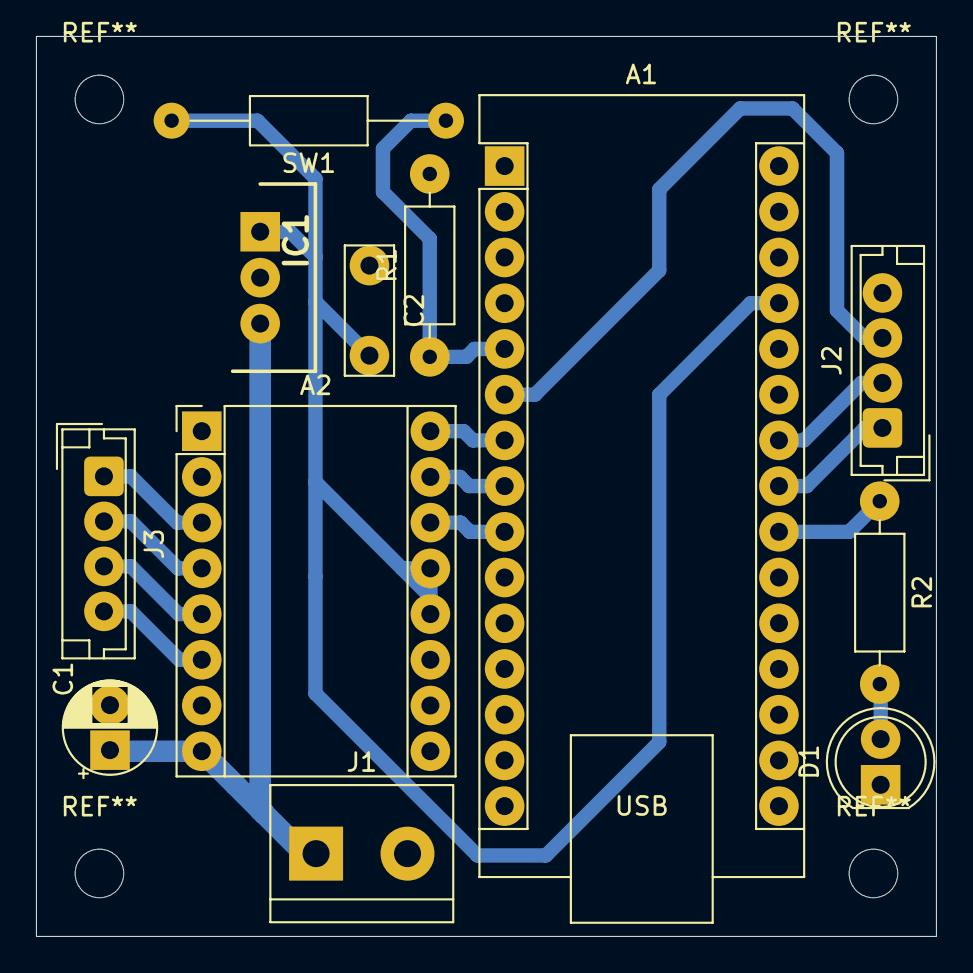
[picture p335: board Motor_PCB_KOSMOS.kicad_pcb from above]

Board: 2 copper layers, 50.0 x 50.0 mm, 12 parts (0 on the bottom side), 16 nets.
