ofauvarque/DocV4/(commit log)

2025-01-29 MaJ Sourcing
    [Nomenclature_KOSMOS4.0_projet_IUEM_22_11_2024_Complet.xlsx, Nomenclature_KOSMOS4.0_projet_IUEM_29_01_2025.xlsx]
2025-02-05 Maj Session 3 V4 iUEM
    [Nomenclature_KOSMOS4.0_projet_IUEM_29_01_2025.xlsx]
2025-06-30 Add MagPi
    [Nomenclature_MagPI.ods, magpi_big_camera.stl, magpi_small_camera.stl]
2025-09-15 version alexandre
    [Entretoise_RPI.SLDPRT, Entretoise_RPI.STL, Module_DC_DC.SLDPRT, Pack_batterie.SLDPRT, cadre.SLDPRT, cadre.STL, montant_73mm.SLDPRT, montant_73mm.STL]
2025-09-17 ajout cao v4
    [double_berceau.f3d, double_berceau.stl, support_batterie.f3d, support_batterie.stl]
2025-11-30 ojpûiop
    [RPi_PCB_KOSMOS_4.0_v2.kicad_pcb, RPi_PCB_KOSMOS_4.0_v2.kicad_sch]
